vitobruncic-blip/zavrsni/dokumenti/zavrsni.tex

\documentclass[12pt, a4paper, oneside]{report}

% Podrška za hrvatski jezik (važno za kvačice i nazive poput "Sadržaj")
\usepackage[utf8]{inputenc}
\usepackage[english, croatian]{babel}
\usepackage[T1]{fontenc}

\usepackage[margin=1.25cm]{geometry} % Postavi margine prema Word predlošku
\usepackage{setspace}
\onehalfspacing % Prored 1.5

\usepackage[scaled]{helvet}
\renewcommand*\familydefault{\sfdefault} % Postavlja bezserifni font kao zadani za cijeli dokument

\begin{document}
\begin{titlepage}
    \begin{center}
        \setstretch{1.0} % Resetiraj prored na 1 za naslovnicu
        
        \Large SVEUČILIŠTE U ZAGREBU \\[0.2cm]
        \textbf{\Large FAKULTET ELEKTROTEHNIKE I RAČUNARSTVA}
        
        \vfill % Gura sadržaj prema sredini
        
        \large ZAVRŠNI RAD br. 72
        
        \vspace{2cm}
        
        % Naslov mora biti boldan i velik
        \textbf{\huge BATERIJSKO MJERILO SNAGE PRIMLJENOG SIGNALA ZA SUSTAV ZA FOTOPLETIZMOGRAFIJU} \\[0.3cm]
        
        \vspace{1.5cm}
        
        \large Vito Brunčić
        
        \vfill % Gura dno stranice prema dolje
        
        \large Zagreb, lipanj 2026. % Ažurirao sam na tvoju trenutnu godinu
        
    \end{center}
\end{titlepage}

% Nakon naslovnice resetiraj prored na 1.5 ako ti je to uvjet za tekst
\onehalfspacing 
\newpage
