vitobruncic-blip/zavrsni/dokumenti/Bruncic_Vito.docx

SVEUČILIŠTE U ZAGREBU

FAKULTET ELEKTROTEHNIKE I RAČUNARSTVA

ZAVOD ZA ELEKTRONIČKE SUSTAVE I OBRADBU INFORMACIJA

PROJEKT IZ PREDMETA
PROJEKTIRANJE ELEKTRONIČKIH SUSTAVA

BATERIJSKO MJERILO SNAGE PRIMLJENOG SIGNALA ZA SUSTAV ZA FOTOPLETIZMOGRAFIJU

Student: Vito Brunčić

JMBAG: 0036557057

Zagreb, 11.6.2026

# Sadržaj

# 1. Područje primjene i namjena uređaja

Uređaj „Baterijsko mjerilo snage primljenog signala za sustav za pletizmografiju“, namjenjen je za detekciju i kvantifikaciju snage primljenog analognog signala u sustavima koji koriste tehnologiju komunikacije ljudskim tijelom (engl. Intra-Body Communication – IBC). Primarna funckija uređaja je dohvat i analogna obrada fotopletizmografskih signala. Fotopletizmografija je metoda optičkog bilježenja promjene volumena, a u kontekstu ovog uređaja, dohvaćeni fotopletizmografski signal bilježi promjene volumena krvi.

Područje primjene ovog uređaja obuhvaća domenu biomedicinskog inženjerstva te služi kao eksperimentalna platforma za razvoj i testiranje nosivih medicinskih senzora za neinvanzivno praćenje vitalnih parametara. Sustav također nalazi primjenu kao alat za provjeru pouzdanosti prijenosa signala kroz ljudsko tkivo.

Izvedba uređaja s baterijskim napajanjem omogućuje potpuno galvansko odvajanje od distribucijske električne mreže, čime se smanjuje utjecaj mrežnih smetnji i popratnog šuma okoline. Takva izvedba omogućuje visoku osjetljivost i preciznost mjerenja signala niskih amplituda, što je ujedno i temeljni preduvjet za pouzdano korištenje tehnologije komunikacija ljudskim tijelom.

# 2. Blok shema

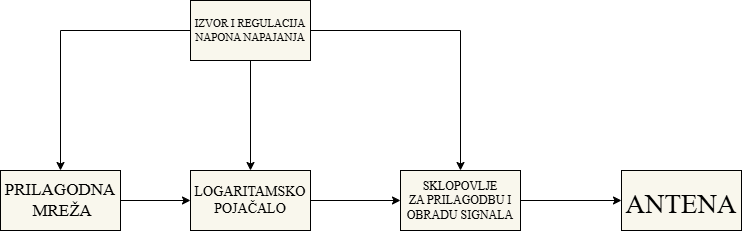
[picture p1: figure]

# 3. Električka shema

Slika 1: Hierarhijski prikaz kompletne električne sheme uređaja

Slika 2: Ulazna prilagodna mreža

Slika 3: Logaritamsko pojačalo

Slika 4: Sklopovlje za prilagodbu i obradu signala (Mikrokontroler STM32WB55CGU6)

Slika 5: Antena

Slika 6: Izvor i regulacija napona napajanja

# 4. Opis rada

I. ULAZNA PRILAGODNA MREŽA

Ulazna prilagodna mreža smještena je na početku sustava te služi za prilagodbu impedancije između prijenosnog medija i visokog ulaznog otpora sljedećeg stupnja. Integrirani sklop BUF602ID služi za transformaciju impedancije te izolaciju osjetljivog ulaznog signala. Sklop karakterizira visoka ulazna impedancija koja spriječava gušenje IBC signala s ljudskog tijela, te niska izlazna impedancija koja dodatno ne opterećuje ulaz logaritamskog pojačala. Uz propusni opseg od 250 MHz i brzinu odziva (engl. slew rate) od 8000 V/µs, BUF602ID omogućuje linearan prijenos napona nosioca od 21 MHz bez unošenja faznih izobličenja ili dodatne atenuacije.

II. LOGARITAMSKO POJAČALO

Na ulazu u logaritamsko pojačalo nalazi se još jedna prilagodna mreža koja se sastoji od otpora 52.3 Ω te dva paralelna kapaciteta od 100 nF koja služe za prilagodbu prijenosa na 50 Ω kako ne bi dolazilo do neželjene refleksije signala. Logaritamsko pojačalo AD8310 radi u pojasu do 440 MHz te može uspješno pojačati vrlo niske amplitude ulaznog napona. Na primjer, ako na ulazu u pojačalo imamo signal amplitude 22,4 mVrms, to jest ulazna snaga je -33 dBV, na izlazu ćemo prema formuli (4.1.), gdje je VY = 24 mV/dB ujedno i nagib našeg pojačala, a P0 = -108 dBV (3,98 µV), vrijednost pri kojoj će naš izlaz biti 0 V, dobiti ćemo izlazni napon VOUT = 1,8 V.

, V_(OUT) =V_Y ×(P_(IN) -P_0 )#(4.1.)

Kondenzatori C8 i C28 od 22 pF služe nam za filtriranje izlaza (BFIN priključak) te određivanje izlaznog niskopropusnog filtra (OFLT priključak). Oba kondenzatora su određena formulama koje se mogu pronači u tehničkoj specifikaciji logaritamskog pojačala.

III. SKLOPOVLJE ZA PRILAGODBU I OBRADU SIGNALA

Iz izlaza logaritamskog pojačala dolazimo do Schmittovog okidnog sklopa, 74AHC1G17GWH, kojem je primarna funkcija eliminirati šum koji može stvarati velike pogreške u obradi IBC signala koji su vrlo često niskih amplituda. Schmittov okidni sklop radi na principu histereze, s time da u odnosu na komparator, ima dva praga okida pomoću kojih eliminiramo mogućnost krivog očitanja impulsa. Mikrokontroler STM32WB55CGU6 prima signal preko priključka PA4 te se programira putem razvojnog okruženja STM32CubeIDE. Program se postavlja na samu jedinicu putem priključaka SWDIO i SWCLK. Testne točke PA8 i PA9 služe za provjeru ispravnosti rada mikrokontrolera. Takitilni prekidač S1 služi za paljenje i gašenje mikrokontrolera, a kao indikator rada služi svjetleća dioda D1, kojoj smo ograničili jačinu svijetlosti s otpornikom od 1500 Ω, te koja svijetli zeleno kada je mikrokontroler upaljen. Kristalni osicilator Y1 služi za zadavanje takta mikrokontroleru dok kristalni oscilator Y2 služi kao referenca vremena (engl. RTC signal). Kondenzatori od 100 nF i 100 pF služe kao blokadni kondenzatori za suzbijanje smetnji i kao skladište naboja u slučaju brzih promjena na ulazu sklopovlja, a mreža zavojnica i kondenzatora između pinova VLXSMPS I VFBSMPS služi kao prateći elementi internog SMPS pretvarača (engl. Step-down/buck) koje smo morali postaviti jer se na samom siliciju čipa mikrokontrolera one ne mogu postaviti.

IV. ANTENA

Iz priključka RF1 odlazimo do ulaza na integrirani prilagodni filtar harmonika (engl. Integrated Passive Device – IPD) koji služi za povezivanje između mikrokontrolera i prilagodne mreže antene za 2,4 GHz, odnosno Bluetooth prijenos. IPD1 također služi kao balun, to jest pretvornik diferencijalnog signala koji dobivamo na izlazu iz mikrokontrolera u nesmietrični 50-omski signal za antenu. Prije same antene postavljena je pasivna mreža na točno propisanim udaljenostima na tiskanoj pločici koje prilagođavaju signal na 50 Ω te garantiraju da ne dolazi do neželjenih refleksija signala.

V. IZVOR I REGULACIJA NAPONA NAPAJANJA

Kao primarni izvor napona koristi se Li-Ion akumulator nazivnog napona 3,7 V koji je izabran je prema ukupnoj potrošnji svih integriranih sklopova te nazivnom naponu koji mora biti dovoljno blizu naponu na izlazu iz stabilizatora kako se na njemu ne bi stvorila nepotrebno velika disipacija. Izračunata maksimalna ukupna potrošnja svih integriranih sklopova u sustavu je 24mA, te smo stoga izabrali akumulator čiji kapacitet pokriva minimalno 12 sati rada pritom imajući na umu da akumulator nije poželjno potpuno isprazniti jer se tako smanjuje njegova dugovječnost. Akumulator se spaja na sklop za održavanje i punjenje baterije BQ24040DSQR. Na njega je spojen USB-C konektor preko kojeg se baterija puni iz nekog drugog uređaja, primjerice iz računala. Moderni USB-C punjači ne daju nikakav napon sve dok ne osjete da je s druge strane spojen uređaj te upravo tome služe otpornici R12 i R14, koji su spojeni na masu te se ponašaju kao trošilo pa samim time USB-C punjač iz drugog uređaja krene davati stabilan napon VBUS. Otpornik R15 definira struju brzog punjenja, koju smo s otpornikom od 2200 Ω ograničili na 250 mA, čime smo osigurali stabilan omjer brzine punjena i potencijalnog pregrijavanja. Otpornik R11 definira struju završetka punjenja, kojim smo limitirali tu struju na 10% struje brzog punjenja, odnosno na 25 mA. Otpornici R10 i R12 su termistori koji mjenjaju otpor u odnosu na zagrijavanje sklopa te su postavljeni kako bi sklop registrirao konstantu idealnu temperaturu od 25 ⁰C. Svjetleća dioda D2 i otpornik R13 postavljeni su kako bi signalizirali ispravan rad izvora napajanja, a otpornikom R6 postavili smo da je maksimalna struja punjenja određena isključivo otpornikom R15. Linearni regulator TPS73633DBVR služi kako bi 3,7 V iz izvora napajanja pretvorio u stabilnih 3,3V koji su dovoljni za napajanje cijelog uređaja, a ostali kondenzatori su propisani iz tehničkih specifikacija samih sklopovlja kao optimalne zalihe naboja usred naglih promjena. Svjetleća dioda D3 i njen pridruženi otpornik R20 služe kao indikator ispravanog rada linearnog regulatora.

# 5. Tehnički podaci

I. NAPAJANJE I BATERIJA
- Vrsta napajanja: Li-Ion baterija, 3,7 V
- Nazivni kapacitet: 400mAh
- Napon analognog i digitalnog dijela: 3,3 V
- Prosječna struja potrošnje: 24mA
- Očekivano vrijeme rada s jednim ciklusom punjena: 17h
II. ANALOGNA OBRADA I KARAKTERISTIKE SIGNALA
- Frekvencija primljenog signala: 21 MHz
- Prilagodna mreža: 50 Ω
- Široki dinamički raspon: -91 dBV do 4 dBV
- Frekvencijski opseg izlaznog signala: 0 Hz do 2,1 MHz
III. MIKROKONTROLER I DIGITALNA OBRADA SIGNALA
- Model mikrokontrolera: STM32WB55CGU6
- Radni takt: 64 MHz
- Rezolucija AD-pretvornika: 12 bita
- Kapacitet programske memorije: 1 MB Flash
- Komunikacijsko sučelje: Bluetooth 5.4, (Bluetooth Low Energy – BLE)
IV. FIZIČKE I MEHANIČKE KARAKTERSTIKE
- Dimenzije tiskane pločice: 50 mm x 48 mm
- Broj slojeva tiskane pločice: 4 sloja
- Debljina pločice: 1,6 mm

# 6. Uputstvo za uporabu

I. PRIPREMA UREĐAJA I PROVJERA NAPAJANJA
- Provjera stanja baterije: Prije početka eksperimenta, potrebno je provjeriti je li uređaj napunjen, to jest, svijetli li svjetleća dioda BAT. Ukoliko ne svijetli potrebno je spojiti uređaj preko USB-C priključka na bilo koji uređaj sposoban za punjenje (prijenosno ili stolno računalo, punjač za mobitel sa USB-C izlazom) te pričekati dok se uređaj ne napuni.
II. POSTAVLJANJE SENZORA NA ISPITANIKA
- Priprema kože: mjesto na tijelu ispitanika gdje se postavlja elektroda potrebno je očistiti medicinskim alkoholom kako bi se smanjio otpor kože.
- IBC elektrode koja se spaja na SMA priključak uređaja treba biti čvrsto priljubljena uz kožu
III. POKRETANJE SUSTAVA I MJERENJE
- Prvo pokretanje: Prilikom prvog pokretanja uređaja potrebno je postaviti program preko SWDIO I SWCLK priključaka.
- Uključivanje uređaja: Pritisnite tipku označenu s USER na tiskanjoj pločici za pokretanje uređaja. Nakon nekoliko sekundi trebala bi zasvijetliti svjetleća dioda MCU koja označava da STM32WB55CGU6 mikrokontroler radi.
- Očitavanje i prijenos podataka: Za očitavanje i prijenos podataka potrebno je spojiti vanjsko računalo preko Bluetooth protokola sa mikrokontrolerom te pokrenuti aplikaciju za akviziciju podataka.
IV. ISKLJUČIVANJE I SKLADIŠTENJE
- Nakon završetka korištenja, isključite uređaj pritiskom tipke USER na tiskanoj pločici te pričekajte isključenje svjetleće diode MCU. Tako osiguravate duboko pražnjenje baterije.
- Pažljivo odvojite elektrode s tijela ispitanika te ih očistite suhom krpom ili maramicom.
- Uređaj skladištite na suhom i tamnom mjestu, izvan dohvata jakih elektromagnetskih smetnji koje bi s vremenom mogle utjecati na točnost uređaja.

# 7. Sastavnica

Redni broj | Vrijednost | Oznaka komponente | Kućište | Opis | Oznaka proizvodača | Dobavljač | Cijena komponente (EUR) | Količina
1. | STM32WB55CGU6 | U3 | UFQFPN-48 | STM32 Mikrokontroler, 1,7-3,6V | STM32WB55CGU6 | Mouser | 7.06 | 1
2. | BUF602 | U1 | SOIC-8 | Integrirani Buffer | BUF602ID | Mouser | 5.82 | 1
3. | AD8310ARMZ-REEL7 | U2 | MSOP | Logaritamsko pojačalo | AD8310ARMZ-REEL7 | Mouser | 12.34 | 1
4. | BQ24040DSQR | U4 | WSON-10 | Sklop za punjenje, 800mA | BQ24040DSQR | Mouser | 0.79157 | 1
5. | TPS73633DBVR | U5 | SOT-23 | IC Regulator, 3,3V, 400mADC | TPS73633DBVR | Mouser | 2.16 | 1
6. | 74AHC1G17GWH | U6 | SOT353-1 | Integrirani Schmittov okidni sklop | 74AHC1G17GWH | Mouser | 0.10325 | 1
7. | MLPF-WB55-01E3 | IPD1 | SMD-6, 1,6x1 mm | RF Filtar, 2.4-2.5GHz | MLPF-WB55-01E3 | Mouser | 0.31835 | 1
8. | 2450AT18B100E | A1 | SMD-2, 3,8x1,8mm | Antena, 2.45GHz | 2450AT18B100E | Mouser | 1.39 | 1
9. | NX2016SA-32MHz | Y1 | 0805 | Kristalni oscilator 32KHz | NX2016SA-32M-EXS00A-CS06465 | Mouser | 0.499 | 1
10. | NX2012SA-32.768kHz | Y2 | 0805 | Kristalni oscilator, 32.768KHz | NX2012SA-32.768K-STD-MUB-1 | Mouser | 0.73134 | 1
11. | MPZ2012S601AT000 | FB1 | 0805 | Feritna perla, 600Ohm | MPZ2012S601AT000 | Mouser | 0.09464 | 1
12. | Zelena | D1, D2, D3 | 0805 | Dioda, svjetleća, 1,9V | SM0805GCL | Mouser | 0.499 | 3
13. | 100n | C1, C2, C3, C6, C7, C13, C14, C15, C16, C17, C19, C21, C24, C29, C30, C31 | 0805 | Kondenzator, X7R, 10%, 50VDC | MCJCU21GBB7104KTPA01 | Mouser | 0.215 | 16
14. | 10n | C5, C25 | 0805 | Kondenzator, C0G, 10%, 50VDC | C0805C103K5RECAUTO | Mouser | 0.2151 | 2
15. | 22p | C8, C28 | 0402 | Kondenzator, C0G, 1%, 50VDC | KAM05ACG1H220FH | Mouser | 0.27533 | 2
16. | 15p | C10, C11 | 0805 | Kondenzator, C0G, 10%, 160VDC | 08052U150JAT2A | Mouser | 0.30114 | 2
17. | 10u/16V | C12 | 1210 | Elektrolitski kondenzator, Ta, 10%, 16V | EEV106M035A9DAA | Mouser | 0.28393 | 1
18. | 4u7 | C18, C22 | 0805 | Kondenzator, C0G, 10%, 50VDC | CGA4J1X7R1H475K125AC | Mouser | 0.48182 | 2
19. | 100p | C20 | 0402 | Kondenzator, C0G, 2%, 100VDC | GCM1555C2A101GE02D | Mouser | 0.10325 | 1
20. | 1p2 | C23 | 0402 | Kondenzator, C0G, 10%, 50VDC | QSCF500Q1R2B1GV001T | Mouser | 0.13766 | 1
21. | 1u | C26, C27 | 0603 | Kondenzator, X7R, 10%, 50VDC | C1608X7R1H105K080AB | Mouser | 0.18929 | 2
22. | 10u | L1 | 0805 | Zavojnica, neoklopljena, 500mADC, | LSQBA201212T100KR | Mouser | 0.10325 | 1
23. | 10n | L2 | 0805 | Zavojnica, neoklopljena, +/-5%, 300mADC | AIMC-0805-10NJ-T | Mouser | 0.11185 | 1
24. | 3n3 | L3 | 0402 | Zavojnica, neoklopljena, 400mADC | L-07C3N6SV6T | Mouser | 0.163 | 1
25. | 2n7 | L4 | 0402 | RF zavojnica, neoklopljena, 300mADC | LRC0402CS2N7GV001T | DigiKey | 0.08604 | 1
26. | 49R9 | R1, R3, R7, R9 | 0805 | Otpornik, ±100ppm/C, 125mW | AC0805FR-0749R9L | Mouser | 0.01032 | 4
27. | 2k | R2, R11 | 0805 | Otpornik, 1%, 125mW | RC0805FR-102KL | Mouser | 0.01635 | 2
28. | 4R7 | R4 | 0805 | Otpornik, 1%, 125mW | AC0805FR-074R7L | Mouser | 0.08604 | 1
29. | 52R3 | R5 | 0805 | Otpornik, 1%, 125mW | RC0805FR-0752R3L | Mouser | 0.08604 | 1
30. | 0R0 | R6, R18, R19, R22 | 0603 | Otpornik, 1%, 100mW | MCMR04X000 PTL | Farnell | 0.00401 | 5
31. | 10k | R8 | 0805 | Otpornik, 5%, 125mW | RC0805JR-0710KL | Mouser | 0.18929 | 1
32. | 10k | R10 | 0402 | NTC Termistor, 1% | NTCG103JF103FT1 | Mouser | 0.08604 | 1
33. | 5k1 | R12, R14 | 0603 | Otpornik, ±100ppm/C, 100mW | AC0603FR-075K1L | Mouser | 0.01032 | 2
34. | 1k5 | R13, R16, R20 | 0805 | Otpornik, ±50ppm/C, 100mW | MCU08050C1501FP500 | Mouser | 0.07403 | 3
35. | 2k2 | R15 | 0805 | Otpornik, ±100ppm/C, 125mW | MCU08050C1501FP500 | Mouser | 0.07403 | 1
36. | 10k | R21 | TH-2, 3,7x2,54 mm | NTC Termistor, 1% | 103AT-2 | Mouser | 0.538 | 1
37. | USB4135-GF-A | J1 | SMD-10, 11,14x6,78mm | USB-C priključak | USB4135-GF-A | Mouser | 0.58507 | 1
38. | TL3301AF160QG | S1 | SMD-4, 6x6mm | Taktilni prekidač | TL3301AF160QG | Mouser | 0.29254 | 1
39. | 4POS HDR | X2 | SMD-10, 16x2,5mm | Header 1x4 | 68001-204HLF | Mouser | 0.34416 | 1

# 9. Položajni nacrt komponenata

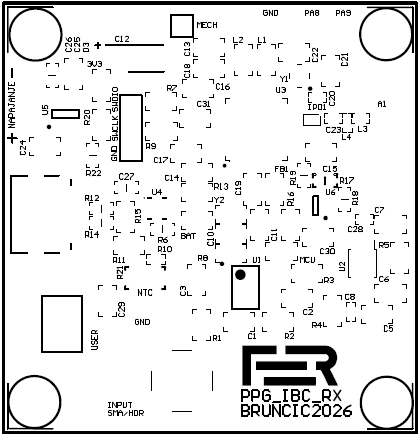
[picture p2: figure]

Slika 7: Položajni nacrt komponenata – Komponentna (engl. top) strana; mjerilo M2:1

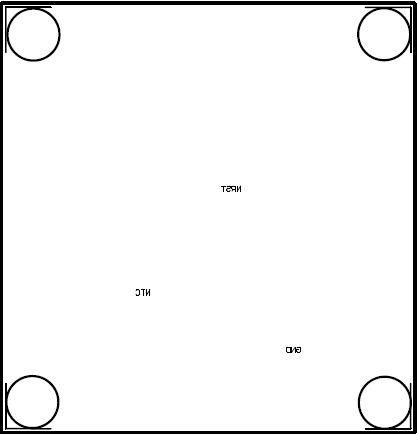
[picture p3: figure]

Slika 8: Položajni nacrt komponenata - Lemna (engl. bottom) strana; mjerilo M2:1

# 10. Nacrt tiskanih veza

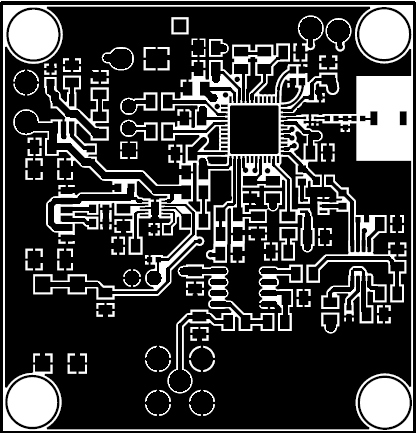
[picture p4: figure]

Slika 9: Nacrt tiskanih veza - Komponentna (engl. top) strana; mjerilo M2:1

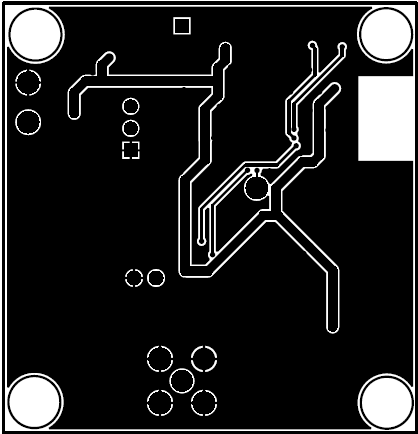
[picture p5: figure]

Slika 10: Nacrt tiskanih veza - Lemna (engl. bottom) strana; mjerilo M2:1

# 11. Plan bušenja

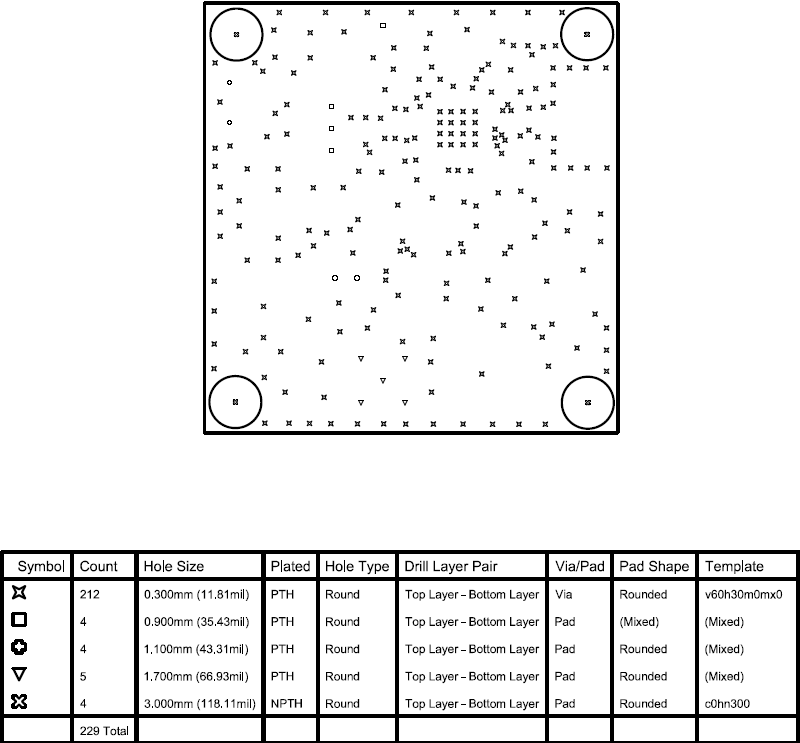
[picture p6: figure]

Slika 11: Plan bušenja; mjerilo M2:1

Vito Brunčić, 0036557057 8

Vito Brunčić, 0036557057 11

Projektiranje elektroničkih sustava
