vitobruncic-blip/zavrsni/dokumenti/zavrsni_VB_ver3.pdf

### SVEUCILIŠTE U ZAGREBU ˇ FAKULTET ELEKTROTEHNIKE I RACUNARSTVA ˇ

### ZAVRŠNI PROJEKT

# BATERIJSKO MJERILO SNAGE

# PRIMLJENOG SIGNALA ZA

# SUSTAV ZA

# FOTOPLETIZMOGRAFIJU

### Vito Brunci ˇ c´

Zagreb, srpanj 2026.

Zahvaljujem mentorici izv. prof. dr. sc. Željki Luˇcev Vasi´c i asistentu Luki Klai´cu

na ukazanom povjerenju, struˇcnom vodstvu i steˇcenom znanju tijekom ovog projekta.

Hvala obitelji, curi Luciji i prijateljima na podršci tijekom dosadašnjeg studija.

iii

## SADRŽAJ

1. Uvod | 1
2. Teorijska podloga | 3
3. Arhitektura prijamnika sustava za fotopletizmografiju | 6
3.2. Logaritamsko pojacalo | ˇ | 7
4. Opis tiskane plocice | 13 ˇ
4.1. Fizikala svojstva plocice i raspored komponenata | ˇ | 13
4.3. Upute za korištenje plocice | ˇ | 16
5. Rezultati | 18
6. Zakljucak | 19 ˇ
Literatura | 20
7. Prilog A: Tehnicka dokumentacija | 23 ˇ

iv

# 1. Uvod

Kardiovaskularne bolesti i dalje su vodeci uzrok smrtnosti u svijetu, što stvara impera- ´

tiv za razvojem neinvazivnih, jeftinih i pouzdanih metoda za pracenje rada srca i cirku- ´

lacije. Eksponencijalni razvoj nosivih (engl. wearable) senzorskih sustava za kontinu-

irano pracenje vitalnih znakova pacijenta potaknuo je promjenu u svijetu biomedicin- ´

ske elektronike. Tradicionalne metode pracenja zdravstvenog stanja unutar bolni ´ | ckih ˇ

uvjeta sve se više zamjenjuju personaliziranim, autonomnim uredajima koji omogu- ¯

cuju dugotrajni nadzor pacijenata u njihovom svakodnevnom okruženju. Dva klju ´ | | cna ˇ
stupa takvih sustava cine fotopletizmografija (engl. ˇ | photoplethysmography, PPG) kao

metoda senziranja te komunikacija unutar ljudskog tijela (IBC) kao inovativna metoda

prijenosa podataka.

U klasicnim nosivim mrežama, BAN (engl. ˇ | | Body Area Network), prijenos podataka

izmedu senzora na tijelu i centralne jedinice (poput pametnog telefona) u pravilu se os- ¯

lanja na radiofrekvencijske (RF) tehnologije kao što su Bluetooth Low Energy (BLE)

ili Wi-Fi. Iako su standardizirane, RF tehnologije pokazuju znacajne nedostatke u ne- ˇ

posrednoj blizini ljudskog tijela. Ljudsko tkivo vecinskim se dijelom sastoji od vode, ´

koja snažno apsorbira i raspršuje RF signale na frekvencijama oko 2,4 GHz. Stoga,

zbog velikog slabljenja u tkivu, RF odašiljaci moraju trošiti znatnu energiju iz baterije ˇ

kako bi osigurali pouzdanu vezu. Takoder, RF valovi zra ¯ | ce u svim smjerovima oko ˇ
tijela, omogucuju ´ | ci potencijalno prisluškivanje (engl. ´ | eavesdropping) osjetljivih medi-

cinskih podataka.

Kao odgovor na te probleme razvija se komunikacija unutar ljudskog tijela (IBC), koja

koristi samo ljudsko tijelo kao prijenosni medij (vodic) za elektri ˇ | cne signale. Elektro- ˇ

magnetsko polje ostaje u potpunosti "zakljucano" unutar i neposredno uz površinu ti- ˇ

jela. Prednosti IBC-a u odnosu na RF su znatno manje gušenje na nižim frekvencijama

(tipicno od nekoliko stotina kHz do nekoliko desetaka MHz), gdje tkivo pruža stabil- ˇ

niji i povoljniji medij. Buduci da signal ne mora zra ´ | citi u slobodan prostor, sklopovi ˇ

za IBC odašiljace i prijamnike mogu raditi s višestruko manjom potrošnjom energije, ˇ

što drasticno produljuje vijek trajanja baterije. IBC komunikacija tako ˇ | | der osigurava ¯

visoku dozu privatnosti podataka jer se signal ne širi izvan tijela, cime se postiže har- ˇ

dverska imunost na prisluškivanje s udaljenosti.

U drugom poglavlju ovog završnog rada biti ce objašnjena teorijska podloga potrebna ´

za razumijevanje fotopletizmografije i prijenosa signala ljudskim tijelom. Nakon toga,

bit ce dan opis arhitekture pojedinih dijelova prijamnika signala za sustav za fotople- ´

tizmografiju. U cetvrtom poglavlju bit ˇ | ce opisana tiskana plo ´ | cica razvijena u sklopu ˇ

ovog završnog rada. U danjim poglavljima bit ce opisani rezultati mjerenja na sustavu ´

te ce se iz tih mjerenja izvesti zaklju ´ | cci. U prilogu je dana tehni ˇ | cka dokumentacija ˇ

razvijene tiskane plocice. ˇ

# 2. Teorijska podloga

## 2.1. Princip fotopletizmografije

Fotopletizmografija (PPG) je opticka metoda koja se koristi za neinvazivno mjerenje ˇ

promjena u volumenu krvi unutar mreže kapilara u tkivu. Sama metoda temelji se na

Beer-Lambertovom zakonu, koji definira matematicki odnos izme ˇ | du apsorpcije svje- ¯

tlosti i svojstava medija kroz koji svjetlost prolazi. Prema tom zakonu, intenzitet tran-

smitiranog svjetla eksponencijalno opada s koncentracijom apsorbirajuce tvari i dulji- ´

nom optickog puta. ˇ

U ljudskom tkivu, primarni apsorber (kromofor) u crvenom i infracrvenom spektru je

hemoglobin u krvi. Kako srce pumpa krv kroz tijelo, stvara se pulsni val koji uzro-

kuje periodicke promjene u volumenu arterijske krvi unutar tkiva (npr. u prstu ili ušnoj ˇ

resici). Te promjene volumena izravno moduliraju kolicinu svjetlosti koja se apsor- ˇ

bira, odnosno propušta kroz tkivo. Rezultirajuci fotopletizmogram sastoji se od dvije ´

kljucne komponente: istosmjerne i izmjeni ˇ | cne komponente. Istosmjerna (engl. DC ˇ | ,

Direct Current) predstavlja konstantnu apsorpciju svjetlosti u staticnim strukturama ˇ

kao što su kosti, mišici, koža, te konstantni volumen venske krvi. Ova komponenta ´

stvara relativno visok istosmjerni napon na izlazu fotodetektora. Izmjenicna (engl. ˇ | AC,

Alternating Current) predstavlja dinamiku pulsnih promjena volumena arterijske krvi

sinkroniziranih sa srcanim ciklusom (sistola i dijastola). Ova komponenta je iznimno ˇ
male amplitude, tipicno ˇ | cine ˇ | ci svega ´ | 1% do 2% ukupnog detektiranog signala.
Upravo ta kombinacija izmjenicne i istosmjerne komponente ˇ | cini temelj za pulsnu ˇ
oksimetriju – metodu neinvazivnog mjerenja zasicenosti krvi kisikom SpO ´ | 2. Buduci´

da oksihemoglobin HbO2 i deoksihemoglobin Hb razlicito apsorbiraju svjetlost u cr- ˇ

venom (tipicno ˇ | 660 nm) i infracrvenom spektru (tipicno ˇ | 940 nm), pulsni oksimetar

mjeri amplitude AC i DC komponenti na obje valne duljine. Izracunom omjera tih ˇ

komponenti, poznatijeg kao ”omjer omjera” (engl. ratio-of-ratios), eliminira se utjecaj

staticnih tkiva i izolira se isklju ˇ | civo doprinos arterijske krvi, što omogu ˇ | cuje precizno ´
odredivanje udjela zasi ¯ | cenog hemoglobina. ´

Zbog tako nepovoljnog omjera AC i DC komponente, primarni inženjerski izazov pri

projektiranju pripadajuceg PPG poja ´ | cala bio je razvoj analognog sklopa koji ˇ | ce us- ´
pješno izolirati i pojacati isklju ˇ | civo slabašnu AC komponentu koja nosi informaciju ˇ

promjeni volumena krvi, dok istovremeno prigušuje DC komponentu koja u kontekstu

fotopletizmografije, ne sadrži bitnu informaciju.

## 2.2. Kapacitivni IBC

Komunikacija unutar ljudskog tijela (engl. IBC, Intra-Body Communication) predstav-

lja inovativan pristup bežicnim mrežama na tijelu (BAN) gdje se ljudsko tkivo koristi ˇ

kao medij za prijenos elektricnog signala. Za razliku od klasi ˇ | cnih radiofrekvencijskih ˇ

(RF) antena koje energiju zrace u slobodan prostor oko korisnika, IBC sustavi lokali- ˇ

ziraju elektromagnetsko polje na samo tijelo. S fizikalnog stajališta, ljudsko se tijelo

ponaša kao kompleksni vodic s izraženim dielektri ˇ | cnim svojstvima, sastavljen od vode, ˇ

elektrolita i organskih makromolekula. Na frekvencijama koje se koriste u IBC teh-

nologiji (100 kHz do nekoliko desetaka MHz) unutrašnjost tijela pruža znatno znatno

vodljiviji put u usporedbi sa slobodnim prostorom oko tijela, što omogucuje prijenos ´

podataka uz višestruko manju potrošnju energije na strani odašiljaca. Ovisno o na ˇ | cinu ˇ

na koji se signal injektira u tijelo i kako se zatvara strujni krug, IBC se dijeli na dvije

osnovne metode: galvanski i kapacitivni pristup.

U ovom završnom radu naglasak je stavljen na kapacitivni IBC sustav. Kod kapaci-

tivnog pristupa, odašiljac i prijamnik koriste diferencijalnu konfiguraciju sa samo po ˇ

dvije elektrode (signalna i referentna), koje ne moraju nužno biti u izravnom galvan-

skom kontaktu s kožom (moguce je mjerenje kroz odje ´ | cu). Primarni fizikalni mehani- ´

zam zatvaranja strujnog kruga odvija se kroz povratnu vezu koju te plutajuce elektrode ´

formiraju preko sitnih parazitnih kapaciteta spregnutih izmedu tijela korisnika i uzem- ¯

ljenja.

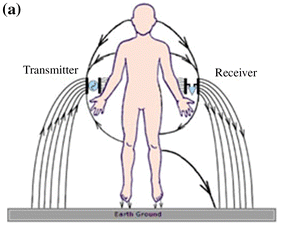
[picture p7: figure]

Slika 2.1. a) Prijenosni put kapacitivne IBC metode. [4]

Buduci da su ti parazitni kapaciteti iznimno mali (reda veli ´ | cine nekoliko pikofarada), ˇ

povratna veza predstavlja iznimno visoku impedanciju, što uzrokuje drastican pad am- ˇ

plitude signala na strani prijamnika. Zbog slabljenja signala i utjecaja vanjskog šuma,

ulazni stupanj prijamnika mora imati vrlo visoku ulaznu impedanciju te koristiti osjet-

ljiva pojacala širokog dinami ˇ | ckog raspona kako bi se primljeni signal uspješno rekons- ˇ

truirao.

# 3. Arhitektura prijamnika sustava za

# fotopletizmografiju

Baterijsko mjerilo snage primljenog signala za sustav za fotopletizmografiju sastoji se

od 5 dijelova:

1. Ulazna prilagodna mreža
2. Logaritamsko pojacalo ˇ
3. Sklopovlje za prilagodbu i obradu signala (Schmittov okidni sklop i mikrokontroler)
4. Antena
5. Izvor i regulacija napona napajanja

Uloga i nacin rada pojedinih dijelova detaljno su opisane u narednim poglavljima. Na ˇ

slici 3.1. prikazana je blok shema prijamnika signala za sustav za fotopletizmografiju.

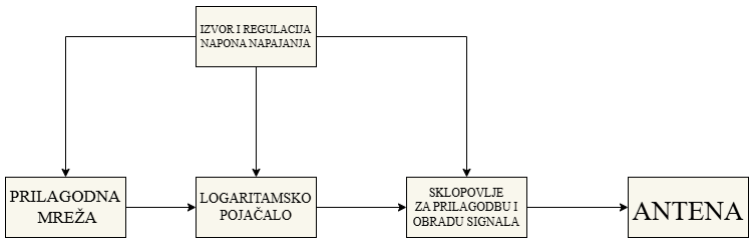
[picture p8: figure]

Slika 3.1. Blok shema prijamnika signala za sustav za fotopletizmografiju.

## 3.1. Ulazna prilagodna mreža

Ovaj prijamnik je dizajniran tako da na njegov ulaz dolazi fotopletizmografski signal

koji se prenosi pomocu signala nosioca od ´ | 21 MHz te je njegova amplituda modulirana

OOK modulacijskim postupkom (engl. On/Off keying amplitude modulation). Ulazna

prilagodna mreža smještena je na pocetku sustava te služi za prilagodbu impedancije ˇ

izmedu prijenosnog medija i visokog ulaznog otpora sljede ¯ | ceg stupnja. Zamišljeno je ´
da se signal dovodi preko SMA konektora koji je prilagoden na impedanciju od ¯ | 50 Ω

te se zbog toga prilagodna mreža svakog stupnja projektira za tu impedanciju. Alterna-

tivno, umjesto SMA prikljucka može se zalemiti klasi ˇ | cni muški priklju ˇ | cak na mjesto ˇ
središnjeg izvoda SMA konektora uz korištenje dodatnog muškog prikljucka ˇ | X4 za
mehanicku stabilizaciju. Za potrebu prilago ˇ | denja koriste se otpornici ¯ | R1 i R3 iznosa

49,9 Ω.

Naponsko slijedilo BUF602ID proizvoda¯ caˇ Texas Instruments služi za transformaciju

impedancije te izolaciju osjetljivog ulaznog signala. Sklop karakterizira visoka ulazna

impedancija koja sprjecava gušenje IBC signala s ljudskog tijela, te niska izlazna im- ˇ

pedancija koja dodatno ne opterecuje ulaz logaritamskog poja ´ | cala. Uz propusni opseg ˇ

od 250 MHz i brzinu porasta (engl. slew rate) od 8000 V/µs, BUF602ID omogucuje li- ´

nearan prijenos napona nosioca od 21 MHz bez unošenja faznih izoblicenja ili dodatne ˇ

atenuacije. Na slici 3.2. dana je blok shema korištenog naponskog slijedila. Otpornik

od 2 kΩ služi kako bi zajedno s kondenzatorom od 1 µF cinio visokopropusni filtar ˇ

prvog reda te postavlja staticke radne to ˇ | cke unutrašnjih tranzistora. ˇ

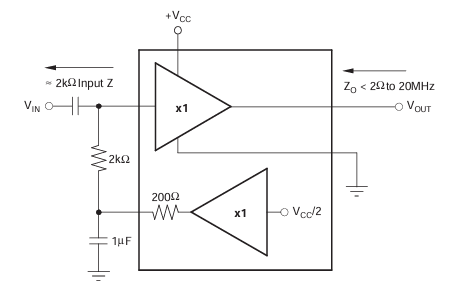
[picture p9: figure]

Slika 3.2. Blok shema naponskog sljedila BUF602ID. [6]

## 3.2. Logaritamsko pojacalo ˇ

Na ulazu u logaritamsko pojacalo nalazi se još jedna prilagodna mreža koja se sastoji ˇ

od otpornika otpora 52,3 Ω te dva kondenzatora od 100 nF koja zajedno impedancijom izvoda INHI i INLO služe za prilagodbu prijenosa na 50 Ω kako ne bi dolazilo do

neželjene refleksije signala. Odabrano logaritamsko pojacalo AD8310, proizvo ˇ | da¯ caˇ

Analog Devices radi u pojasu do 440 MHz te može uspješno pojacati vrlo niske am- ˇ

plitude ulaznog napona. Na slici 3.3. prikazan je osnovni preporuceni spoj za AD8310 ˇ

koji se nalazi u tehnickoj specifikaciji (engl. ˇ | datasheet) uredaja [1]. ¯

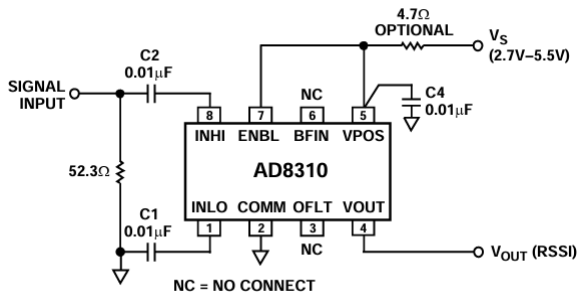
[picture p10: figure]

Slika 3.3. Osnovni spoj logaritamskog pojacala AD8310. [1] ˇ

Veza izmedu ulazne snage i izlaznog napona danog logaritamskog poja ¯ | cala dano je ˇ

jednadžbom (3.1.) .
VOUT = VY · (PIN − P0) | (3.1.)

gdje VOUT predstavlja izlazni demodulirani i filtrirani napon, VY = 24 mV/dB je nagib

prijenosne karakteristike pojacala (engl. ˇ | slope voltage), PIN je snaga ulaznog signala
izražena u dBm, dok P0 = −108 dBV (3,98 µVrms) vrijednost pri kojoj ce naš izlaz ´

biti 0 V, tj. presjecište karakteristike s osi snage (engl. intercept). Na primjer, ako na
ulazu u pojacalo imamo signal amplitude ˇ | 22,4 mVrms, to jest ulazna snaga je −33 dBV,
na izlazu cemo prema formuli (3.1.) dobiti izlazni napon ´ | VOUT = 1,8 V.
Kondenzator C8 spaja se na prikljucak ˇ | BFIN kako bi se smanjila nominalna širina

frekvencijskog pojasa izlaznog signala i time uspješno prigušilo valoviti dio napona

(engl. ripple) na izlazu logaritamskog pojacala. Prema preporuci proizvo ˇ | da¯ ca, njegova ˇ

vrijednost se odabire tako da granicna frekvencija filtra bude postavljena na jednu de- ˇ

setinu minimalne frekvencije ulaznog signala, cime se postiže optimalno filtriranje uz ˇ

ocuvanje brze reakcije sklopovlja na promjene razine signala, a za našu aplikaciju to je ˇ

frekvencija od 2,1 MHz. Prema formuli (3.2.) iz tehnicke specifikacije logaritamskog ˇ

pojacala [1] odredili smo približan iznos danog kapaciteta od ˇ | 22 pF.

CFILT =

1
2π · 3 kΩ · VideoBandwidth
− 2,1 pF | (3.2.)

Kondenzator C28 spaja se na prikljucak ˇ OFLT kako bi se snizila granicna frekvencija ˇ

unutarnje petlje za poništavanje istosmjernog pomaka (engl. offset control loop), cime ˇ

se sprjecava da ˇ | cip korisne ulazne signale nižih frekvencija pogrešno protuma ˇ | ci kao ˇ

ulazni napon pomaka i priguši. Njegova vrijednost je izracunata prema formuli (3.3.) ˇ

koja se takoder nalazi u tehni ¯ | ckoj specifikaciji logaritamskog poja ˇ | cala AD8310 [1]. ˇ
Za fCORNER je uzeta vrijednost od 2,1 MHz pri cemu je ˇ | COFLT = 22pF biran prema E12

nizu.

fCORNER =

1
2π · 2625 · COFLT

(3.3.)

## 3.3. Schmittov okidni sklop i mikrokontroler

Primarna funkcija Schmittovog okidnog sklopa 74AHC1G17GV, proizvoda¯ caˇ Nexpe-

ria je minimizirati smetnju i šum koji može stvarati eventualne pogreške pri analogno

digitalnoj konverziji i digitalizaciji signala za potrebe prijenosa na mikrokontroler. Sc-

hmittov okidni sklop radi na principu histereze, tj. u odnosu na klasicni komparator ˇ

ima dva praga okidanja pomocu kojih se eliminira mogu ´ | cnost krivog o ´ | citanja impulsa ˇ

uzrokovanih šumom. Prijenosna karakteristika te primjer obrade jednog tipa ulaznog

signala dani su slikom 3.4..

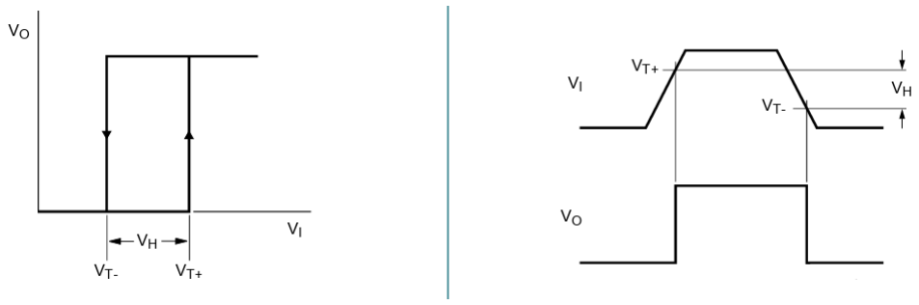
[picture p11: figure]

Slika 3.4. Prijenosna karakteristika (lijevo) i primjer rada Schmittovog okidnog sklopa

(desno). [3]

Mikrokontroler STM32WB55CGU6, proizvoda¯ caˇ STMicroelectronics prima signal putem izvoda PA4 te se programira putem razvojnog okruženja STM32CubeIDE. Pro-

gramski kod se ucitava u mikrokontroler putem izvoda ˇ | SWDIO i SWCLK. Korisnicke ˇ
ispitne tocke ˇ | PA8 i PA9 služe za provjeru ispravnosti rada mikrokontrolera. Slicno ˇ
tome, implementirana je i ispitna tocka za opcionalno spajanje na ˇ | NRST izvod mikro-

kontrolera. Tipkalo USER služi za paljenje i gašenje mikrokontrolera, a kao indikator

rada služi svjetleca dioda ´ | MCU, cija je ja ˇ | cina svjetlosti ograni ˇ | cena otpornikom od ˇ

1500 Ω.

Oscilator Y1 služi za zadavanje glavnog takta mikrokontroleru, dok kristal Y2 služi kao

referenca vremena (engl. RTC, Real-Time Clock signal). Kondenzatori od 100 nF i

100 pF služe kao blokadni kondenzatori za suzbijanje smetnji i kao skladište naboja u

slucaju naglih propada napona napajanja, a mreža zavojnica i kondenzatora izme ˇ | du iz- ¯
voda VLXSMPS i VFBSMPS služi kao prateci elementi internog prekida ´ | ckog izvora ˇ

napajanja (engl. SMPS, Switch Mode Power Supply) propusne topologije (engl. buck,

step-down) koje smo morali postaviti izvan cipa jer se na samom siliciju mikrokon- ˇ

trolera oni ne mogu realizirati. Vrijednosti tih elemenata propisane su u tehnickoj ˇ

dokumentaciji [5]. U tablici 3.1. navedeni su neki od kljucnih podataka i obilježja ˇ

mikrokontrolera STM32WB55CGU6.

Tablica 3.1. Tehnicke specifikacije mikrokontrolera STM32WB55CGU6. ˇ

Parametar | | Vrijednost
Model mikrokontrolera | | STM32WB55CGU6
Radni takt | | 64 MHz
Rezolucija AD-pretvorbe | 12 bita

Kapacitet programske memorije 1 MB Flash

Komunikacijsko sucelje | Bluetooth 5.4 ( ˇ | Bluetooth Low Energy – BLE)
Napon napajanja | 3,3 V

## 3.4. Antena

Iz prikljucka ˇ RF1 odlazimo do ulaza na integrirani prilagodni filtar harmonika (engl. In-

tegrated Passive Device - IPD) koji služi za povezivanje izmedu mikrokontrolera i pri- ¯

lagodne mreže antene za 2,4 GHz, odnosno za Bluetooth prijenos.
Sklop IPD1 takoder služi kao balun, to jest pretvornik diferencijalnog signala dobive- ¯
nog na izlazu iz mikrokontrolera u asimetricni ˇ | 50-omski signal za antenu. Prije same
antene postavljena je pasivna prilagodna mreža koje prilagodava karakteristi ¯ | cnu im- ˇ

pedanciju puta signala na 50 Ω te minimizira neželjene refleksije (bolje reci tako jer ´

nažalost ne garantira, ovisi o PCB dizajnu, kucištima komponenata, poziciji antene, ´

okolnim vodljivim objektima i sl.). Tocni modeli komponenata i dimenzije vodova ˇ

propisani su u tehnickoj dokumentaciji antene [2], a njihov je raspored prikazan na ˇ

slici 3.5.

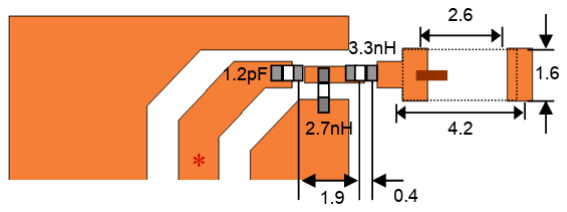
[picture p12: figure]

Slika 3.5. Razmještaj komponenta na tiskanoj plocici. [2] ˇ

## 3.5. Izvor i regulacija napona napajanja

Kao primarni izvor napajanja koristi se litij-ionski akumulator nazivnog napona 3,7 V,

koji se spaja na integrirani krug za upravljanje i punjenje akumulatora BQ24040DSQR.

Na sklop je povezan USB-C prikljucak putem kojega se akumulator može puniti iz ˇ

vanjskog izvora, primjerice racunala. ˇ

Moderni USB-C punjaci ne isporu ˇ | cuju napon na sabirnicu sve dok ne detektiraju pri- ˇ
sutnost spojenog uredaja s druge strane kabela. Upravo tomu služe otpornici ¯ | R12 i R14
spojeni na CC1 i CC2 linije prema masi; ti otpornici pritegnuti na masu (engl. pull-

down) djeluju kao konfiguracijski otpornici za detekciju, nakon cega izvor prepoznaje ˇ

prikljuceni ure ˇ | daj i aktivira stabilan napon ¯ | VBUS od 5 V.

Otpornik R15 definira struju brzog punjenja (fast-charge current) prema formuli (3.4.)

koja je zajedno s koeficijentom KISET = 550 AΩ dana u tehnickoj specifikaciji [7]. ˇ

Odabirom otpornika od 2200 Ω struja brzog punjenja je ogranicena na ˇ | 250 mA (1C

za pretpostavljeni akumulator), cime se osigurava optimalan omjer brzine punjenja i ˇ

toplinske disipacije.
| | RISET = KISET IOUT
(3.4.)

Otpornik R11 definira struju završetka punjenja (termination current), kojom je ta vrijednost postavljena na 10 % struje brzog punjenja, odnosno na 25 mA. Otpornici

R10 i R21 su NTC (engl. negative temperature coefficient) termistori za kontaktno

pracenje temperature akumulatora. U svrhu pove ´ | canja fleksibilnosti dizajna, imple- ´
mentirana je mogucnost korištenja površinski montiranog termistora ´ | R10 (engl. SMD,
surface-mounted device) u 0402 kucištu te NTC termistora ´ | R21 sa žicanim izvodima ˇ

(engl. through-hole). NTC termistori odabrani su sukladno preporukama proizvoda¯ ca.. ˇ

Svjetleca dioda ´ | D2 s pripadajucim otpornikom ´ | R13 služi za vizualnu signalizaciju sta-
tusa punjenja. Postavljanjem otpornika R6 iznosa 0 Ω na ISET2 izvodu definirano je
da je maksimalna struja punjenja odredena isklju ¯ | civo otpornikom ˇ | R15.

Linearni regulator s malim padom napona (engl. Low-Dropout Regulator, LDO)

TPS73633DBVR koristi se kako bi se napon akumulatora transformirao u stabilnih

3,3 V potrebnih za napajanje cijelog sustava. LDO regulatori su podskupina linear-

nih regulatora napona kojima je glavna karakteristika niski pad napona (engl. dropout

voltage), stoga je ta porodica linearnih regulatora idealan izbor u ovakvom sustavu.

Preostali kondenzatori u ulaznom i izlaznom krugu regulatora odabrani su prema pre-

porukama proizvoda¯ ca te služe za stabilizaciju napona i osiguranje lokalne zalihe na- ˇ

boja uslijed naglih promjena potrošnje. Svjetleca dioda ´ | D3 i njezin pridruženi otpornik

R20 služe kao indikator prisutnosti napajanja od 3,3 V na izlazu linearnog regulatora.

# 4. Opis tiskane plocice ˇ

## 4.1. Fizikala svojstva plocice i raspored komponenata ˇ

Baterijsko mjerilo snage primljenog signala za sustav za fotopletizmografiju imple-

mentirano je na cetveroslojnoj tiskanoj plo ˇ | cici. Na slici 4.1. prikazan je poredak i ˇ

fizikalna svojstva pojedinog sloja. Unutarnji slojevi su slojevi koji predstavljaju refe-

rentni potencijal mase dok su tiskane veze izmedu komponenata ostvarene na gornjem, ¯

komponentnom (engl. Top) i donjem, lemnom (engl. Bottom) sloju. Tiskana plocica je ˇ

dimenzija 50 mm x 48 mm te je debljine 1,6 mm.

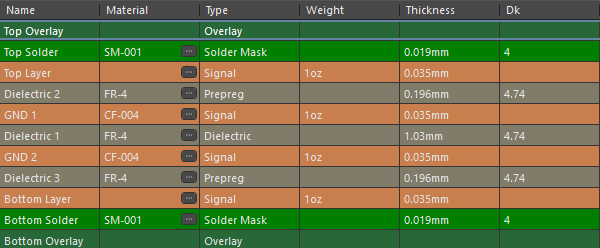
[picture p13: figure]

Slika 4.1. Prikaz slojeva tiskane plocice. ˇ

Plocica se može podijeliti na nekoliko funkcionalnih cjelina ˇ | ciji je raspored ozna ˇ | cen ˇ

na slici 4.2.:

1. Ulazna prilagodna mreža
2. Logaritamsko pojacalo ˇ
3. Sklopovlje za prilagodbu i obradu signala (Schmittov okidni sklop i mikrokontroler)
4. Antena
5. Izvor i regulacija napona napajanja

6. Ulazni prikljucci i mehani ˇ | cka tipkala ˇ

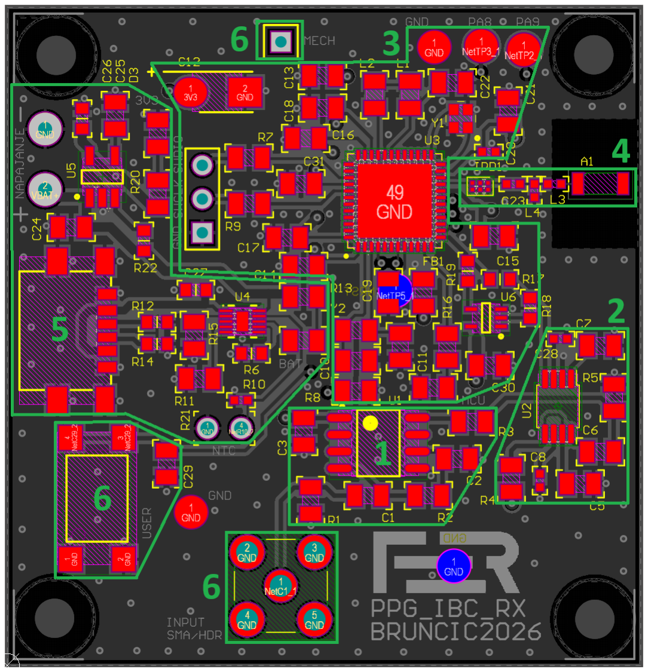
[picture p14: figure]

Slika 4.2. Raspored pojedinih cjelina po tiskanoj plocici. ˇ

Na slikama 4.3. i 4.4. prikazan je raspored komponenata s oznacenim funkcional- ˇ

nim cjelinama. Na tiskanoj plocici nalazi se nekoliko dijelova koji se mogu prilagoditi ˇ

ovisno o potrebi korisnika. Ulazni signal može se dovoditi preko SMA prikljucka, no ˇ

moguce je na njegovo mjesto postaviti i standardni muški konektor. U tom slu ´ | | caju ˇ
mehanicku stabilnost osigurava dodatno mjesto za priklju ˇ | cak na gornjoj strani plo ˇ | cice ˇ
koje je takoder ozna ¯ | ceno s brojem 6. Na baterijskom prijamniku nalazi se nekoliko ˇ

kontrolnih tocaka, a neke od njih služe za ispitivanje nultog potencijala (mase), dok ˇ ispitna tocka ˇ NRST služi za mogucnost vanjskog resetiranja mikrokontrolera. Ostale ´

ispitne tocke i njihove svrhe opisane su u prethodnim poglavljima. Na rubovima plo- ˇ

cice projektirane su rupe za ˇ | M3 vijke ukoliko je prijamnik potrebno postaviti u kucište. ˇ

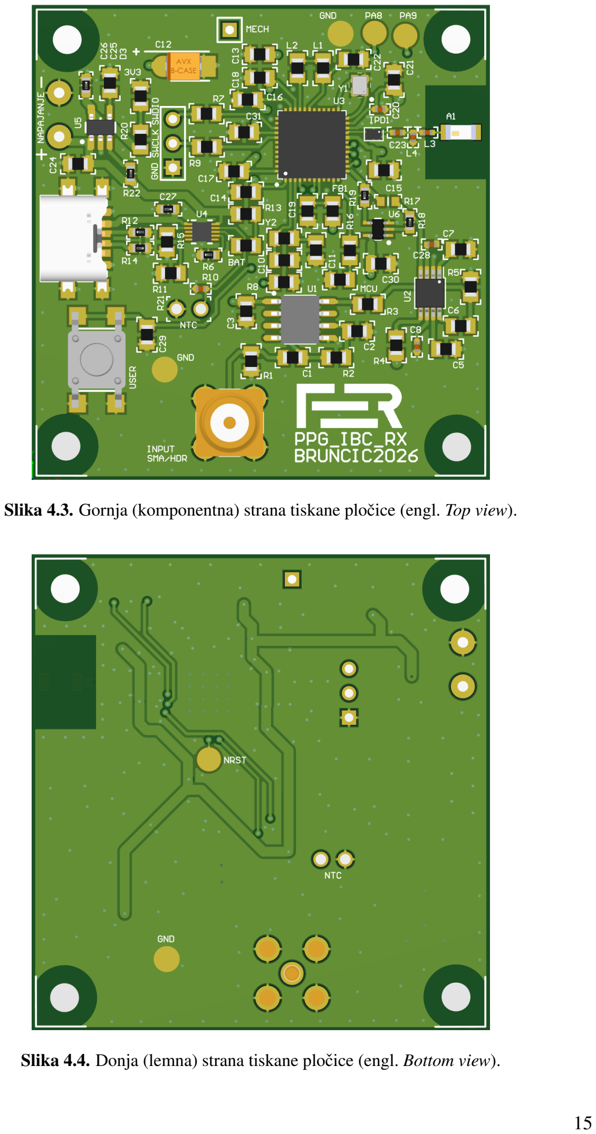
[picture p15: page 18]

Slika 4.3. Gornja (komponentna) strana tiskane plocice (engl. ˇ | Top view).
Slika 4.4. Donja (lemna) strana tiskane plocice (engl. ˇ | Bottom view).

## 4.2. Potrošnja i odabir akumulatora

Prikaz maksimalnih potrošnja pojedinog integriranog sklopovlja korištenom u ovom

sustavu dano je tablicom 4.1.

Integrirani sklop | Maksimalna potrošnja
AD8310 | 10 mA
BUF602 | 6,3 mA
STM32WB55CGU6 | 5,17 mA
LDO regulator | 1 mA*
BQ24040 | 1 mA

Schmittov okidni sklop 0,01 mA

* Vrijednost potrošnje kada se sklop puni, inaceˇ 1 µA

Tablica 4.1. Maksimalna potrošnja pojedinih integriranih sklopova.

Ukupna potrošnja je zbroj svih maksimalnih potrošnji te je prema tome izabran aku-

mulator koja ima dovoljan kapacitet. Konkretno, radi se o litij-ionskoj tehnologiji

akumulatora nazivnog napona 3,7 V koji se pomocu linearnog regulatora stabilizira ´

na 3,3 V. Prema jednadžbi (4.1.) odreden je minimalni kapacitet akumulatora, a kao ¯

vrijeme rada sklopa uzimamo minimalno 12 sati. U formulu se dodaje i koeficijent

sigurnosti ksig kojim se osigurava da se akumulator prilikom svakog duljeg korištenja

ne isprazni u potpunosti, jer se time smanjuje njegov životni vijek. Imajuci to na umu, ´

izabran je akumulator s vec ugra ´ denom zaštitom, jer je litij vrlo reaktivan element, i ¯

kapacitetom od 400mAh.

Cmin = Iukupno · tukupno · ksig | (4.1.)

## 4.3. Upute za korištenje plocice ˇ

Prije pocetka eksperimenta, potrebno je provjeriti je li ure ˇ | daj napunjen, to jest, svije- ¯
tli li svjetleca dioda ´ | BAT. Ukoliko ne svijetli potrebno je spojiti uredaj preko ¯ | USB-C
prikljucka na bilo koji ure ˇ | daj sposoban za punjenje (prijenosno ili stolno ra ¯ | cunalo, ˇ
punjac za mobitel s ˇ | USB-C izlazom) te pricekati dok se ure ˇ | daj ne napuni. Prilikom ¯
prvog pokretanja uredaja potrebno je postaviti program putem ¯ | SWDIO I SWCLK pri-
kljucaka. Za o ˇ | citavanje i prijenos podataka potrebno je spojiti vanjsko ra ˇ | cunalo putem ˇ

Bluetooth protokola sa mikrokontrolerom te pokrenuti aplikaciju za akviziciju poda-

taka. Nakon završetka korištenja, iskljucite ure ˇ | daj pritiskom tipke USER na tiskanoj ¯

plocici te pri ˇ | cekajte isklju ˇ | cenje svjetle ˇ | ce diode ´ | MCU. Uredaj skladištite na suhom i ¯

tamnom mjestu.

# 5. Rezultati

to cu na kraju kada izmjerimo kako radi i to ´

# 6. Zakljucak ˇ

i to ostavljam za kraj

## LITERATURA

[1] AD8310: | Fast, Voltage-Out DC to 440 MHz Demodulating Logarithmic
Amplifier. | Analog Devices, rev. f izdanju, 2010. | Dostupno na: https:

//www.analog.com/media/en/technical-documentation/

data-sheets/AD8310.pdf.

[2] 2450AT18B100E: 2.4 GHz High Frequency Ceramic Chip Antenna. | Jo-
hanson Technology, full specifications izdanju, 2021. | Dostupno na:

https://www.mouser.com/catalog/specsheets/johanson_

2450AT18B100E.pdf.

[3] 74AHC1G17; 74AHCT1G17: Single Schmitt-trigger buffer. | Nexperia, rev.
12 izdanju, 2023. | Dostupno na: https://assets.nexperia.com/

documents/data-sheet/74AHC_AHCT1G17.pdf.

[4] Francois Rivet, Nick Owen, Daniel Lai, i Yann Deval. Intra-body communica-

tions: radio-frequency versus ultrasonic. Analog Integrated Circuits and Signal

Processing, 87:289–299, 05 2016. doi: 10.1007/s10470-015-0659-z.

[5] STM32WB55CC STM32WB55CE STM32WB55CG STM32WB55CI Multipo-

int wireless MCU data sheet. STMicroelectronics, rev. 11 izdanju,

2024. Dostupno na: https://www.st.com/resource/en/datasheet/

stm32wb55cc.pdf.

[6] BUF602 High-Speed, Closed-Loop Buffer. Texas Instruments, sbos312d izdanju,

2019. Dostupno na: https://www.ti.com/lit/ds/symlink/buf602.

pdf.

[7] BQ2404x 800-mA, Single-Input, Single-Cell Li-Ion Battery Charger. Texas Instru-

ments, slus941k izdanju, 2021. Dostupno na: https://www.ti.com/lit/

ds/symlink/bq24040.pdf.

BATERIJSKO MJERILO SNAGE PRIMLJENOG SIGNALA ZA SUSTAV ZA

FOTOPLETIZMOGRAFIJU

Sažetak

Fotopletizmografija je jedna od neinvazivnih metoda mjerenja promjene volumena

krvi. U ovom završnom projektu objašnjena je teorijska podloga potrebna za razumije-

vanje prijenosa signala ljudskim tijelom pomocu kapacitivne IBC metode te je naprav- ´

ljen pregled arhitekure prijamnika snage za sustav za fotopletizmografiju. Arhitektura

sustava temelji se na logaritamskom pojacalu AD8310 proizvo ˇ | da¯ caˇ Analog Devices

te mikrokontroleru STM32WB55CGU6 proizvoda¯ caˇ STMicroelectronics. Realizirana

je tiskana plocica baterijskog prijamnika snage dimenzija ˇ | 50 mm x 48 mm koja obra-
dene podatke šalje preko Bluetooth 5.4 tehnologije na ra ¯ | cunalo. Sustav se napaja iz ˇ

litij-ionskog akumulatora nazivnog napona 3,7 V (i ostalih karakteristika koje cemo ´

saznati). (recenica ili dvije o rezultatima mjerenja i zaklju ˇ | cku tj kakva je primjena i ˇ

jeli je uopce ima). ´

Kljucne rije ˇ | ci: ˇ fotopletizmografija, prijenos signala ljudskim tijelom (IBC), kapaci-

tivna IBC metoda, OOK, logaritamsko pojacalo, Bluetooth, litij-ionski akumulator ˇ

BATTERY-POWERED RECEIVED SIGNAL STREGTH METER FOR A

PHOTOPLETHYSMOGRAPHY SYSTEM

Abstract

Photoplethysmography is one of the non-invasive methods for measuring blood

volume changes. This bachelor’s thesis explains the theoretical background required

to understand signal transmission through the human body using the capacitive IBC

method and provides an overview of the power receiver architecture for a photoplethy-

smography system. The system architecture is based on the AD8310 logarithmic am-

plifier manufactured by Analog Devices and the STM32WB55CGU6 microcontoller

manufactured by STMicroelectronics. A printed circuit board for the battery-powered

receiver has been realized with dimensions of 50 mm x 48 mm, which transmits the

processed data to a computer via Bluetooth 5.4 technology. The system is powered by

a lithium-ion battery with a nominal voltage of 3,7 V (i ostalih karakteristika koje cemo ´

saznati). (recenica ili dvije o rezultatima mjerenja i zaklju ˇ | cku tj kakva je primjena i ˇ

jeli je uopce ima). ´

Keywords: photoplethysmography, intra-body communication, capacitive IBC met-

hod, OOK, logarithmic amplifier, Bluetooth, lithium-ion battery,

# 7. Prilog A: Tehnicka dokumentacija ˇ

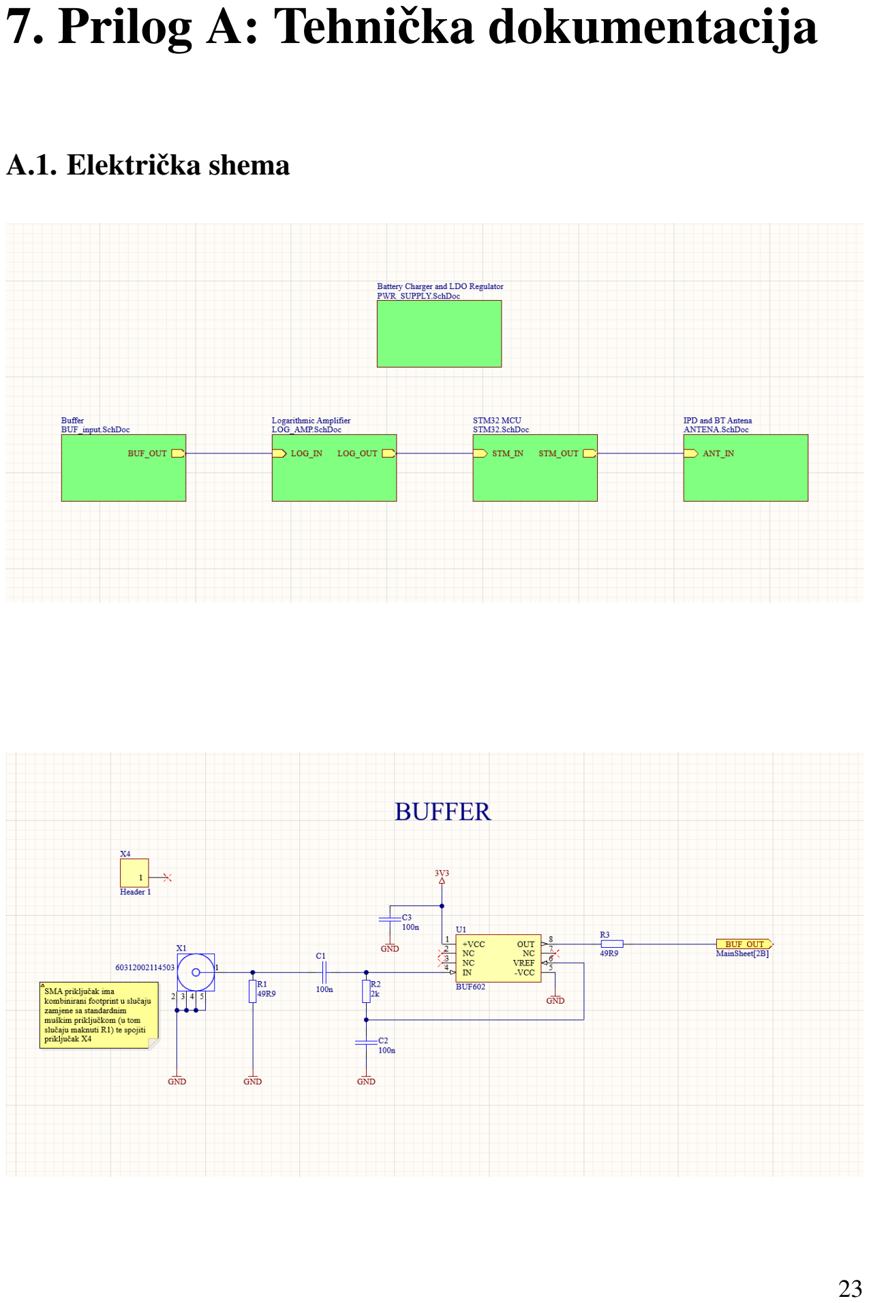
[picture p16: page 26]

### A.1. Elektricka shema ˇ

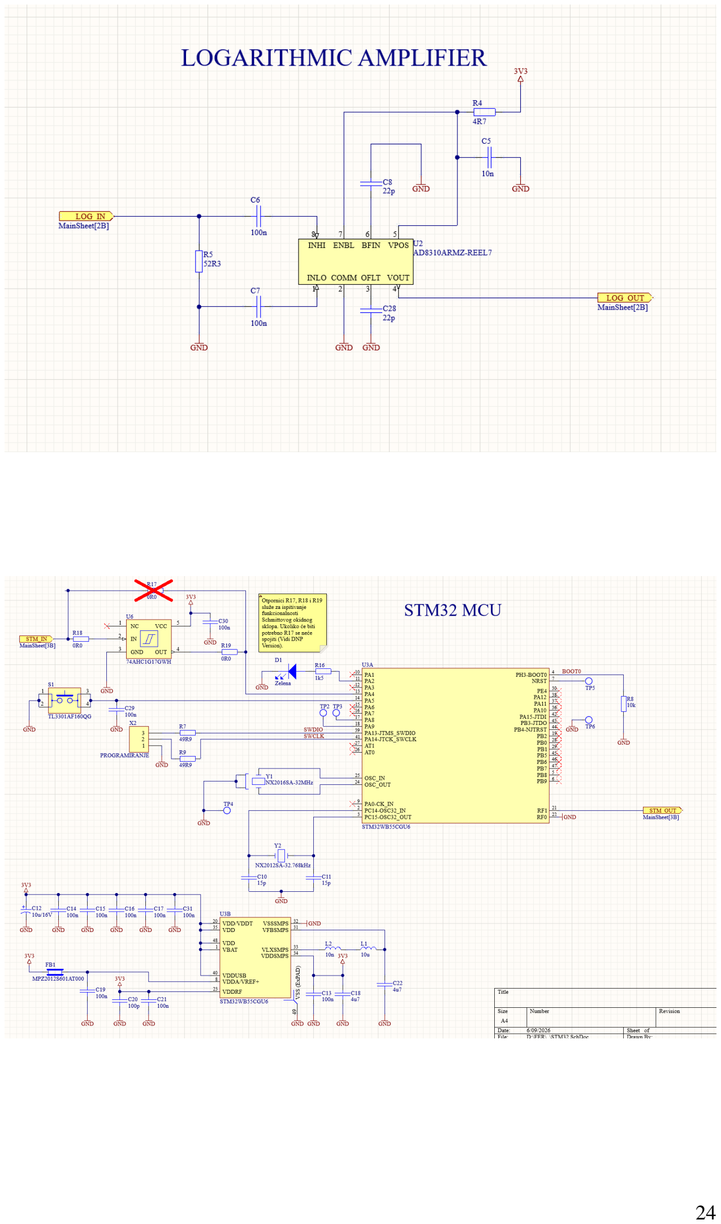
[picture p17: page 27]
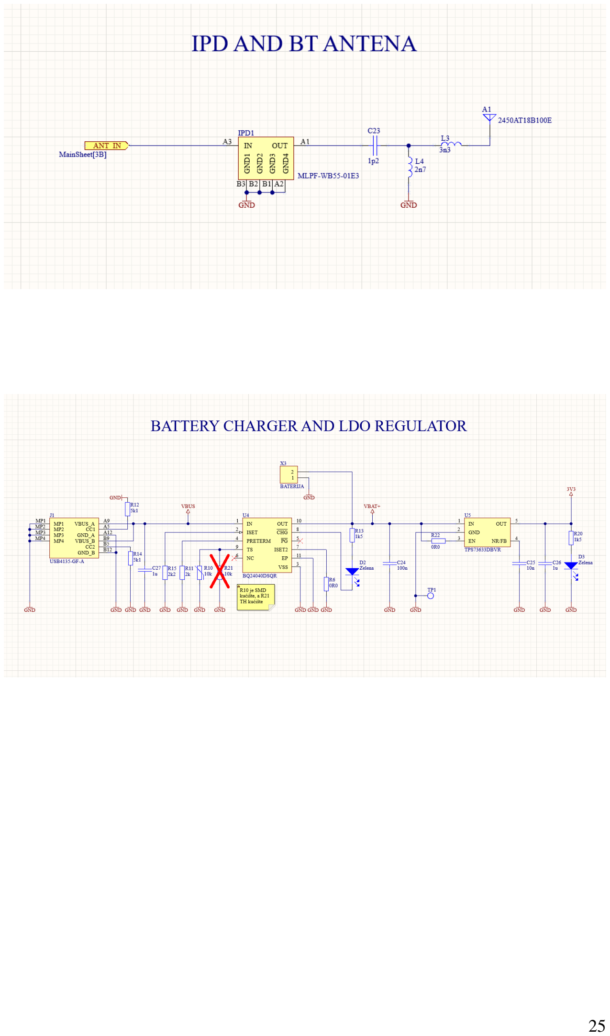
[picture p18: page 28]

### A.3. Nacrt tiskanih veza na komponentnoj strani (Top)

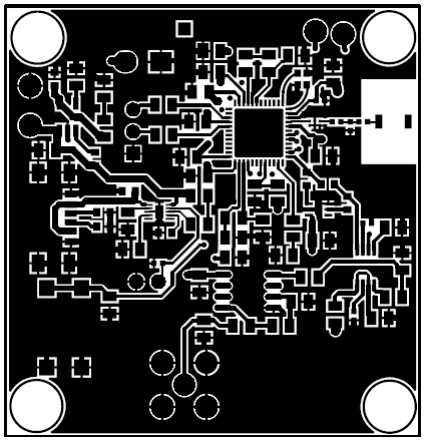
[picture p19: figure]

### A.3. Nacrt tiskanih veza na lemnoj strani (Bottom)

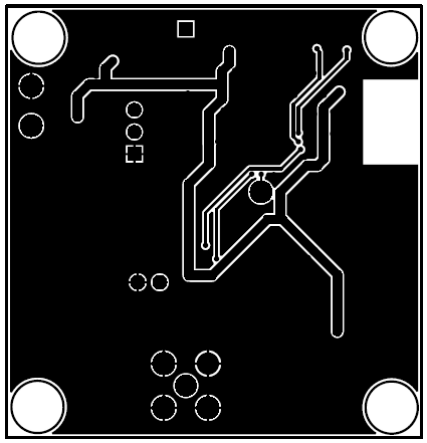
[picture p20: figure]

### A.4. Položajni nacrt komponenata

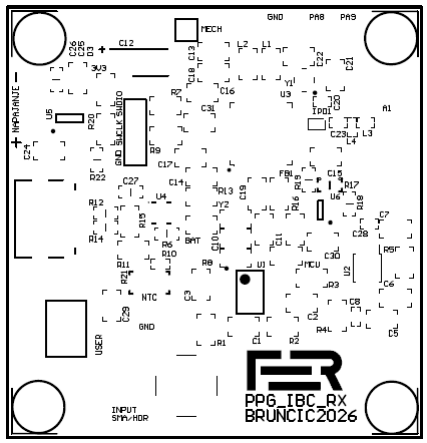
[picture p21: figure]

### A.5. Plan bušenja


### A.7. Sastavnica

R. br. | Vrijednost | Kucište ´ | Opis | Kataloški broj | Cijena (C) | Kol. | Ukupno (C)
1. | STM32WB55CGU6 | UFQFPN-48 | STM32 Mikrokontroler, 1,7-3,6V | 511-STM32WB55CGU6 | 7,06 | 1 | 7,06
2. | BUF602 | SOIC-8 | Integrirani Buffer | 595-BUF602ID | 5,82 | 1 | 5,82
3. | AD8310ARMZ-REEL7 | MSOP | Logaritamsko pojacalo ˇ | 584-AD8310ARMZ-R7 | 12,34 | 1 | 12,34
4. | BQ24040DSQR | WSON-10 | Sklop za punjenje akumulatora, 800mA | 595-BQ24040DSQR | 0,79157 | 1 | 0,9157
5. | TPS73633DBVR | SOT-23 | IC Regulator, 3,3V, 400mADC | 595-TPS73633DBVR | 2,16 | 1 | 2,16
6. | 74AHC1G17GWH | SOT353-1 | Integrirani Schmittov okidni sklop | 771-74AHC1G17GWH | 0,10325 | 1 | 0,10325
7. | MLPF-WB55-01E3 | SMD-6, 1,6x1 mm | RF Filtar, 2,4-2,5GHz | 511-MLPF-WB55-01E3 | 0,31835 | 1 | 0,31835
8. | 2450AT18B100E | SMD-2 | Antena, 2,45GHz | 609-2450AT18B100E | 1,39 | 1 | 1,39
9. | NX2016SA-32MHz | 0805 | Kristalni oscilator, 32KHz | 644-1375-1-ND | 0,499 | 1 | 0,499
10. | NX2012SA-32,768kHz | 0805 | Kristalni oscilator, 32,768KHz | 344-NX2012SA32768K1 | 0,73134 | 1 | 0,73134
11. | MPZ2012S601AT000 | 0805 | Feritna perla, 600Ohm | 810-MPZ2012S601AT000 | 0,09464 | 1 | 0,09464
12. | Zelena LED | 0805 | Svjetleca dioda, 1,9V ´ | 749-SM0805GCL | 0,499 | 3 | 1,497
13. | 100n | 0805 | Kondenzator, X7R, 10%, 50VDC | 963-MCJCU21GBB7104KT | 0,215 | 16 | 3,44
14. | 10n | 0805 | Kondenzator, C0G, 10%, 50VDC | 80-C0805C103K5RECAUT | 0,2151 | 2 | 0,4302
15. | 22p | 0402 | Kondenzator, C0G, 1%, 50VDC | 581-KAM05ACG1H220FH | 0,27533 | 2 | 0,55066
16. | 15p | 0805 | Kondenzator, C0G, 10%, 160VDC | 581-08052U150J | 0,30114 | 2 | 0,60228
17. | 10u/16V | 1210 | Elektrolitski kondenzator, Ta, 10%, 16V | 80-EEV106M035A9DAA | 0,28393 | 1 | 0,28393
18. | 4u7 | 0805 | Kondenzator, C0G, 10%, 50VDC | 810-CGA4J1X7R1H475K1 | 0,48182 | 2 | 0,96365

30

R. br. | Vrijednost | Kucište ´ | Opis | Kataloški broj | Cijena (C) | Kol. | Ukupno (C)
19. | 100p | 0402 | Kondenzator, C0G, 2%, 100VDC | 81-GCM1555C2A101GE2D | 0,10325 | 1 | 0,10325
20. | 1p2 | 0402 | Kondenzator, C0G, 10%, 50VDC | 609-QSCF500Q1R2B1GV0 | 0,13766 | 1 | 0,13766
21. | 1u | 0603 | Kondenzator, X7R, 10%, 50VDC | 810-C1608X7R1H105K08 | 0,18929 | 2 | 0,37858
22. | 10u | 0805 | Zavojnica, neoklopljena, 500mADC | 963-SQBA201212T100K | 0,10325 | 1 | 0,10325
23. | 10n | 0805 | Zavojnica, neoklopljena, 300mADC | 815-AIMC-0805-10NJT | 0,11185 | 1 | 0,11185
24. | 3n3 | 0402 | Zavojnica, neoklopljena, 400mADC | 609-L-07C3N3SV6T | 0,163 | 1 | 0,163
25. | 2n7 | 0402 | RF zavojnica, neoklopljena, 300mADC | 712-LRC0402CS2N7GV001T | 0,08604 | 1 | 0,08604
26. | 49R9 | 0805 | Otpornik, ±100ppm/C, 125mW | 603-AC0805FR-0749R9L | 0,01032 | 4 | 0,10325
27. | 2k | 0805 | Otpornik, 1%, 125mW | 603-RC0805FR-102KL | 0,01635 | 2 | 0,16348
28. | 4R7 | 0805 | Otpornik, 1%, 125mW | 603-AC0805FR-074R7L | 0,08604 | 1 | 0,08604
29. | 52R3 | 0805 | Otpornik, 1%, 125mW | 603-RC0805FR-0752R3L | 0,08604 | 1 | 0,08604
30. | 0R0 | 0603 | Otpornik, 1%, 100mW | MCMR04X000 PTL | 0,00401 | 5 | 0,0205
31. | 10k | 0805 | Otpornik, 5%, 125mW | 603-RC0805JR-0710KL | 0,18929 | 1 | 0,18929
32. | 10k | 0402 | NTC Termistor, 1% | 810-NTCG103JF103FT1 | 0,08604 | 1 | 0,08604
33. | 5k1 | 0603 | Otpornik, ±100ppm/C, 100mW | 603-AC0603FR-075K1L | 0,01032 | 2 | 0,10325
34. | 1k5 | 0805 | Otpornik, ±50ppm/C, 100mW | 594-MCU08050C1501FP5 | 0,07403 | 3 | 0,22209
35. | 2k2 | 0805 | Otpornik, ±100ppm/C, 125mW | 594-MCU08050C1501FP5 | 0,07403 | 1 | 0,07403
36. | 10k | TH-2, 3,7x2,4 mm | NTC Termistor, 1% | 954-103AT-2 | 0,538 | 1 | 0,538
37. | USB4135-GF-A | SMD-10 | USB-C prikljucak ˇ | 640-USB4135-GF-A | 0,58507 | 1 | 0,58507
38. | TL3301AF160QG | SMD-4 | Taktilni prekidacˇ | 612-TL3301AF1 | 0,29254 | 1 | 0,29254

31

R. br. | Vrijednost | Kucište ´ | Opis | Kataloški broj | Cijena (C) | Kol. | Ukupno (C)
39. | 4POS HDR | SMD-10 | Header 1x4 | 649-68001-204HLF | 0,34416 | 1 | 0,34416

32
