vitobruncic-blip/zavrsni/dokumenti/ad8310.png

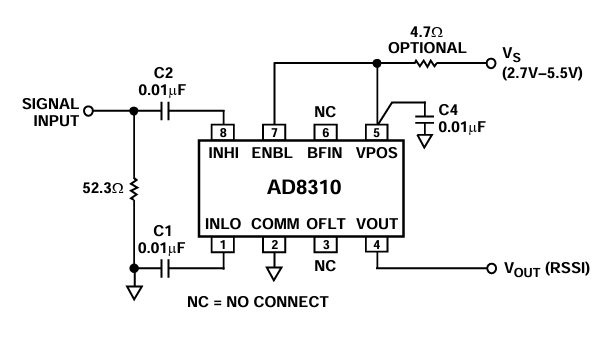
dokumenti/ad8310.png
