vitobruncic-blip/zavrsni/dokumenti/antena.png

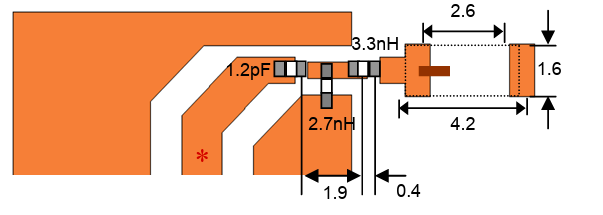
dokumenti/antena.png
