vitobruncic-blip/zavrsni/dokumenti/battery.png

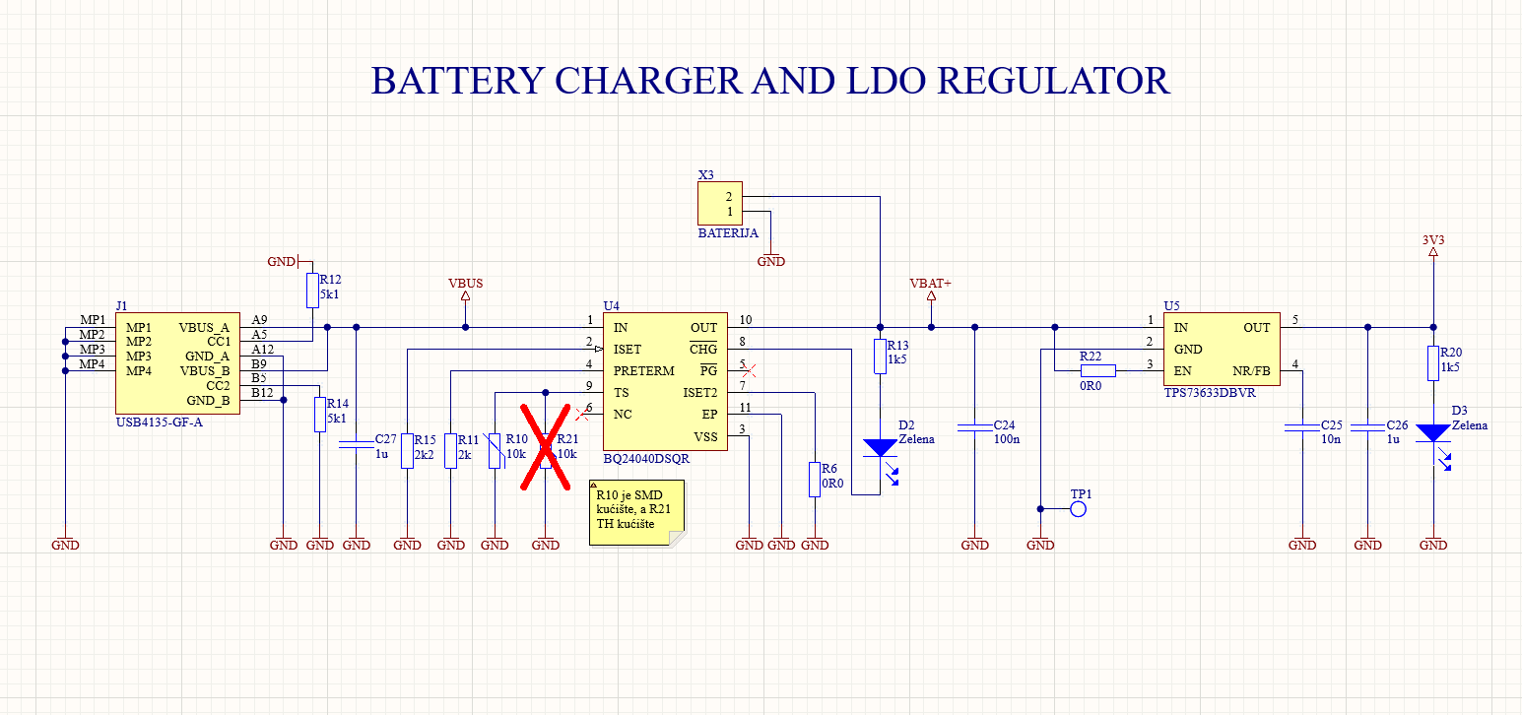
dokumenti/battery.png
