vitobruncic-blip/zavrsni/dokumenti/btm_view.png

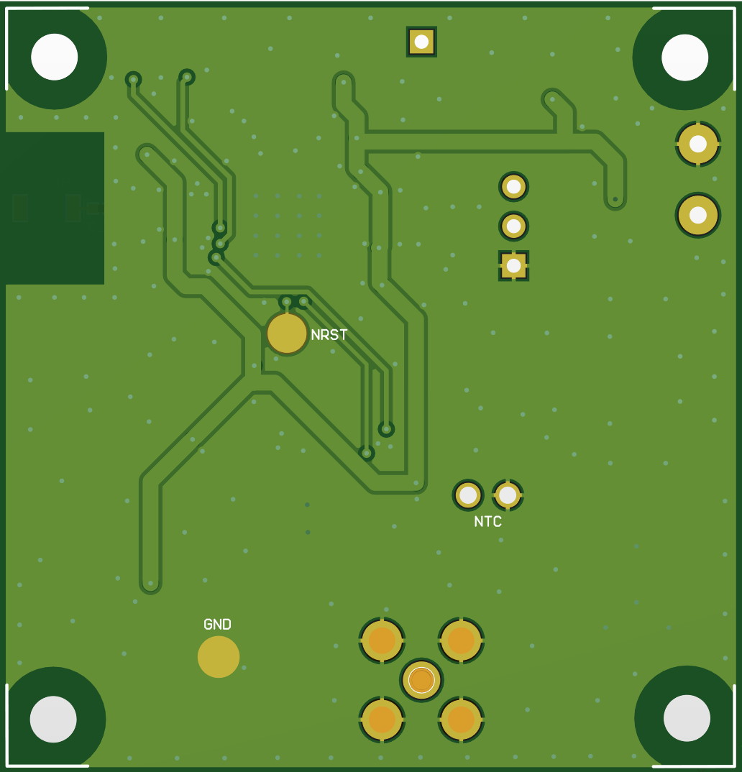
dokumenti/btm_view.png
