vitobruncic-blip/zavrsni/dokumenti/buffer.png

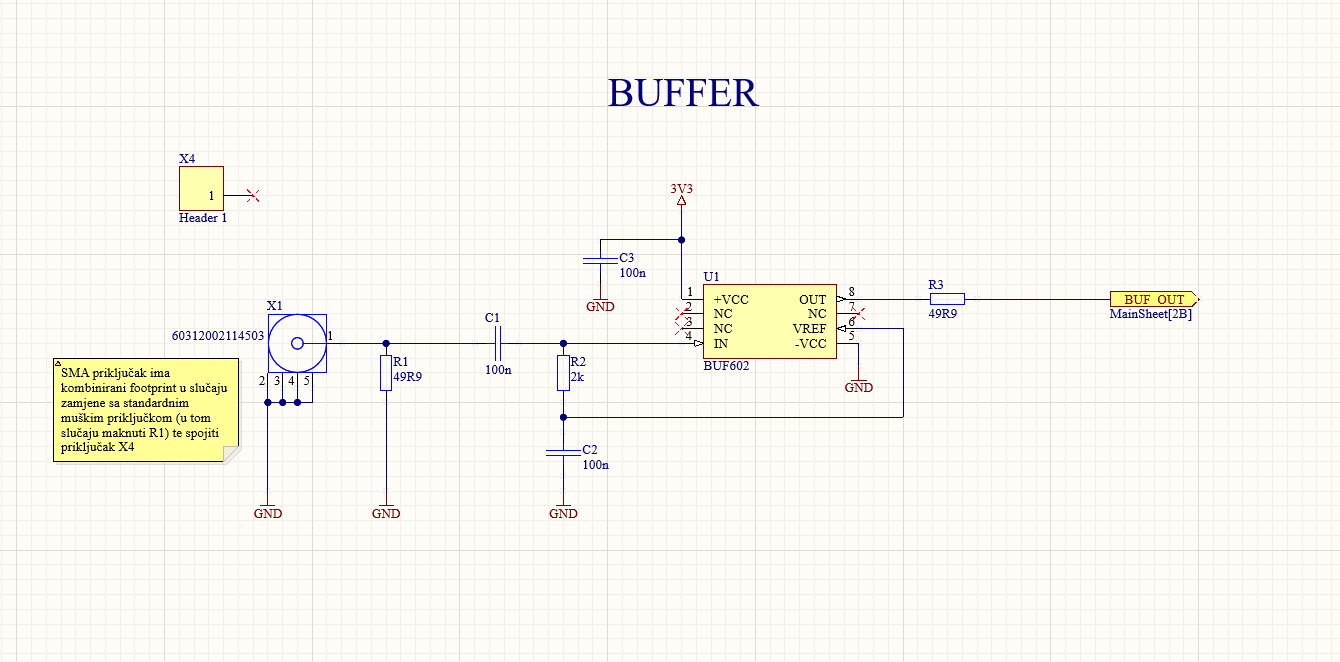
dokumenti/buffer.png
