vitobruncic-blip/zavrsni/dokumenti/hierarhija.png

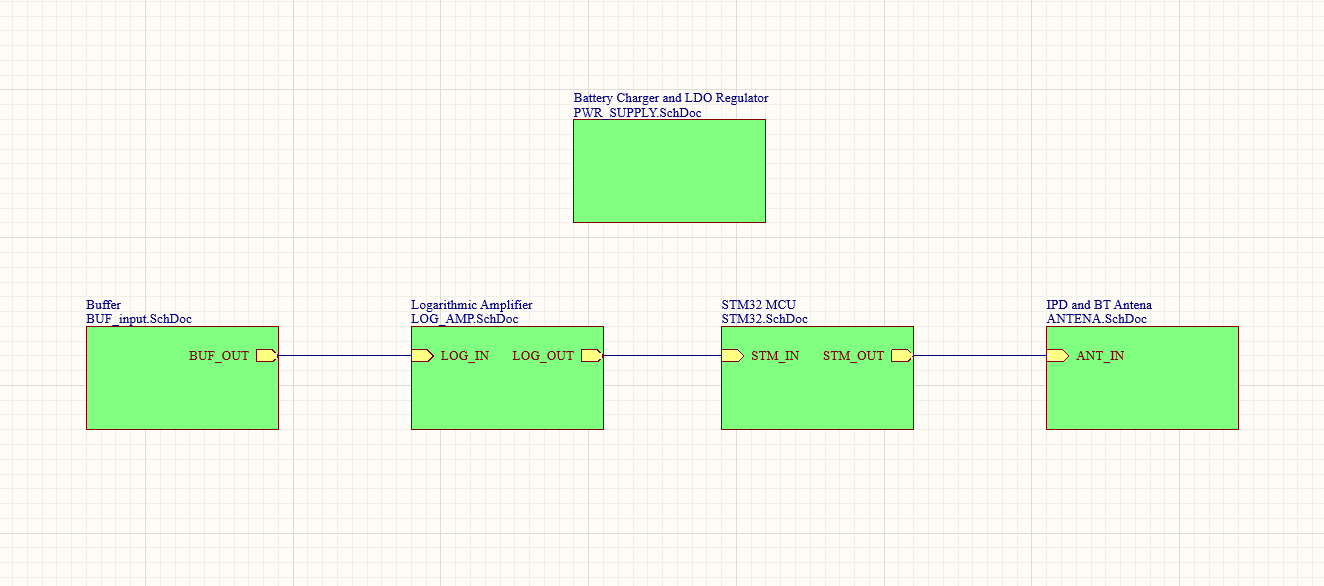
dokumenti/hierarhija.png
