vitobruncic-blip/zavrsni/dokumenti/ipdxant.png

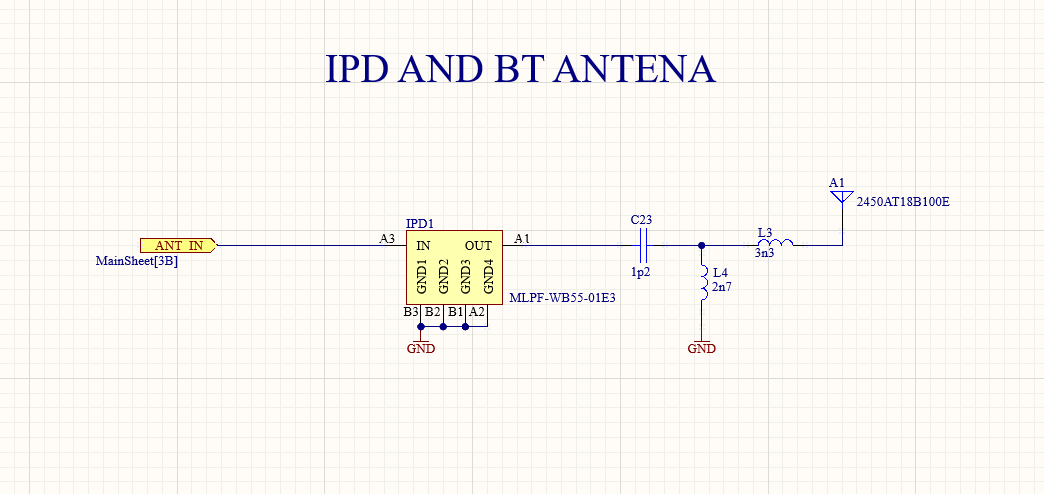
dokumenti/ipdxant.png
