vitobruncic-blip/zavrsni/dokumenti/komponente.png

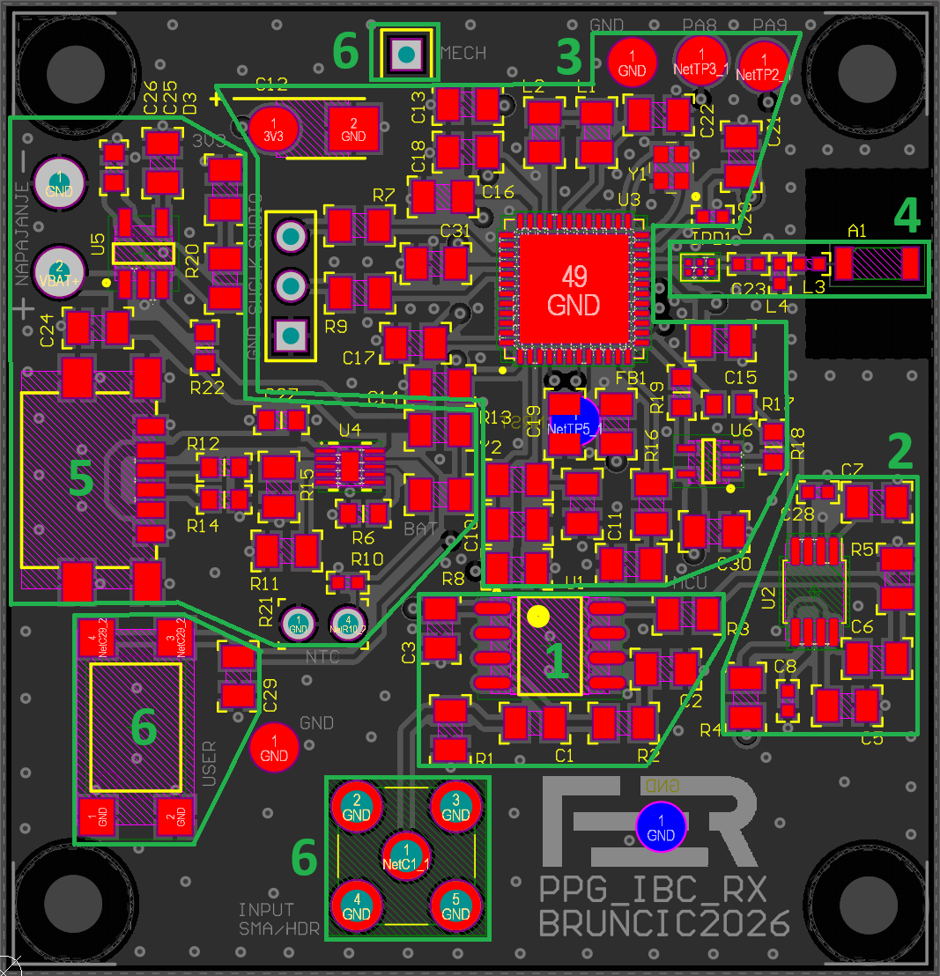
dokumenti/komponente.png
