vitobruncic-blip/zavrsni/dokumenti/logamp.png

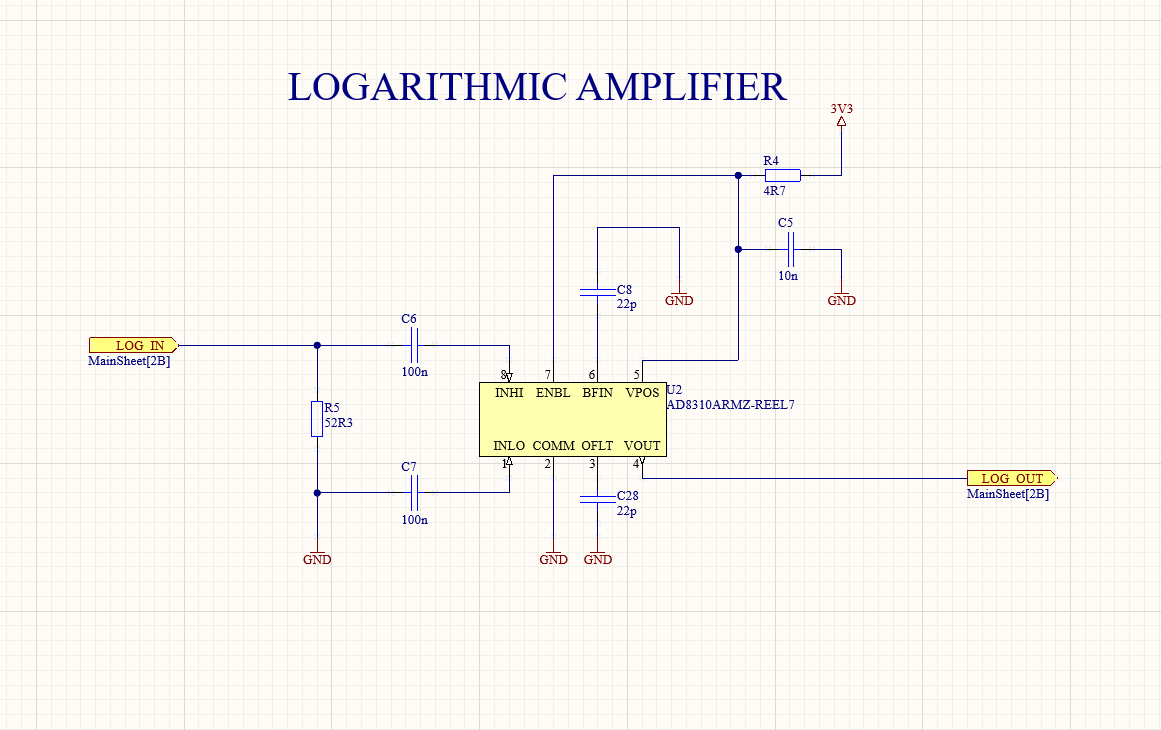
dokumenti/logamp.png
