vitobruncic-blip/zavrsni/dokumenti/stm.png

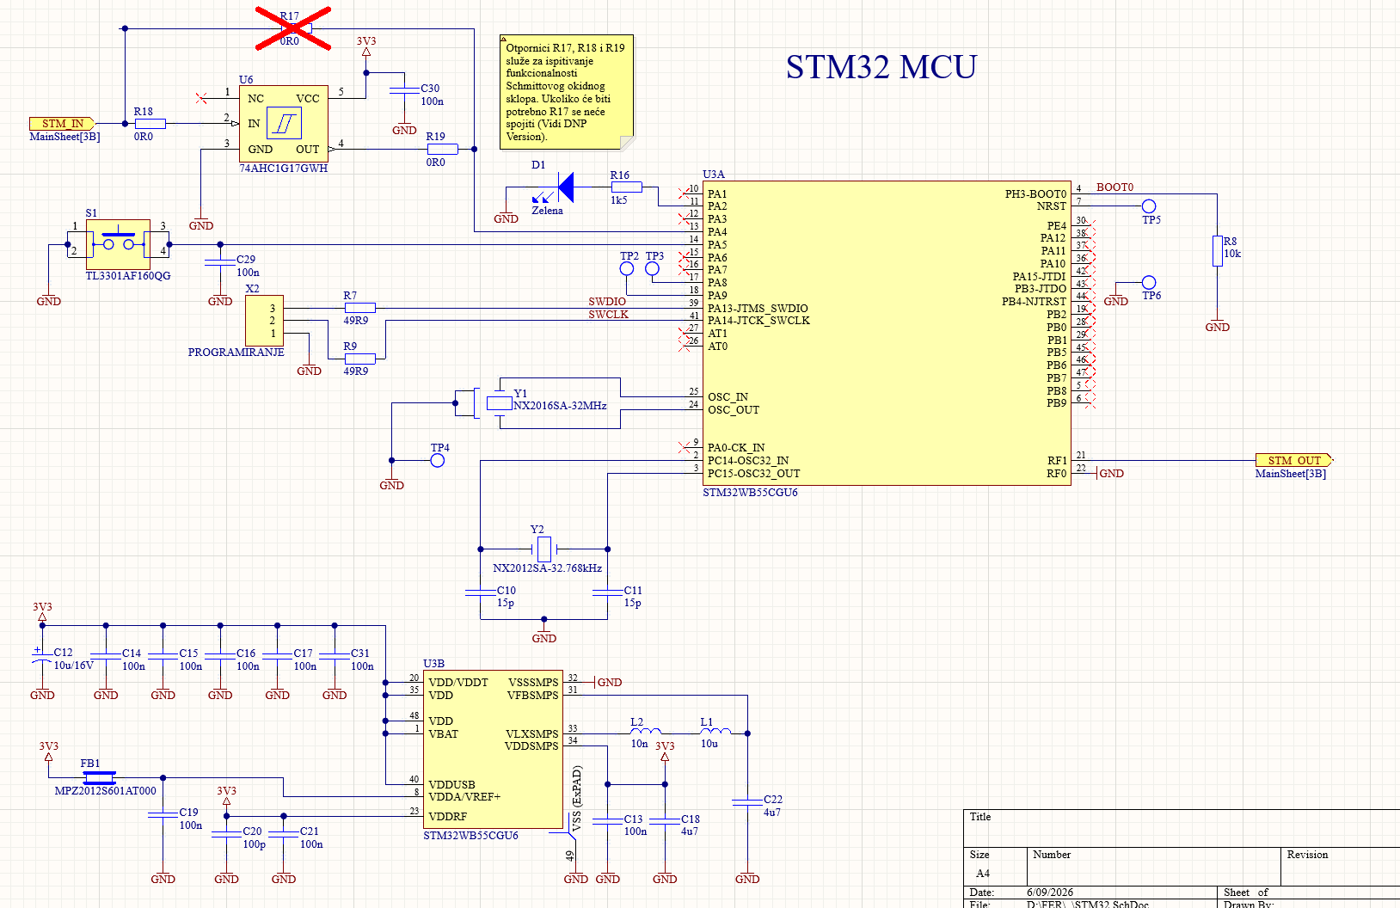
dokumenti/stm.png
