vitobruncic-blip/zavrsni/dokumenti/top_view.png

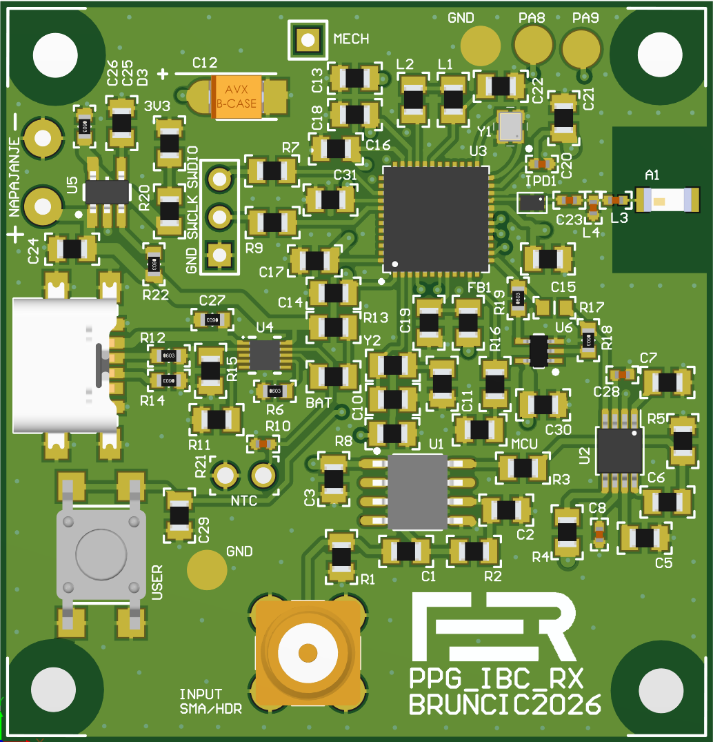
dokumenti/top_view.png
