vitobruncic-blip/zavrsni/dokumenti/trnsf_schmitt.png

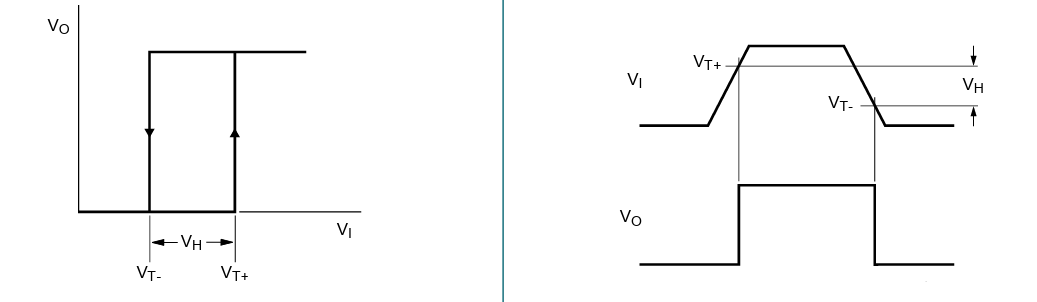
dokumenti/trnsf_schmitt.png
