vitobruncic-blip/zavrsni/pomocni projekti/Sinozic_Altium_BaterijskiGeneratorSignala/00_Altium_Baterijski_Generator_Signala/03 Libraries/snapeda/ECS-196-S-23A-TR.STEP

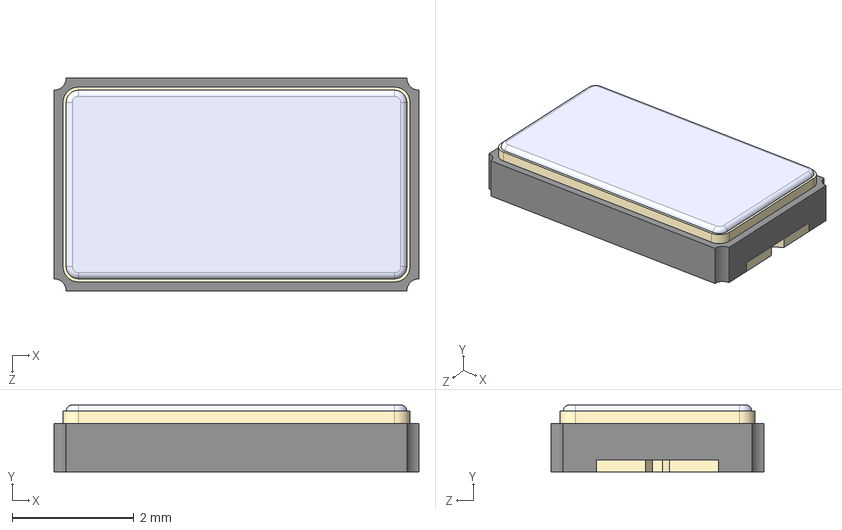
[picture p34: CAD file, 2026-05-08]
pomocni projekti/Sinozic_Altium_BaterijskiGeneratorSignala/00_Altium_Baterijski_Generator_Signala/03 Libraries/snapeda/ECS-196-S-23A-TR.STEP
6.00 x 1.10 x 3.50 mm
