vitobruncic-blip/zavrsni/pomocni projekti/Sinozic_Altium_BaterijskiGeneratorSignala/00_Altium_Baterijski_Generator_Signala/Project Outputs for Transmitter/Draftsman Output/Fabrication_Drawing.PDF

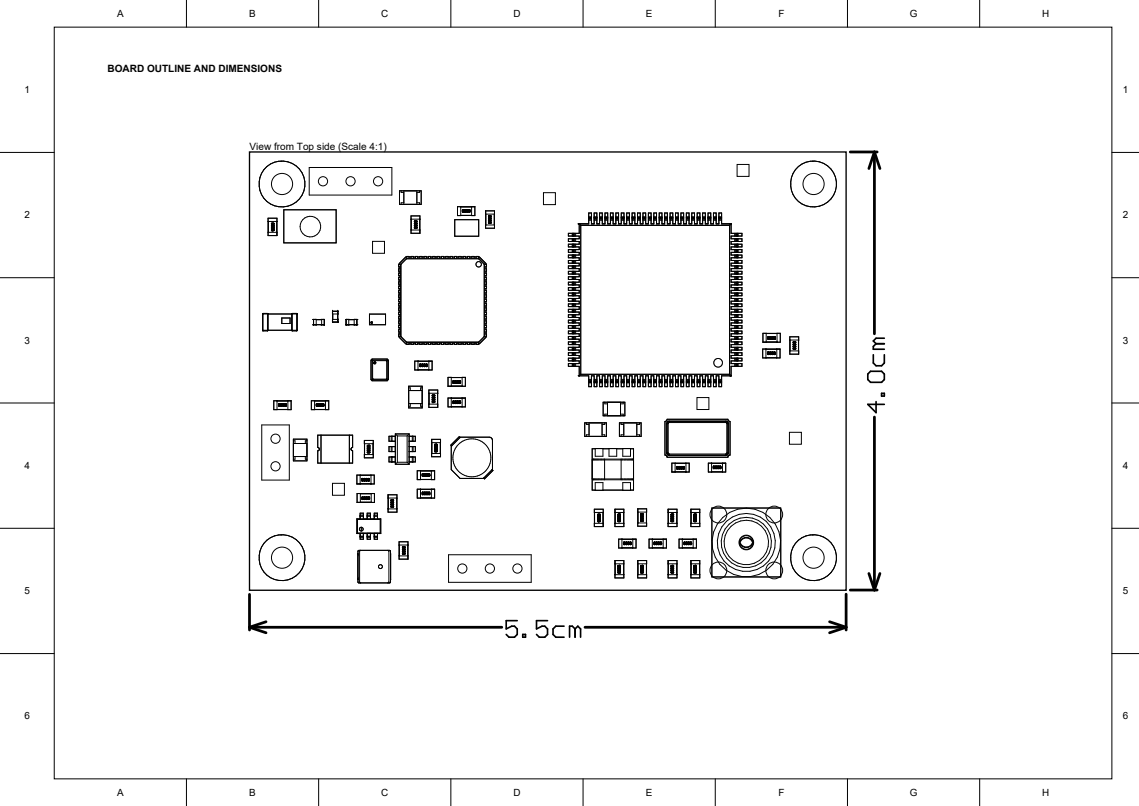
[picture p35: page 1]

BOARD OUTLINE AND DIMENSIONS

View from Top side (Scale 4:1)

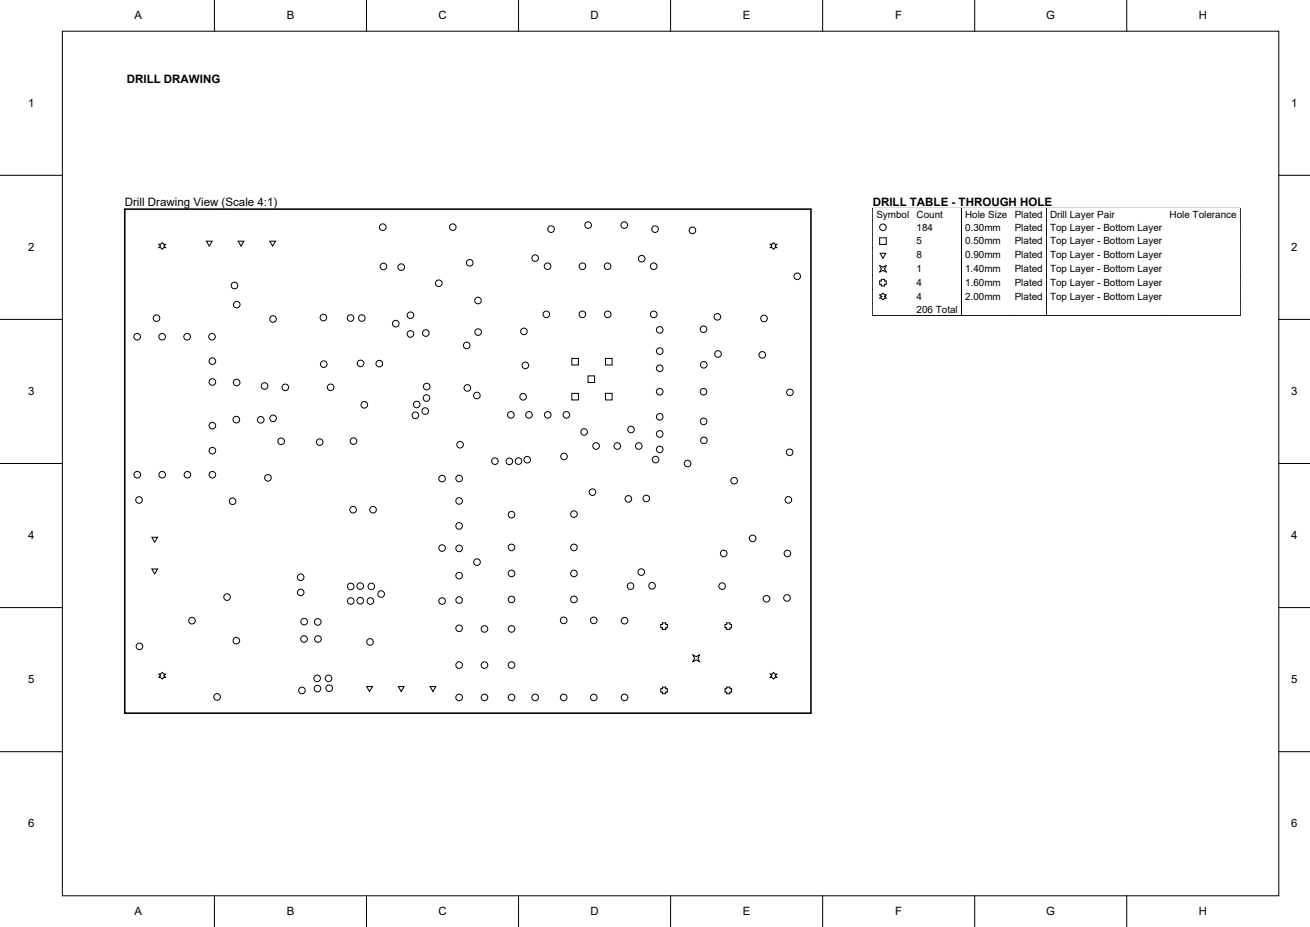
[picture p36: page 2]

Symbol | Count | Hole Size | Plated | Drill Layer Pair | Hole Tolerance

184 | 0.30mm | Plated | Top Layer - Bottom Layer
5 | 0.50mm | Plated | Top Layer - Bottom Layer
8 | 0.90mm | Plated | Top Layer - Bottom Layer
1 | 1.40mm | Plated | Top Layer - Bottom Layer
4 | 1.60mm | Plated | Top Layer - Bottom Layer
4 | 2.00mm | Plated | Top Layer - Bottom Layer
206 Total

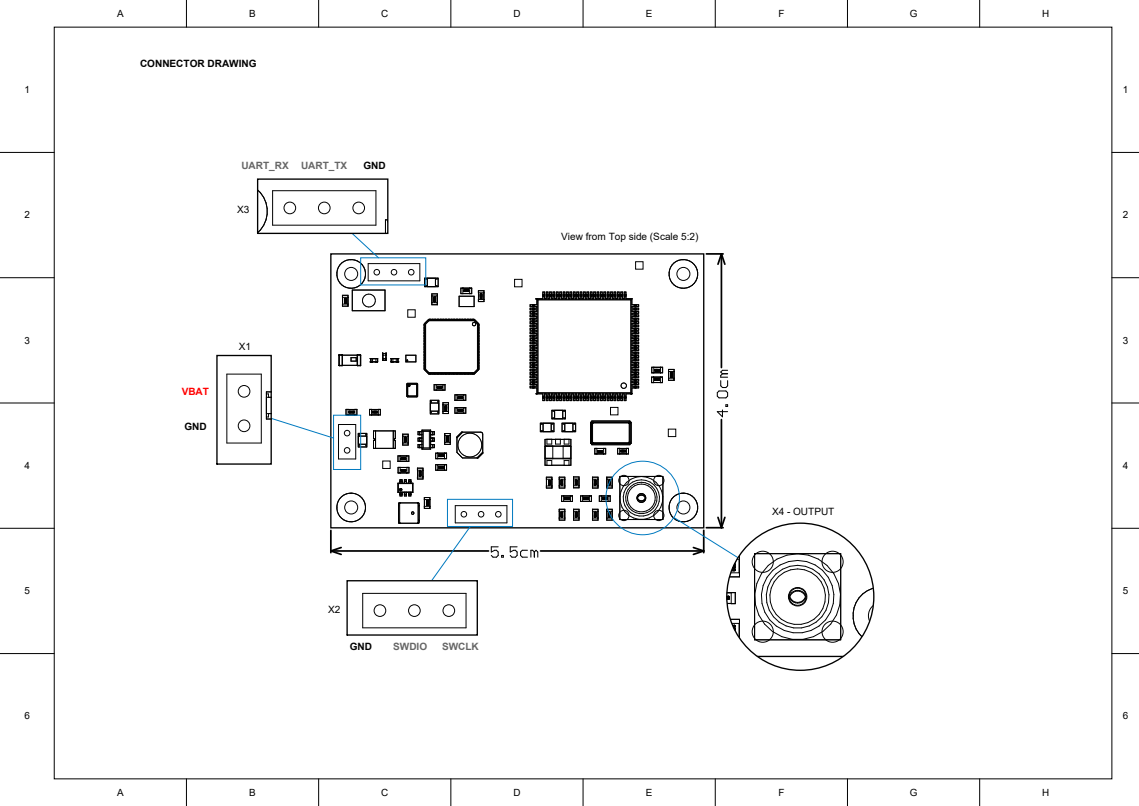
[picture p37: page 3]

View from Top side (Scale 5:2)

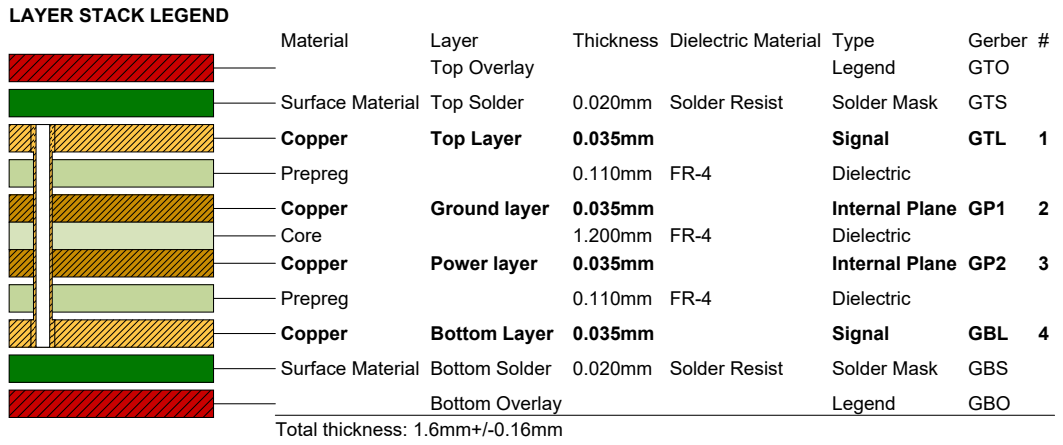
[picture p38: page 4]
