vitobruncic-blip/zavrsni/IBC_prijamnik_VB/Project Outputs for IBC_prijamnik_VB/output_print_VB.pdf

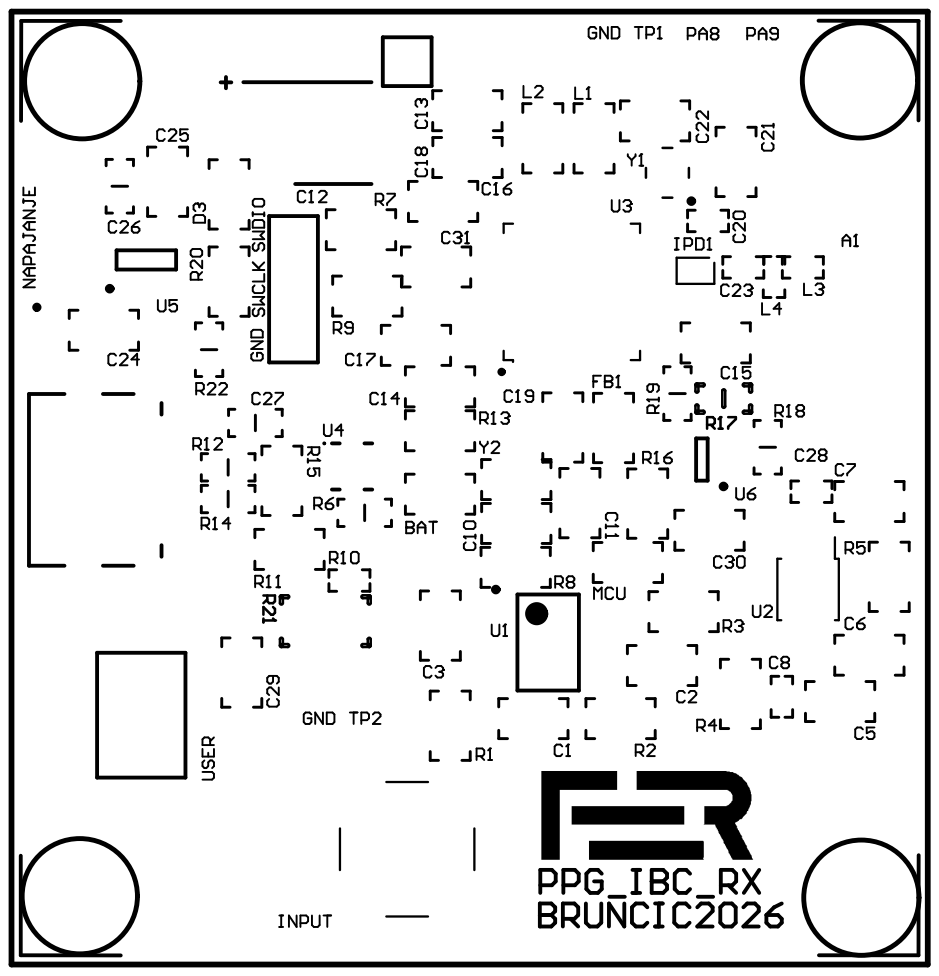
[picture p39: page 1]

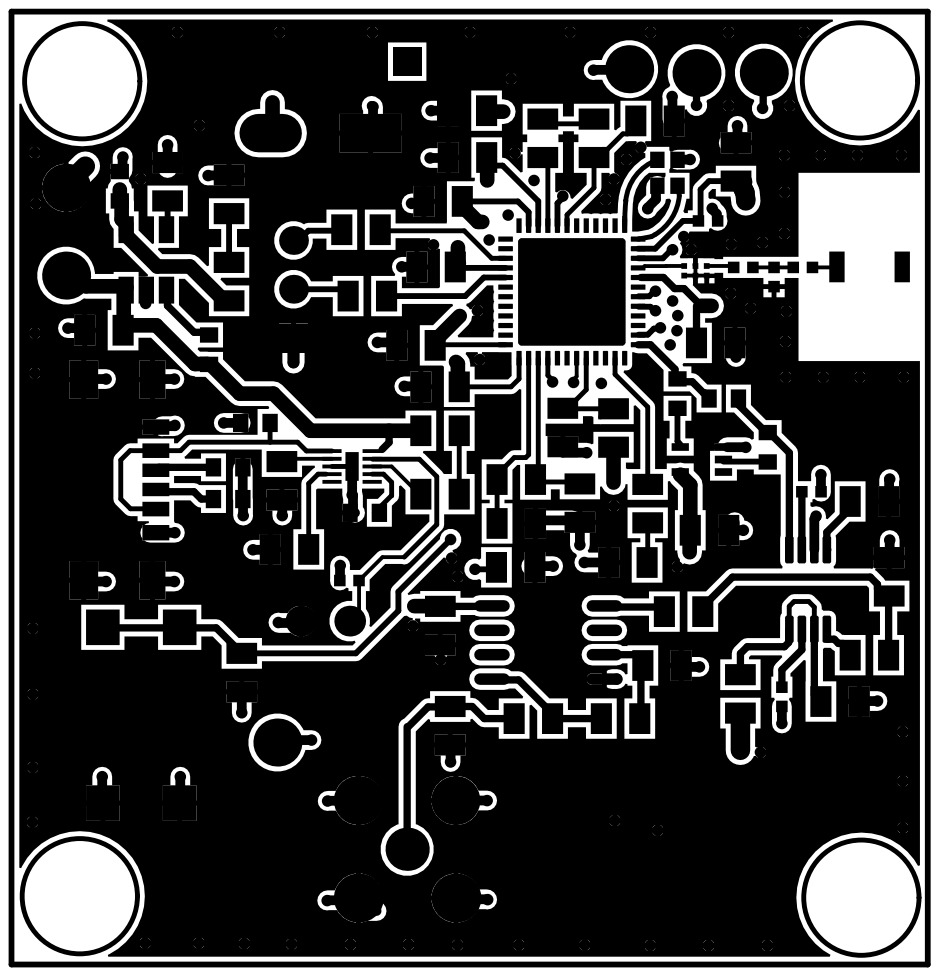
[picture p40: page 3]

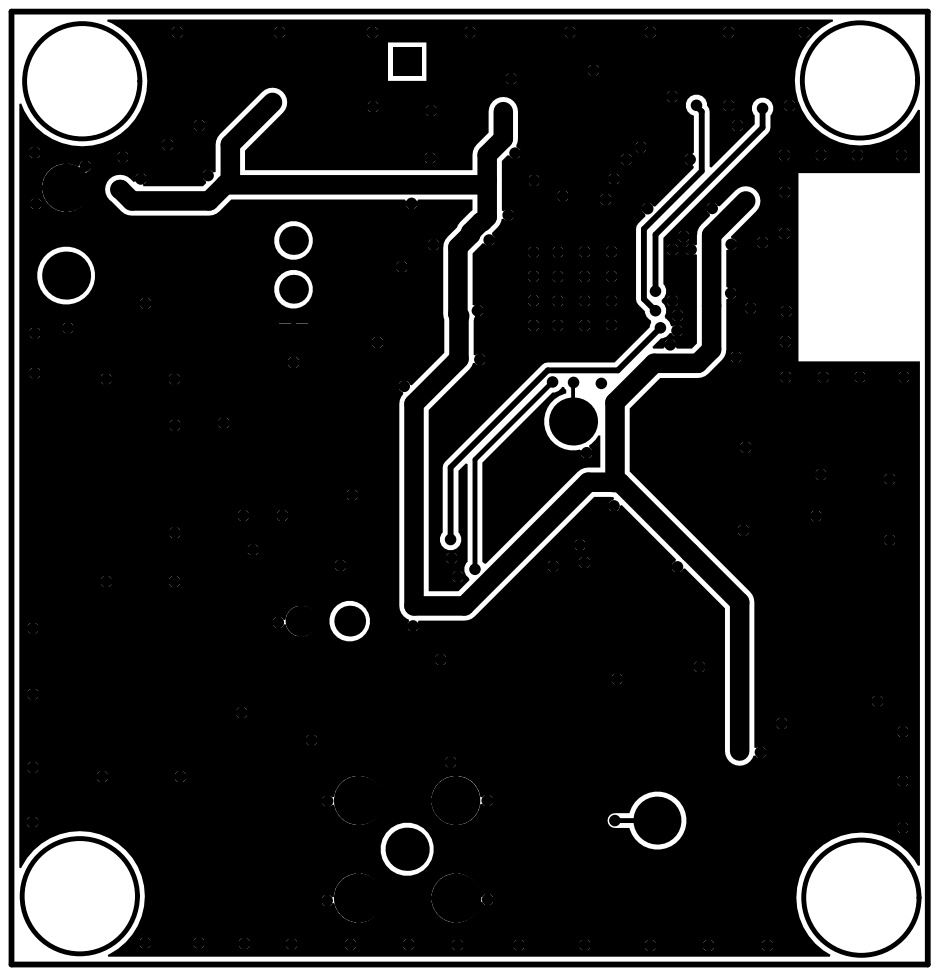
[picture p41: page 4]

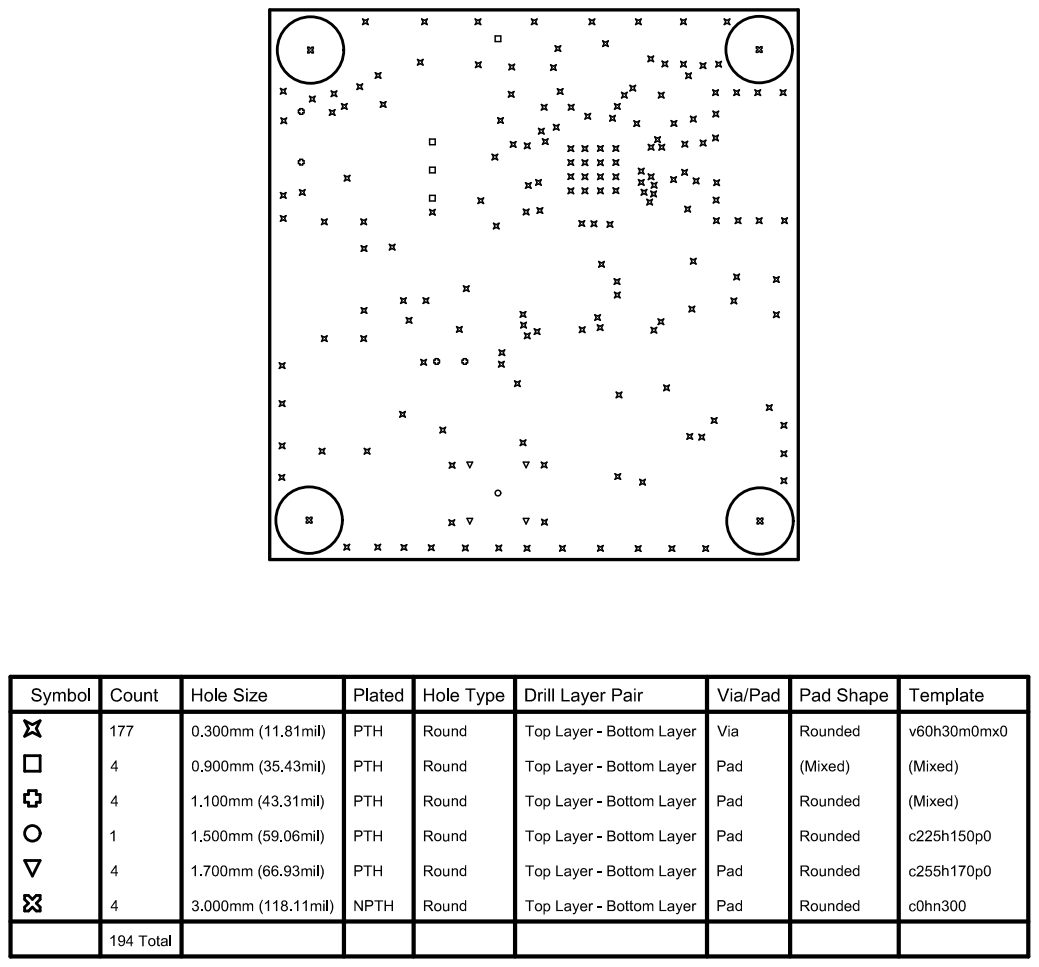
[picture p42: page 5]
