vitobruncic-blip/zavrsni/pomocni projekti/Sinozic_Altium_BaterijskiGeneratorSignala/00_Altium_Baterijski_Generator_Signala/Project Outputs for Transmitter/Documentation Outputs/PCB_Prints.PDF

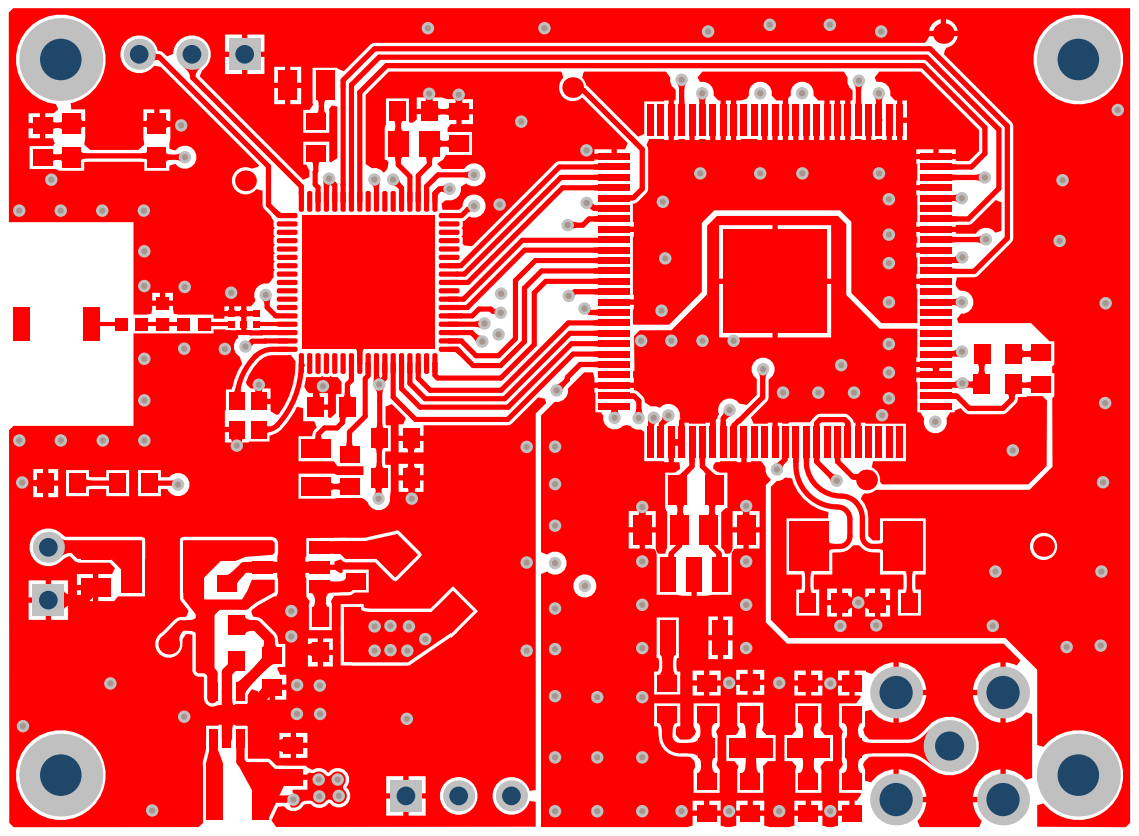
[picture p43: page 1]

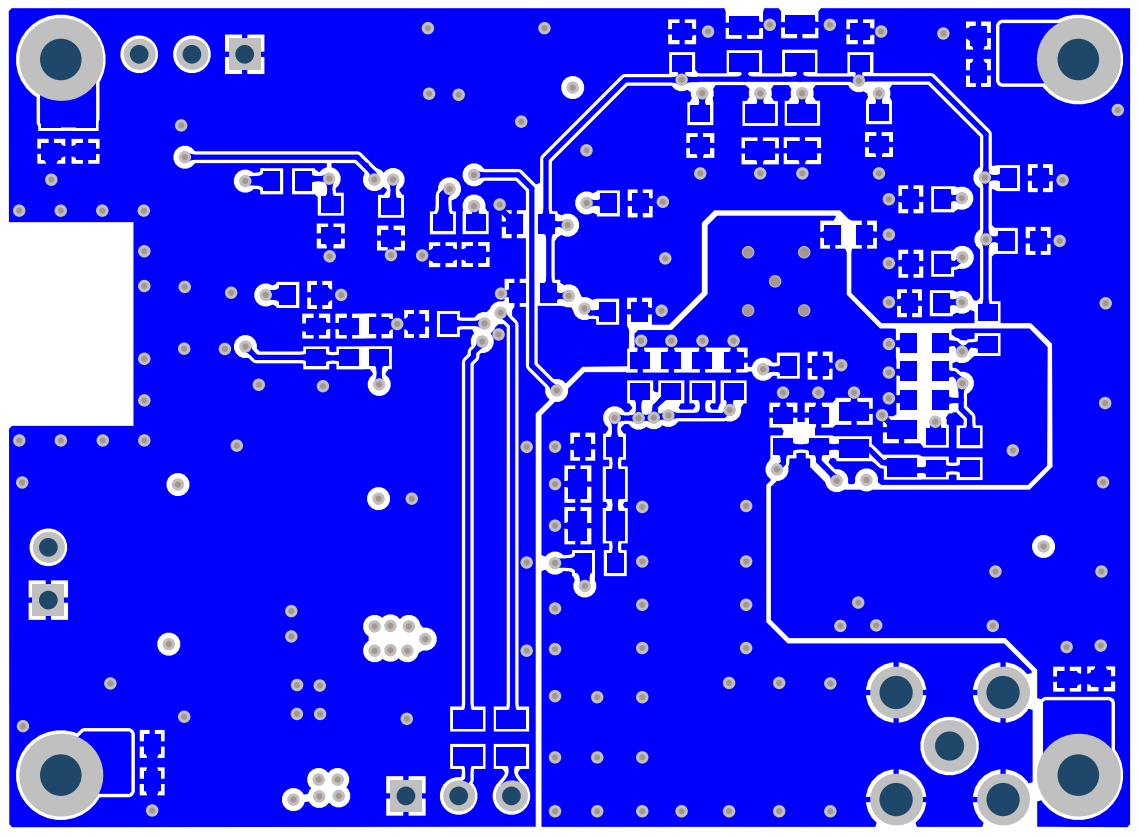
[picture p44: page 2]

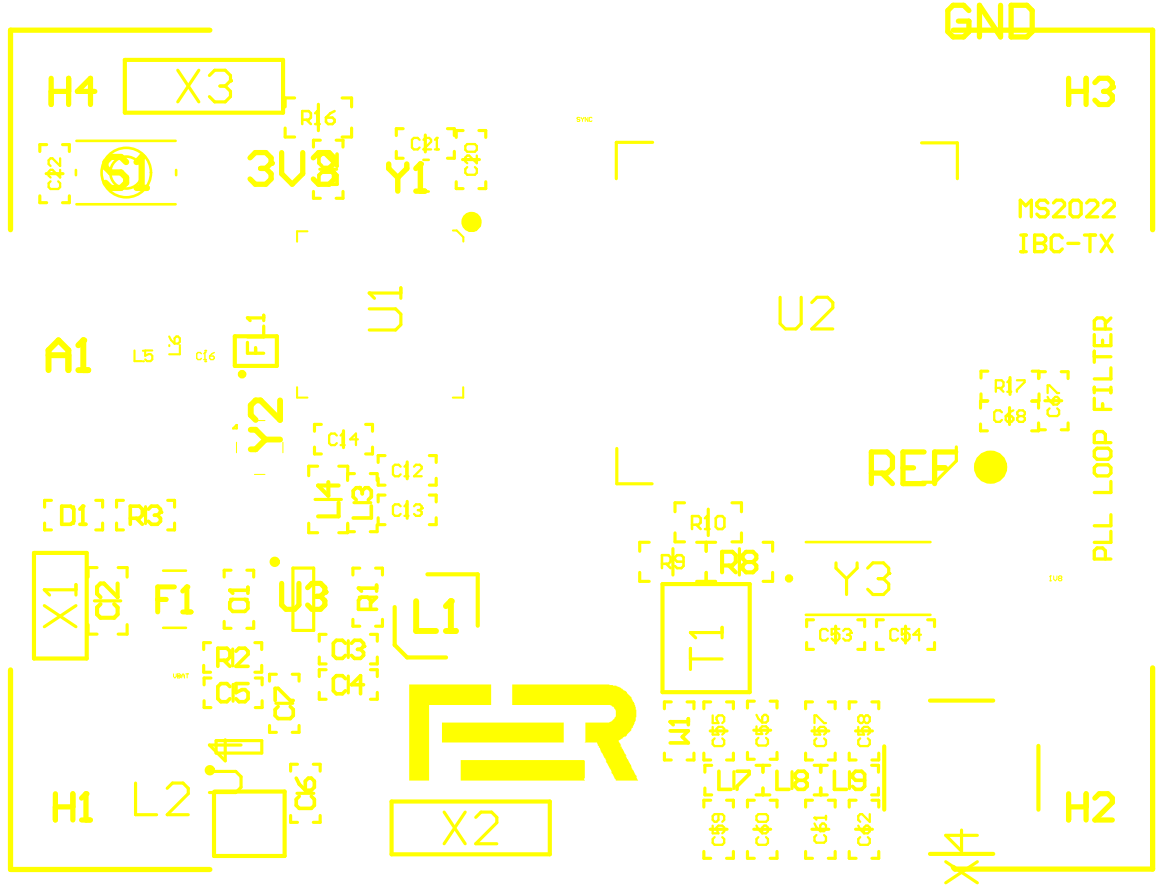
[picture p45: page 3]

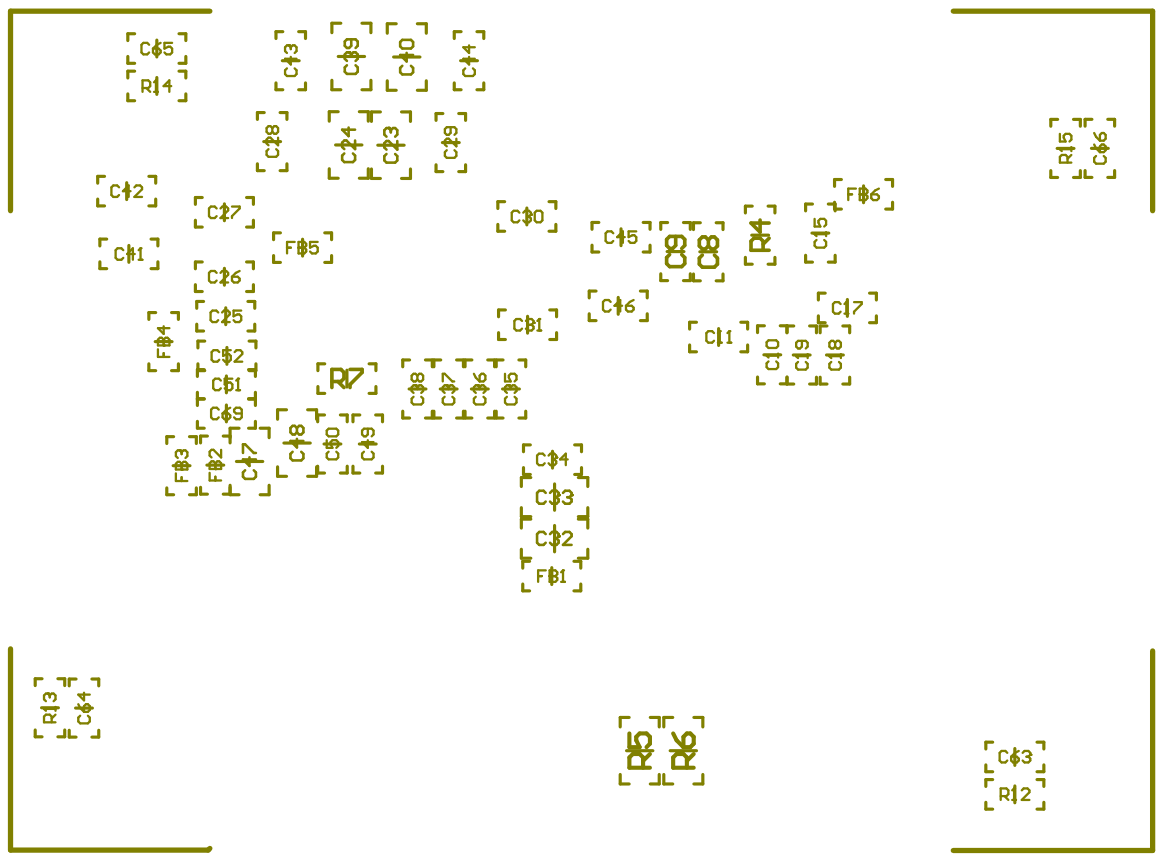
[picture p46: page 4]

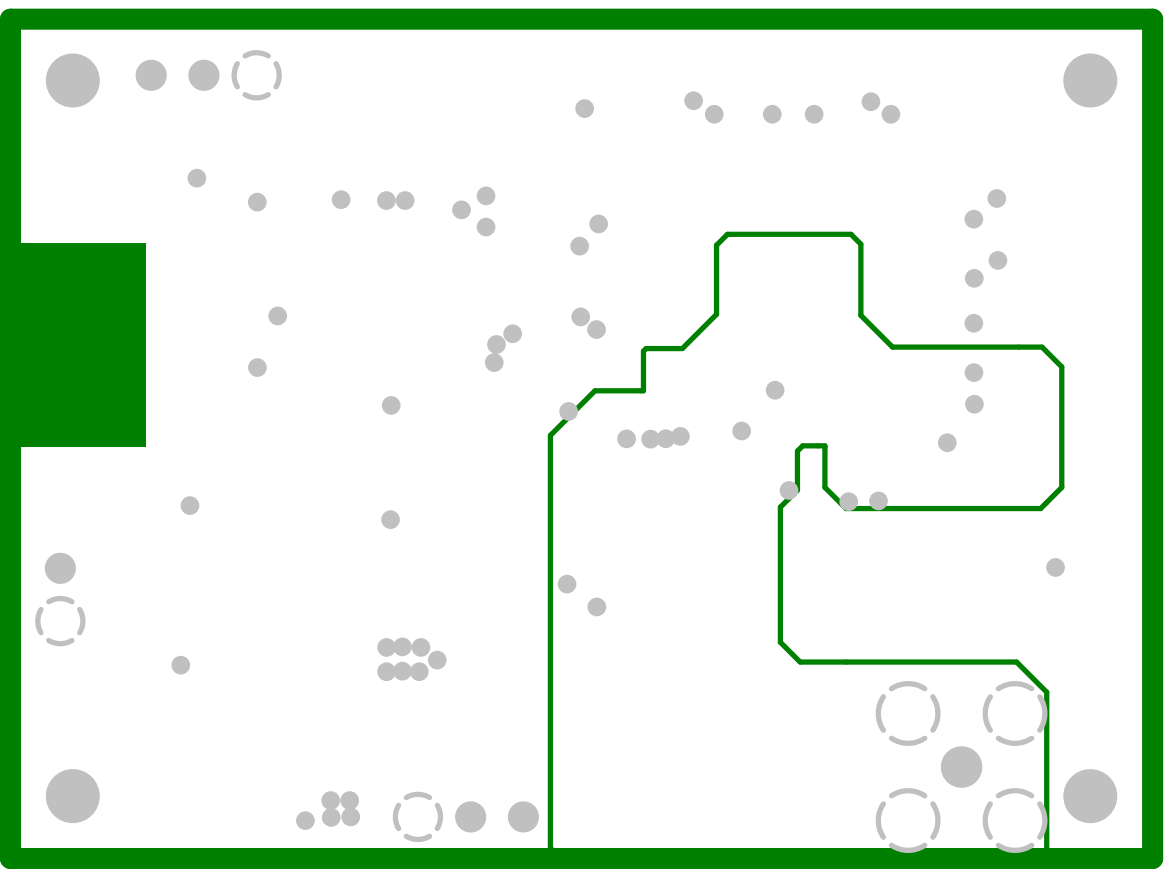
[picture p47: page 5]

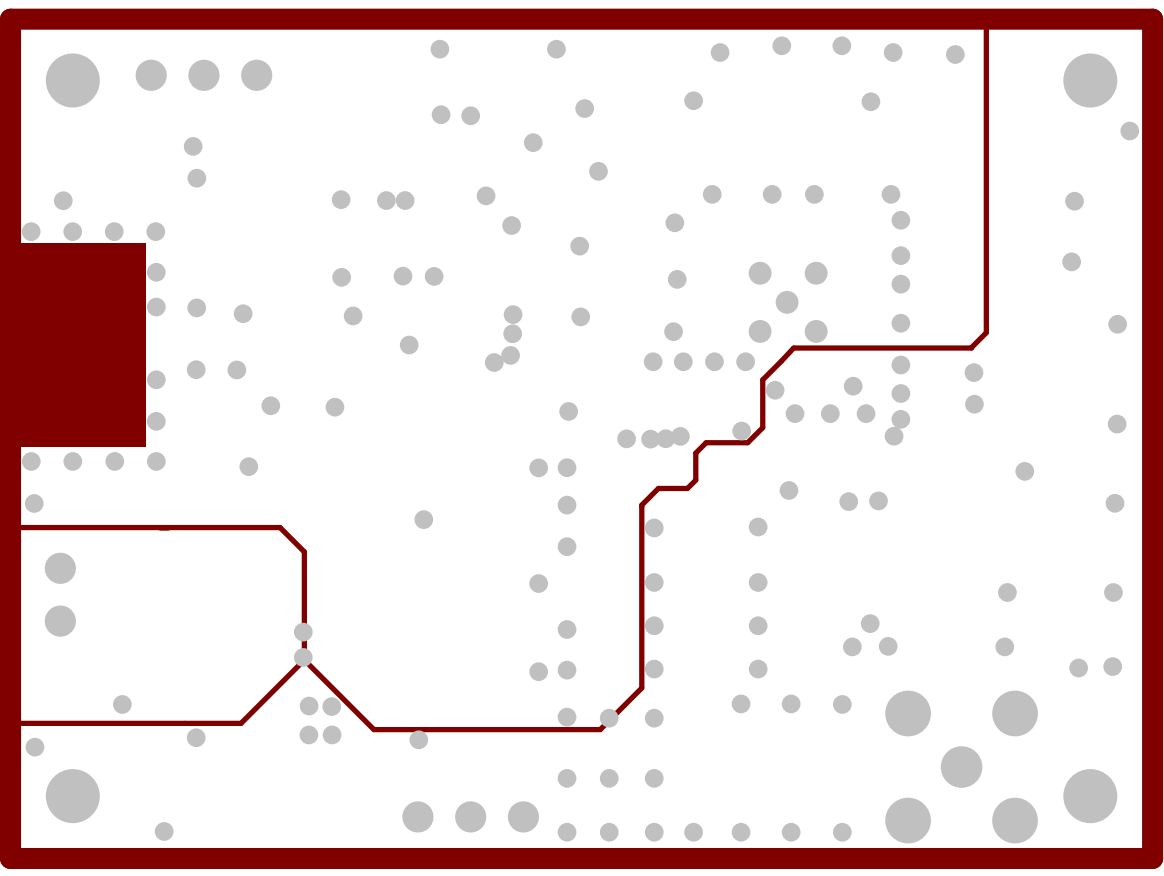
[picture p48: page 6]
