vitobruncic-blip/zavrsni/pomocni projekti/Sinozic_Altium_BaterijskiGeneratorSignala/00_Altium_Baterijski_Generator_Signala/Project Outputs for Transmitter/Documentation Outputs/Schematics.PDF

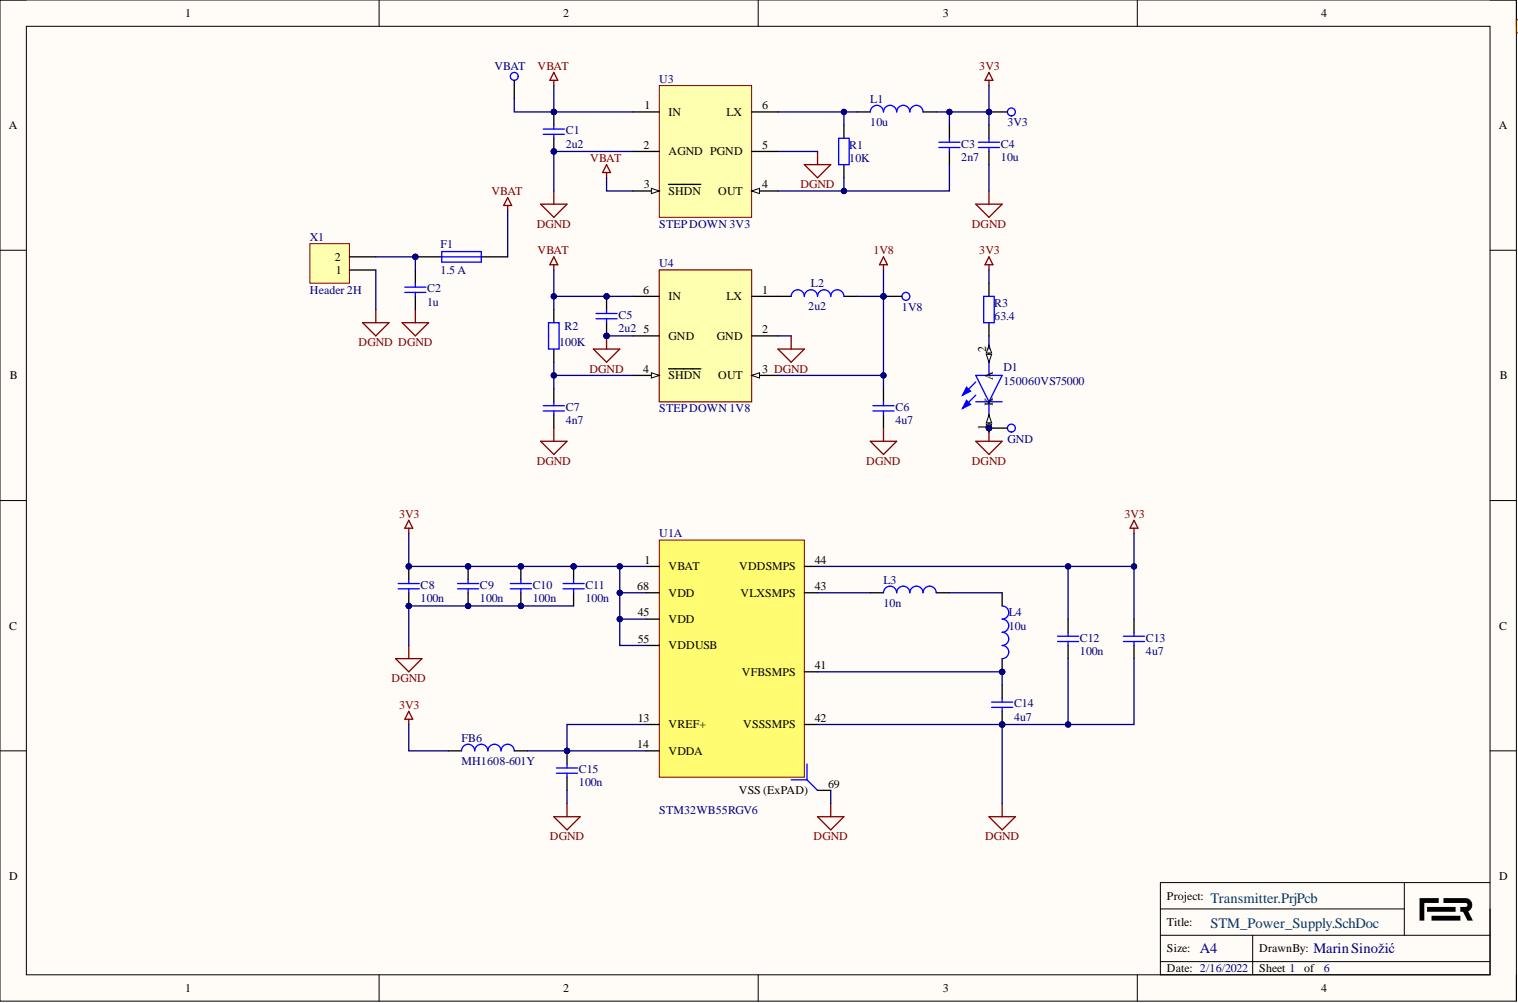
[picture p49: page 1]

A4 Size: | Marin Sinožić DrawnBy:
Date: | Sheet of

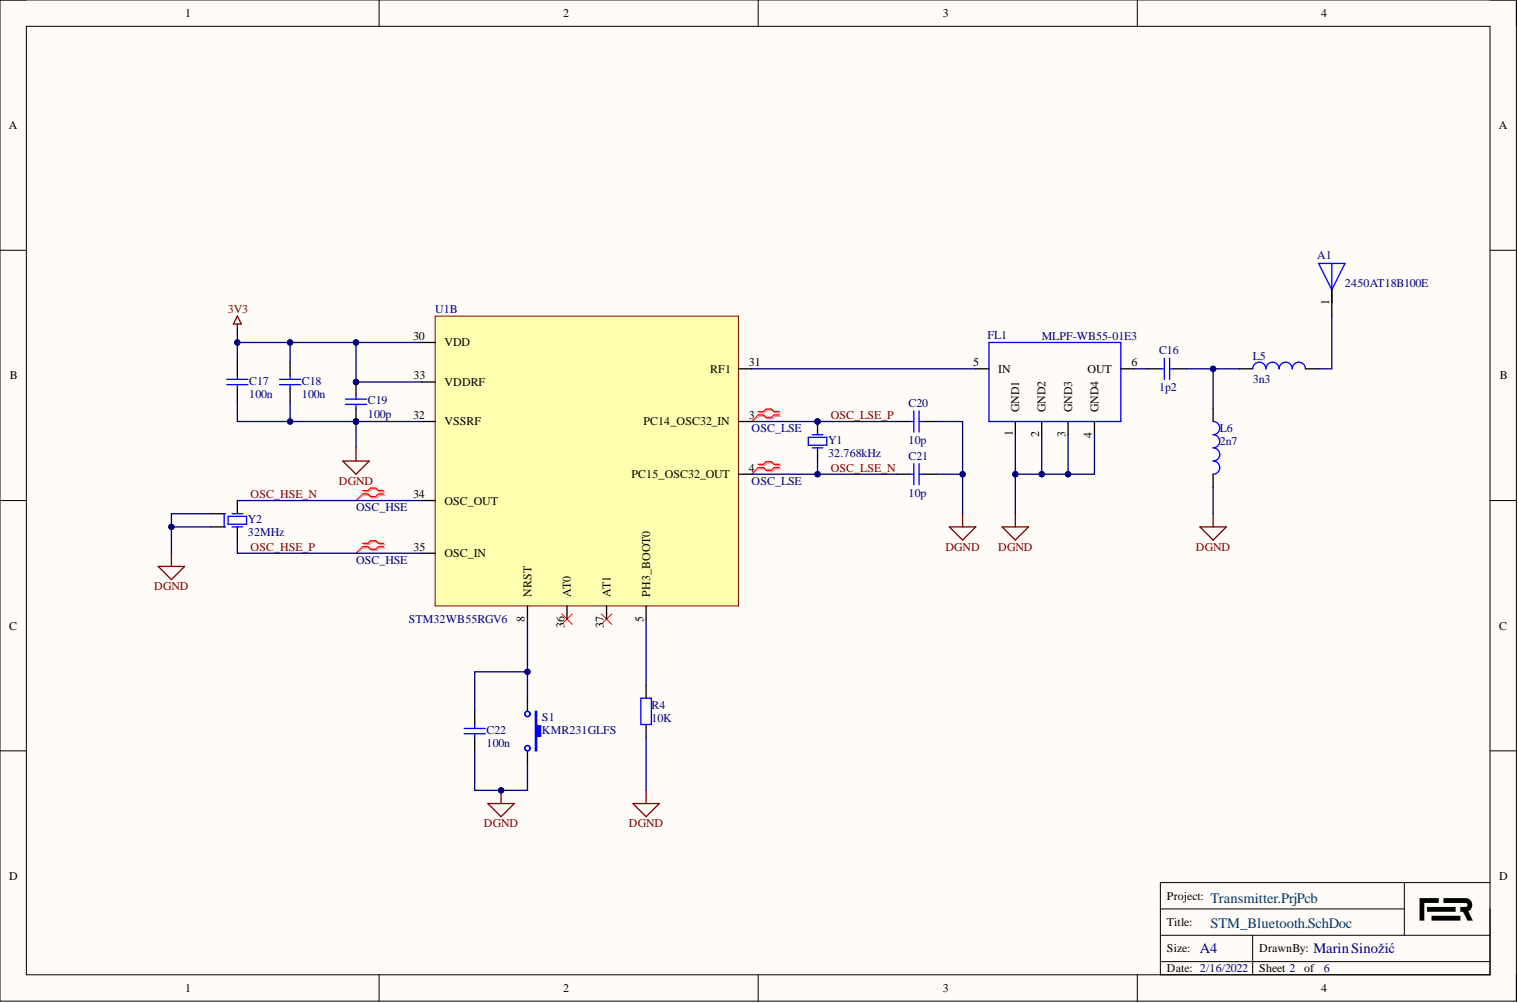
[picture p50: page 2]

A Size | M arin Sin ž i ć Draw n B y
Dat : / | Shee f

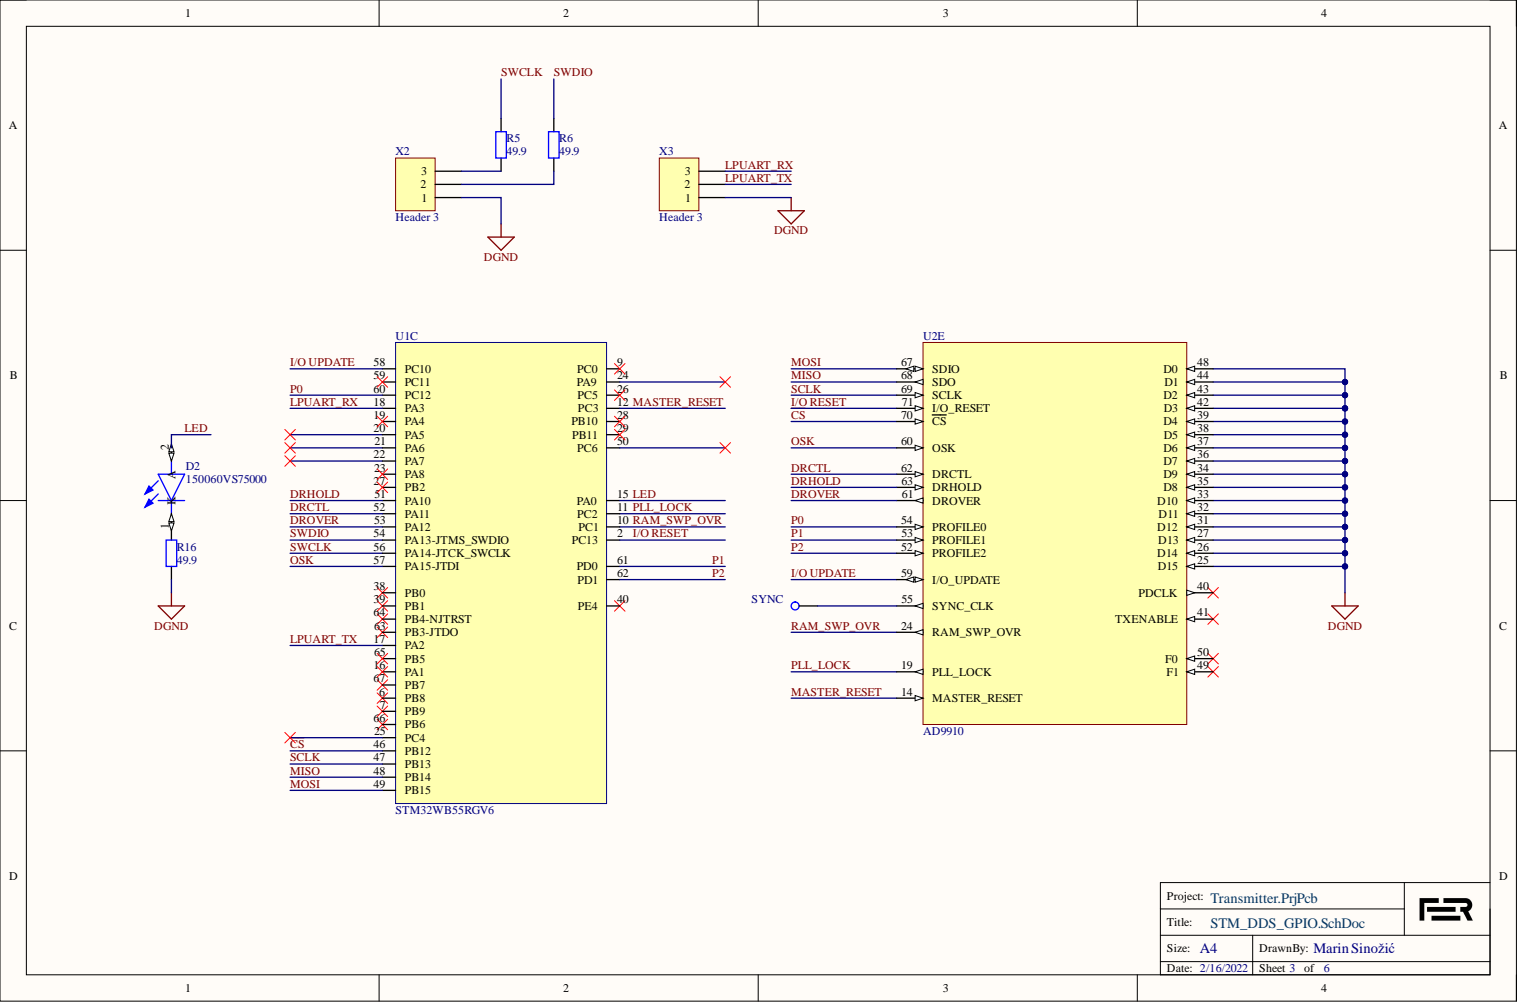
[picture p51: page 3]

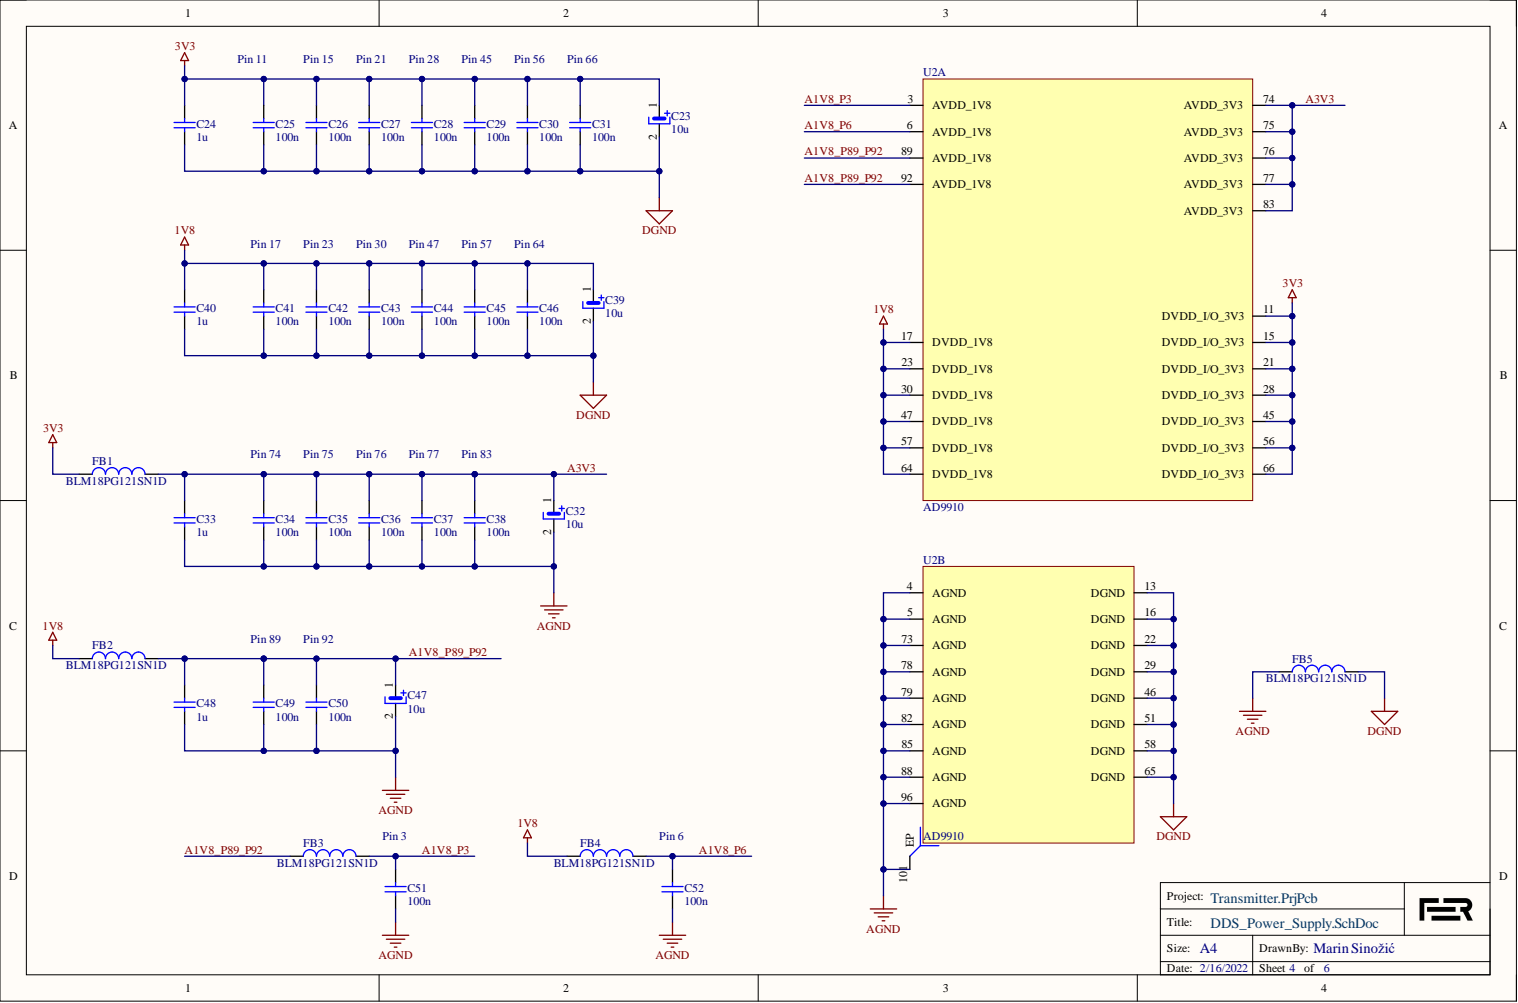
[picture p52: page 4]

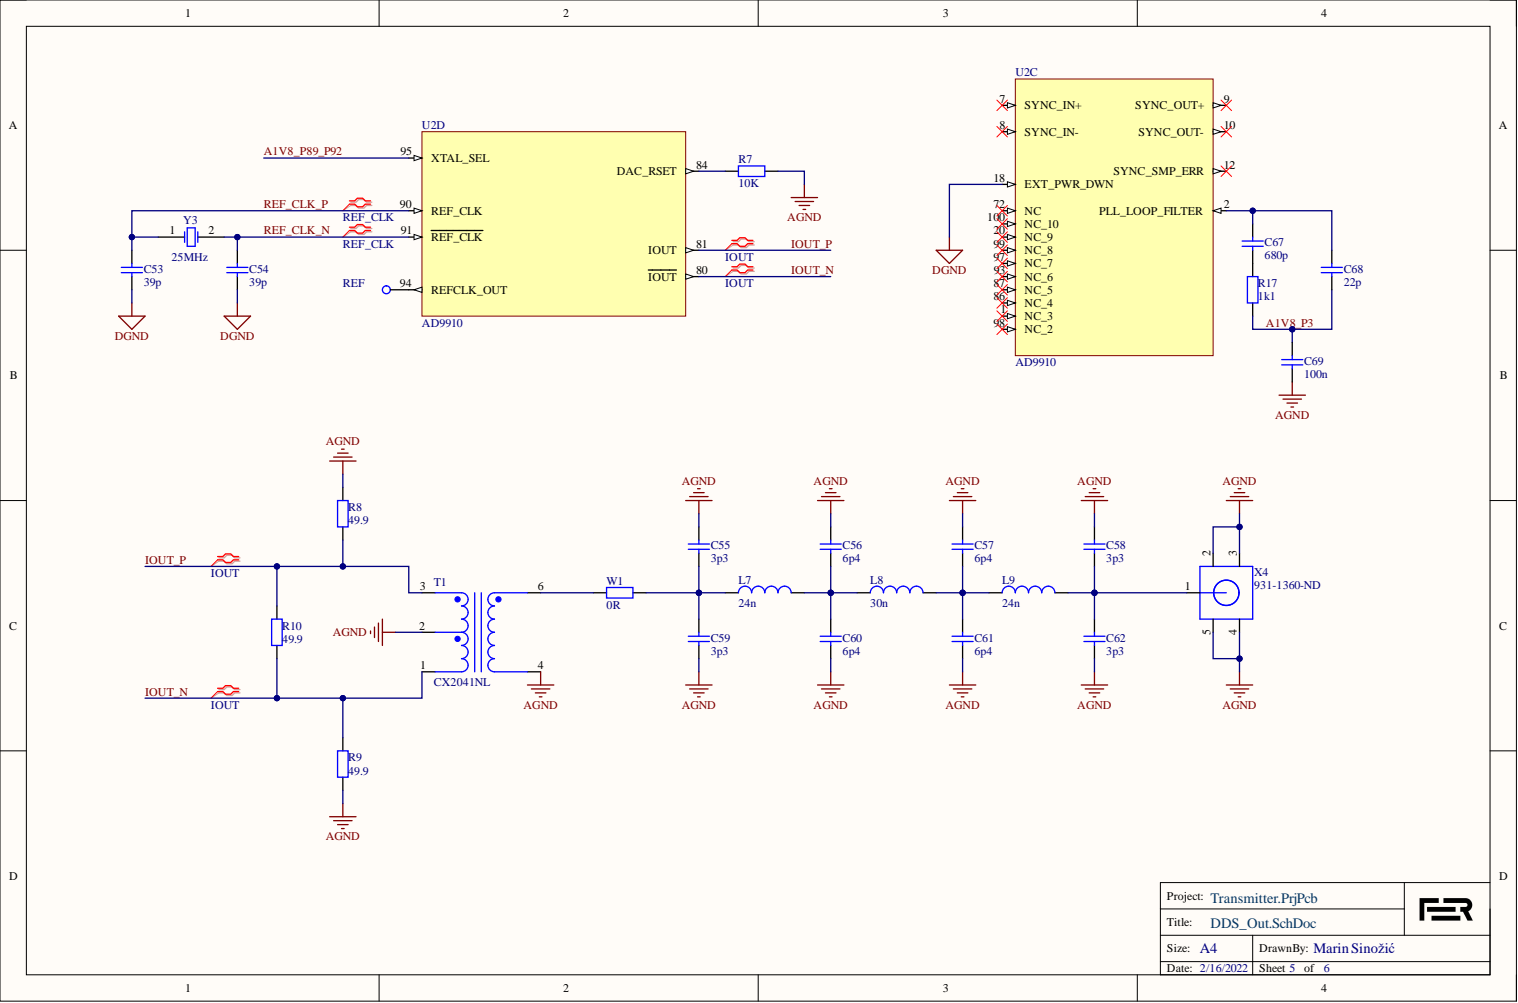
[picture p53: page 5]

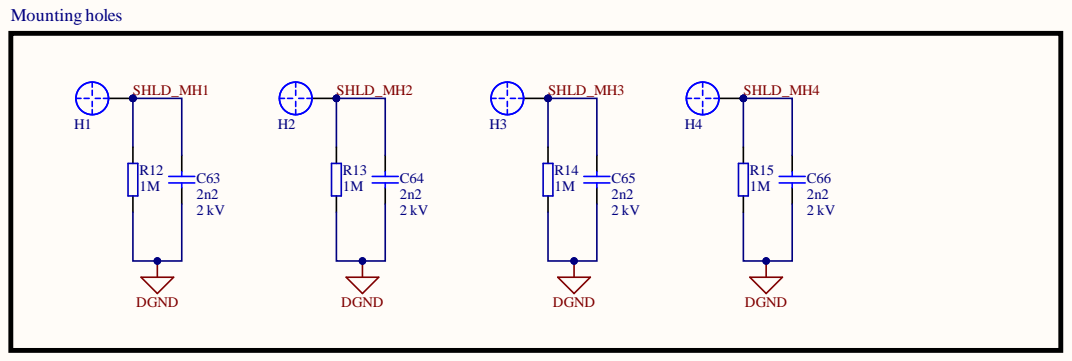
[picture p54: page 6]
