vitobruncic-blip/zavrsni/pomocni projekti/Sinozic_Altium_BaterijskiGeneratorSignala/00_Altium_Baterijski_Generator_Signala/Project Outputs for Transmitter/Draftsman Output/Assembly_Drawing.PDF

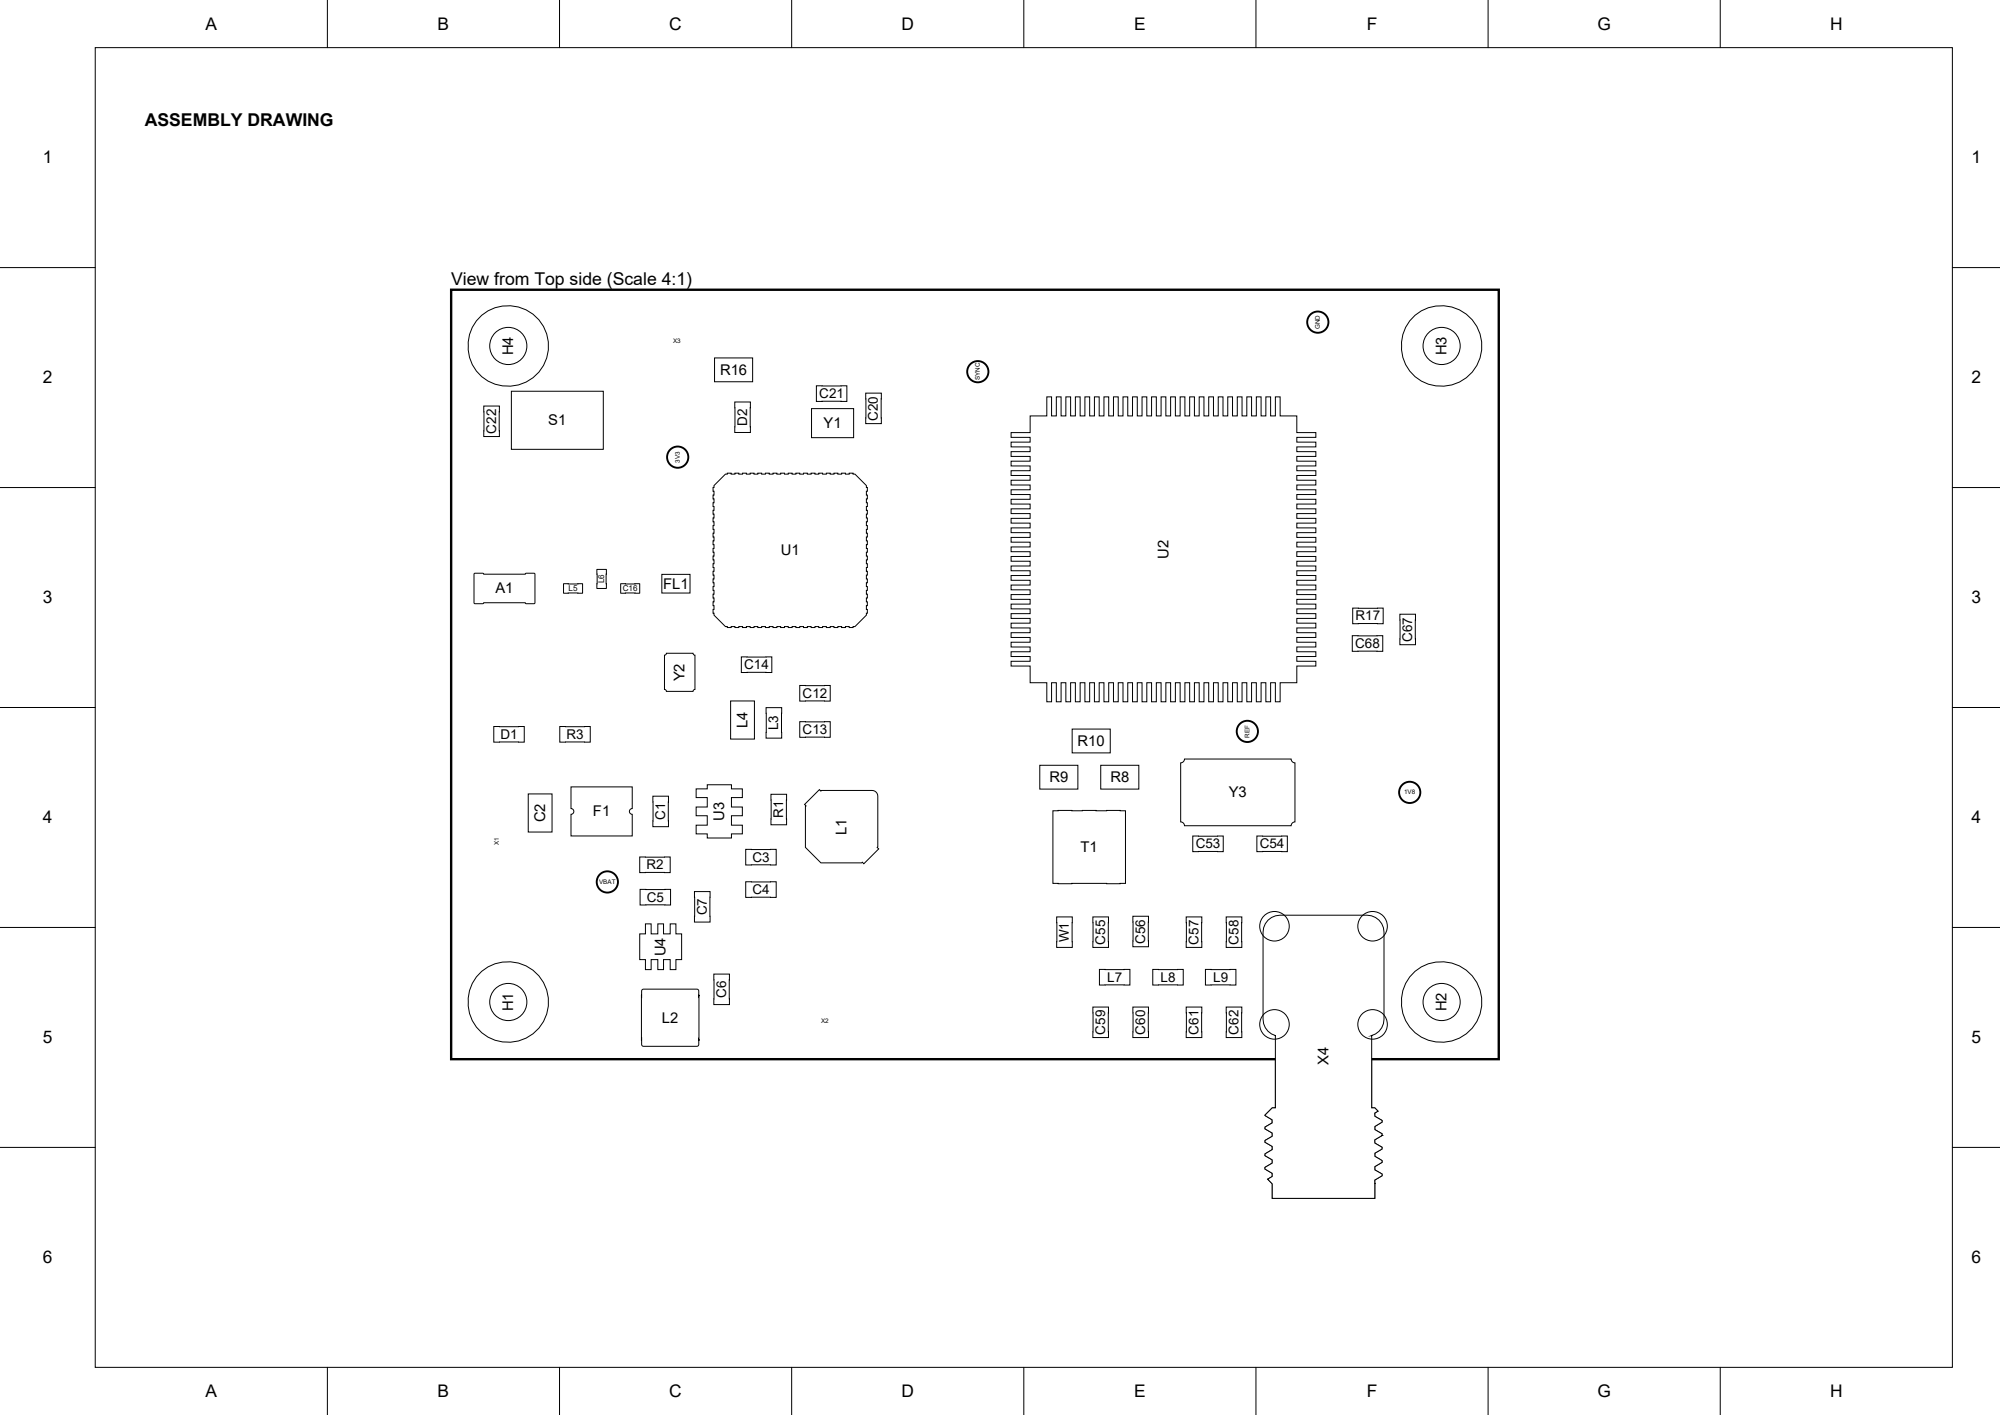
[picture p55: page 1]

View from Top side (Scale 4:1)

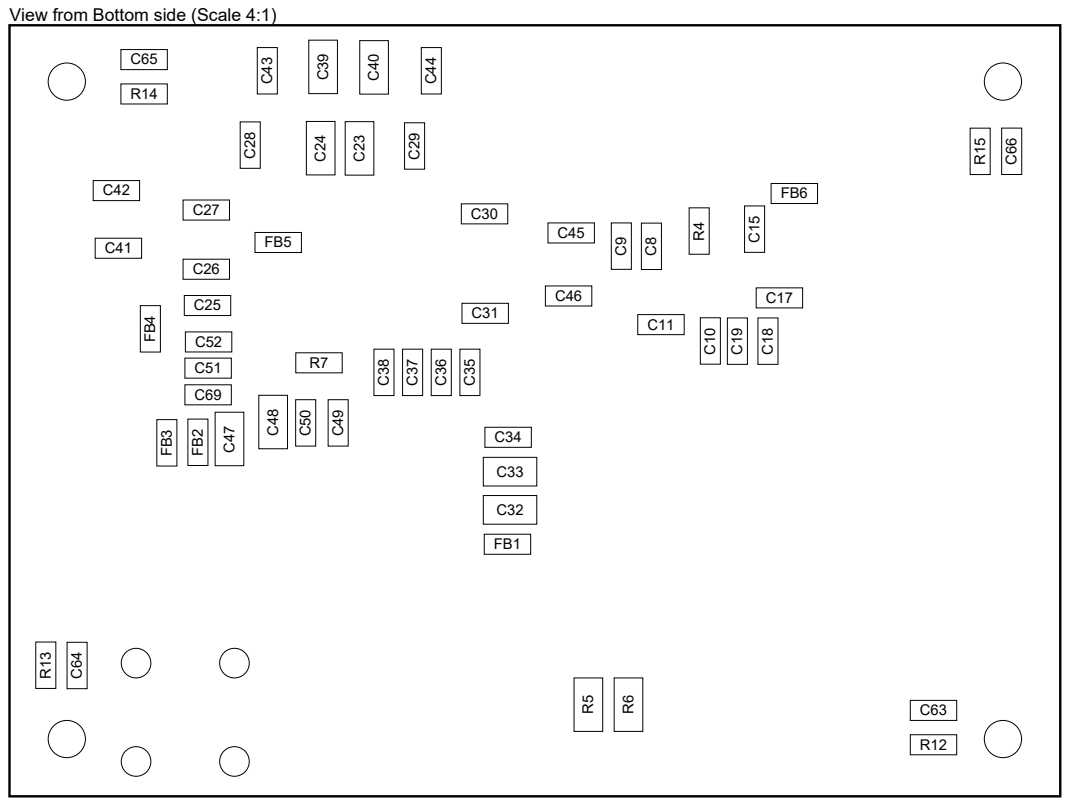
[picture p56: page 2]

View from Bottom side (Scale 4:1)
