vitobruncic-blip/zavrsni/pomocni projekti/Sinozic_Altium_BaterijskiGeneratorSignala/00_Altium_Baterijski_Generator_Signala/Project Outputs for Transmitter/Draftsman Output/Testpoint_Drawing.PDF

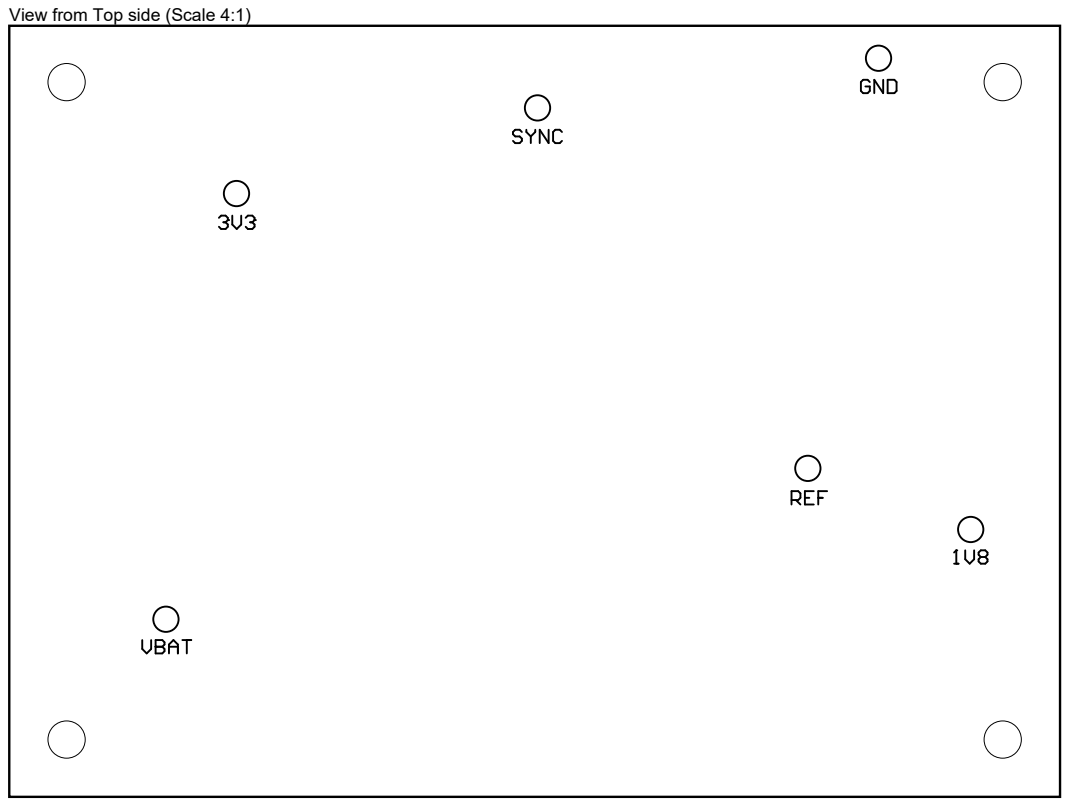
[picture p57: page 1]

View from Top side (Scale 4:1)
