vitobruncic-blip/zavrsni/IBC_prijamnik_VB/IBC_prijamnik_VB_ver1.pdf

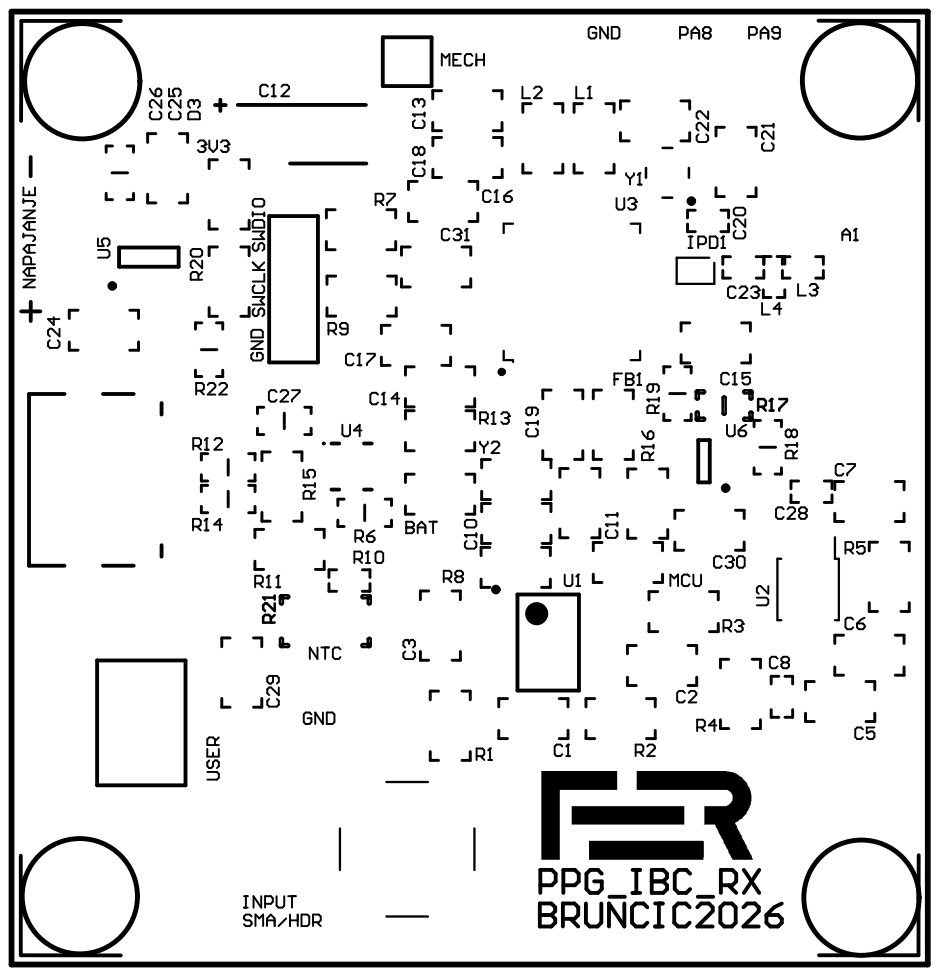
[picture p58: page 1]

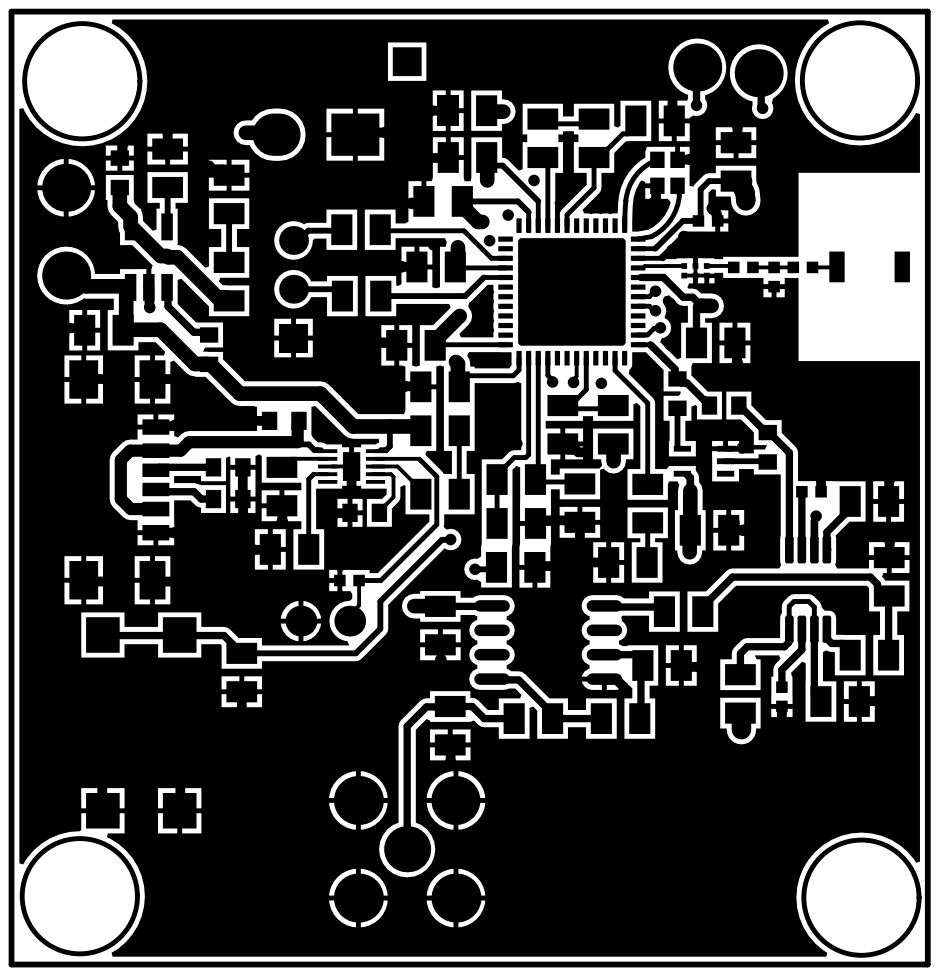
[picture p59: page 3]

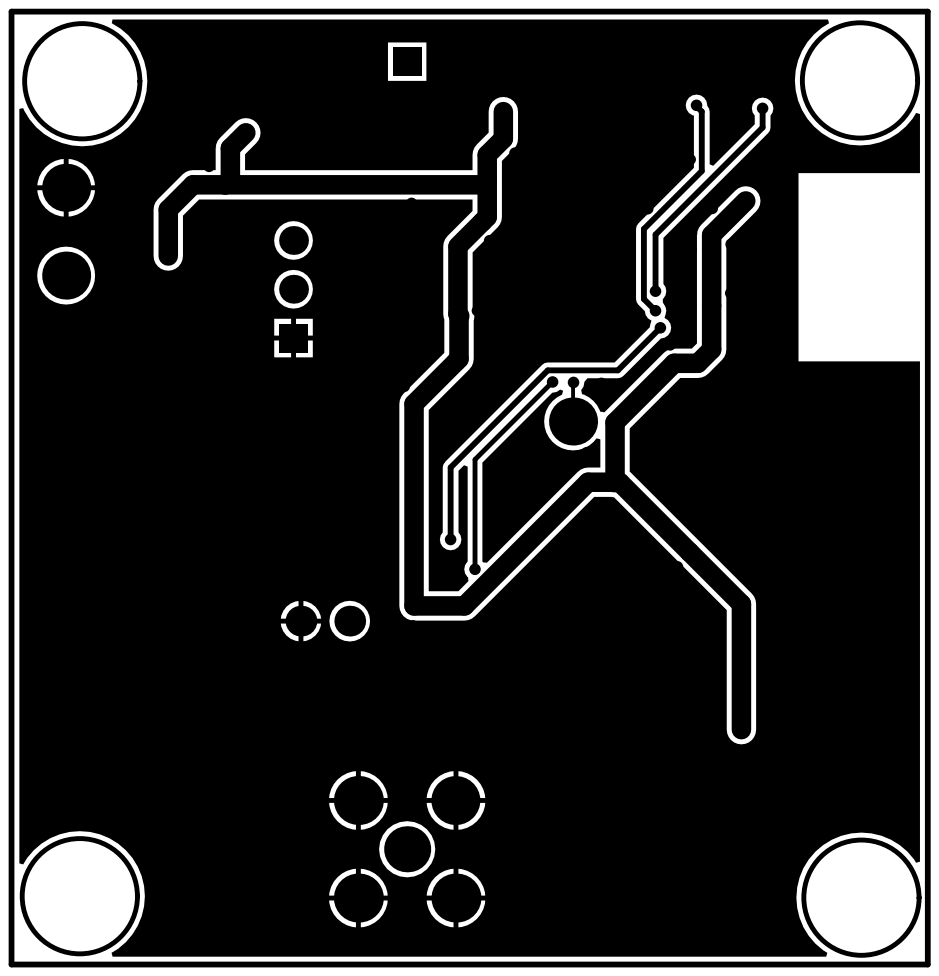
[picture p60: page 4]

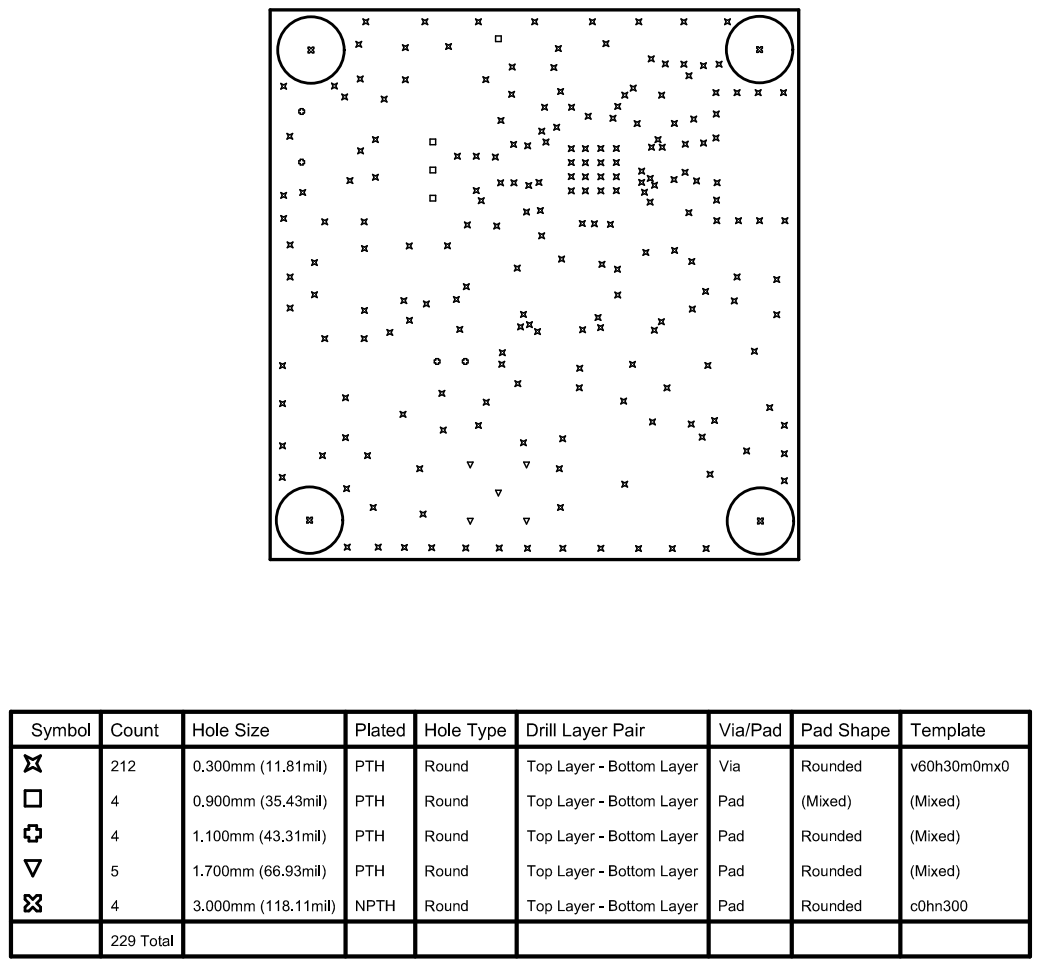
[picture p61: page 5]
