vitobruncic-blip/zavrsni/(list of files, drawings)

Other design files:
IBC_prijamnik_VB/ANTENA.SchDoc
IBC_prijamnik_VB/BUF_input.SchDoc
IBC_prijamnik_VB/CAPAE530X565N.PcbLib
IBC_prijamnik_VB/DZ1_Bruncic_Vito.PrjPcb
IBC_prijamnik_VB/DZ1_Bruncic_Vito.SchLib
IBC_prijamnik_VB/IBC_prijamnik_VB.PcbLib
IBC_prijamnik_VB/IBC_prijamnik_VB.PrjPcb
IBC_prijamnik_VB/IBC_prijamnik_VB_ver2.PcbDoc
IBC_prijamnik_VB/LOG_AMP.SchDoc
IBC_prijamnik_VB/MainSheet.SchDoc
IBC_prijamnik_VB/PWR_SUPPLY.SchDoc
IBC_prijamnik_VB/STM32.SchDoc
IBC_prijamnik_VB/USB4135-GF-A.SchLib
pomocni projekti/Sinozic_Altium_BaterijskiGeneratorSignala/00_Altium_Baterijski_Generator_Signala/01 Schematic/DDS_Out.SchDoc
pomocni projekti/Sinozic_Altium_BaterijskiGeneratorSignala/00_Altium_Baterijski_Generator_Signala/01 Schematic/DDS_Power_Supply.SchDoc
pomocni projekti/Sinozic_Altium_BaterijskiGeneratorSignala/00_Altium_Baterijski_Generator_Signala/01 Schematic/Mechanical.SchDoc
pomocni projekti/Sinozic_Altium_BaterijskiGeneratorSignala/00_Altium_Baterijski_Generator_Signala/01 Schematic/STM_Bluetooth.SchDoc
pomocni projekti/Sinozic_Altium_BaterijskiGeneratorSignala/00_Altium_Baterijski_Generator_Signala/01 Schematic/STM_DDS_GPIO.SchDoc
pomocni projekti/Sinozic_Altium_BaterijskiGeneratorSignala/00_Altium_Baterijski_Generator_Signala/01 Schematic/STM_Power_Supply.SchDoc
pomocni projekti/Sinozic_Altium_BaterijskiGeneratorSignala/00_Altium_Baterijski_Generator_Signala/02 PCB/Transmitter.PcbDoc
pomocni projekti/Sinozic_Altium_BaterijskiGeneratorSignala/00_Altium_Baterijski_Generator_Signala/03 Libraries/CustomFootprints.PcbLib
pomocni projekti/Sinozic_Altium_BaterijskiGeneratorSignala/00_Altium_Baterijski_Generator_Signala/03 Libraries/snapeda/ECS-196-S-23A-TR/ECS-196-S-23A-TR.SchLib
pomocni projekti/Sinozic_Altium_BaterijskiGeneratorSignala/00_Altium_Baterijski_Generator_Signala/03 Libraries/snapeda/ECS-196-S-23A-TR/XTAL_ECS-196-S-23A-TR.PcbLib
pomocni projekti/Sinozic_Altium_BaterijskiGeneratorSignala/00_Altium_Baterijski_Generator_Signala/03 Libraries/Transmitter.SchLib
pomocni projekti/Sinozic_Altium_BaterijskiGeneratorSignala/00_Altium_Baterijski_Generator_Signala/03 Libraries/Tx_board.SchLib
pomocni projekti/Sinozic_Altium_BaterijskiGeneratorSignala/00_Altium_Baterijski_Generator_Signala/Transmitter.PrjPcb
