vitobruncic-blip/zavrsni/(commit log)

2026-03-31 prvo slanje
    [ANTENA.SchDoc, BUF_input.SchDoc, IBC_prijamnik_Lib.SchLib, IBC_prijamnik_VB.PrjPcb, LOG_AMP.SchDoc, MainSheet.SchDoc, PWR_SUPPLY.SchDoc, STM32.SchDoc]
2026-03-31 nedovrseni bom
    [ANTENA.SchDoc, BUF_input.SchDoc, IBC_prijamnik_Lib.SchLib, IBC_prijamnik_VB.PrjPcb, LOG_AMP.SchDoc, MainSheet.SchDoc, PWR_SUPPLY.SchDoc, STM32.SchDoc]
2026-04-01 kučišta u BOM
    [ANTENA.SchDoc, BUF_input.SchDoc, IBC_prijamnik_Lib.SchLib, IBC_prijamnik_VB.PrjPcb, IBC_prijamnik_VB.xlsx, LOG_AMP.SchDoc, PWR_SUPPLY.SchDoc, STM32.SchDoc]
2026-04-08 dovršen BOM s 0R0
    [BUF_input.SchDoc, DZ1_Bruncic_Vito.SchLib, DZ1_Bruncic_Vito.xlsx, IBC_prijamnik_VB.PrjPcb, IBC_prijamnik_VB.xlsx, STM32.SchDoc]
2026-04-23 početak PCB dizajna
    [DZ1_Bruncic_Vito.SchLib, IBC_prijamnik_VB.PcbLib, IBC_prijamnik_VB.PrjPcb, IBC_prijamnik_VB.xlsx, IBC_prijamnik_VB_ver1.PcbDoc, PWR_SUPPLY.SchDoc, STM32.SchDoc]
2026-05-08 početak footprinta
    [CAPAE530X565N.PcbLib, IBC_prijamnik_VB.PcbLib, IBC_prijamnik_VB.PrjPcb, IBC_prijamnik_VB_ver1.PcbDoc]
2026-05-08 svi footprinti
    [ANTENA.SchDoc, BOM_final_10_01.xlsx, BUF_input.SchDoc, CustomFootprints.PcbLib, DDS_Out.SchDoc, DDS_Power_Supply.SchDoc, DZ1_Bruncic_Vito.SchLib, ECS-196-S-23A-TR.STEP]
2026-05-15 Pcb verzija1
    [ANTENA.SchDoc, BUF_input.SchDoc, Copy of IBC_prijamnik_VB_ver1.PcbDoc, DZ1_Bruncic_Vito.SchLib, IBC_prijamnik_VB.PcbLib, IBC_prijamnik_VB.PrjPcb, IBC_prijamnik_VB_ver1.PcbDoc, LOG_AMP.SchDoc]
2026-05-16 ispravljeni pcb
    [BUF_input.SchDoc, IBC_prijamnik_VB.PcbLib, IBC_prijamnik_VB.xlsx, IBC_prijamnik_VB_ver1.PcbDoc, LOG_AMP.SchDoc, PWR_SUPPLY.SchDoc, STM32.SchDoc]
2026-05-16 pcb izmjene
    [IBC_prijamnik_VB_ver1.PcbDoc]
2026-05-26 pes dokumentacija
    [DZ1_Bruncic_Vito.SchLib, IBC_prijamnik_VB.PcbLib, IBC_prijamnik_VB.xlsx, IBC_prijamnik_VB_ver1.PcbDoc]
